MomoRC-tech/MoGliFC-Flight-Controller/development/layout study.pptx

MoGliFC

ELRS ?

WIFI

STM32H743

UART 1-8

PWM1-8

ADC 1-4

BEC 6s->5V

BEEPER

WS2811 LED PWM

LDO MCU 5V->3.3V

LDO SENS 5V->3.3V

LEDs:
3V3 (r)
FC stat1 (g)
FC stat2 (b)

Boot Switch

BEC 6s->10V

IMU
BMI270

SPI1

I2C 2

Ext. I2C

Servo-Board

BEC VX 6s->5V

OSD
MAX7456

SPI2

Ext. SPI ?

Servo Out
1-8

FLASH
W25N01G

SPI3

(FD-) CAN
TJA1057GTK/3Z

BARO
DPS310

I2C 1

USB-C

MAG
HMC5883

I2C 1

SWD debug

## Slide 2

## Slide 3
