MomoRC-tech/MoGliFC-Flight-Controller/development/Requirements.xlsx

Sheet: requirements
domain | Wing | Drone | element | Requirement | component | bus
system | x | x | MCU | STM32H7xx w. FD-Can | STM32H743VIT6, 480MHz , 1MB RAM, 2MB Flash
system | x | x | IMU | 1, SPI | MPU6000, BMI088, ICM42688P (NOISE!), MPU9250 (w.magnetometer) | SPI
system |  |  | IMU2 | ???
system | x | x | Baro | 1 | Infineon DPS310 (I2C2) | I2C
system | x | x | OSD | 1, SPI | AT7456E (SPI2) | SPI
system | x | x | Blackbox | external flash | W25N01G (128MB) | SPI
system |  | x | Current sensor | ? (90A cont, 200A peak)
system | x | x | voltage sensing | 1 (2s - 6s)
system | x | x | LED | 3x LEDs for FC STATUS and 3.3V
system | x | x | Magnetometer | 1 | HMC5883 | I2C
system
system |  |  | VTX | ????
interfaces | x | x | UART | >4
interfaces | x |  | UART | inverted/non inverted selectable
interfaces | x | x | PWM out | >=8 (generic)
interfaces | x |  | I2C | 2
interfaces | x | x | CAN | 1x CAN-FD | TJA1057BTK TJA1057GTK/3 with silent pin
interfaces | x | x | ADC | 4 (VBAT, current, RSSI, Analog AirSpeed)
interfaces |  |  | JTAG | none
interfaces | x | x | SWD debug | 1x
interfaces | x |  | SPI breakout | (?)
interfaces | x | x | SPI internal | 2
interfaces | x |  | USB/Beep Extender with Typ-C (USB2.0) | 1
interfaces |  |  | Dual-Camera switching | (?)
interfaces | x | x | boot switch | 1
interfaces |  |  | softserial | softserial TX out support
interfaces |  |  | connector | JST connectors ???
interfaces | x | x | connector | USB-C onboard connector (flat)
interfaces | x | x | connector | 2nd USB-C daughter board connector
power | x | x | battery voltage | 2s - 6s
power | x | x | 5V BEC rail
power | x | x | parallel USB-in and battery protection
power | x | x | 3.3V rail
power | x |  | HV BEC rail | 4 PWM out must be configurable (solder bridge) for HV servos, 6-8.4V (2S), via external HV BEC
power | x | x | VTX camera power source | 5V/9V(12V) for camera/VTX switchable
power | x | x | OSD | OSD power configurable on/off (solder bridge)
power |  |  | ESC +/- and battery pads | ?
 |  |  | LED mode switch (see mamba MK4 H743)

Sheet: H743 target definition
 |  | MoGliFC | Matek | Mamba | implemented?
group | function | PIN | PIN | PIN
LED | LED0 blue | PE3 | PE3 | PE5
LED | LED1 green | PE4 | PE4 | PE4
Beeper | Bepper inv. | PA15 | PA15 | PE3
SPI1: IMU MP6000
SPI1 | SPI1_SCK_PIN | PA5 | PA5 | PA5
SPI1 | SPI1_MISO_PIN | PA6 | PA6 | PA6
SPI1 | SPI1_MOSI_PIN | PD7 | PD7 | PA7
SPI1 | MPU6000_CS_PIN | PC15 | PC15 | PA4

Sheet: Power calc
Calculated max. Power per component/rail
3V3 FC:
SUM | STM32H7 | Flash | Baro | Mag | IMU | OSD | external
1.00 A | 0.50 A | 0.00 A | 0.00 A | 0.00 A | 0.00 A | 0.20 A | 0.30 A
ELRS:
SUM | ESP32 pico D4 | SX1280 1 | AT2401C 1 | SX1280 2 | AT2401C 2
1.00 A
LDO loss:
Architecture:
 |  | U [V] | I[A] | P_loss[W]
Ubat |  | 20
 | loss
5V |  | 5 | 1
 | loss |  |  | 1.7
3V3 |  | 3.3 | 1

Sheet: price
price
STM32H7 | 7
flash | 1
Baro DPS310 | 1.4
BMI270 | 1.8
AT7456 OSD | 4.5
BEC 5V FC | 2.5
BEC 5V Vx | 3
BEC 10V | 2
LDOs | 2
CAN | 0.8
zeugs | 4
SUMME | 30
