MomoRC-tech/MoGliFC-Flight-Controller/development/01_datasheets/02_expressLRS/pico elrs standard pins.GIF

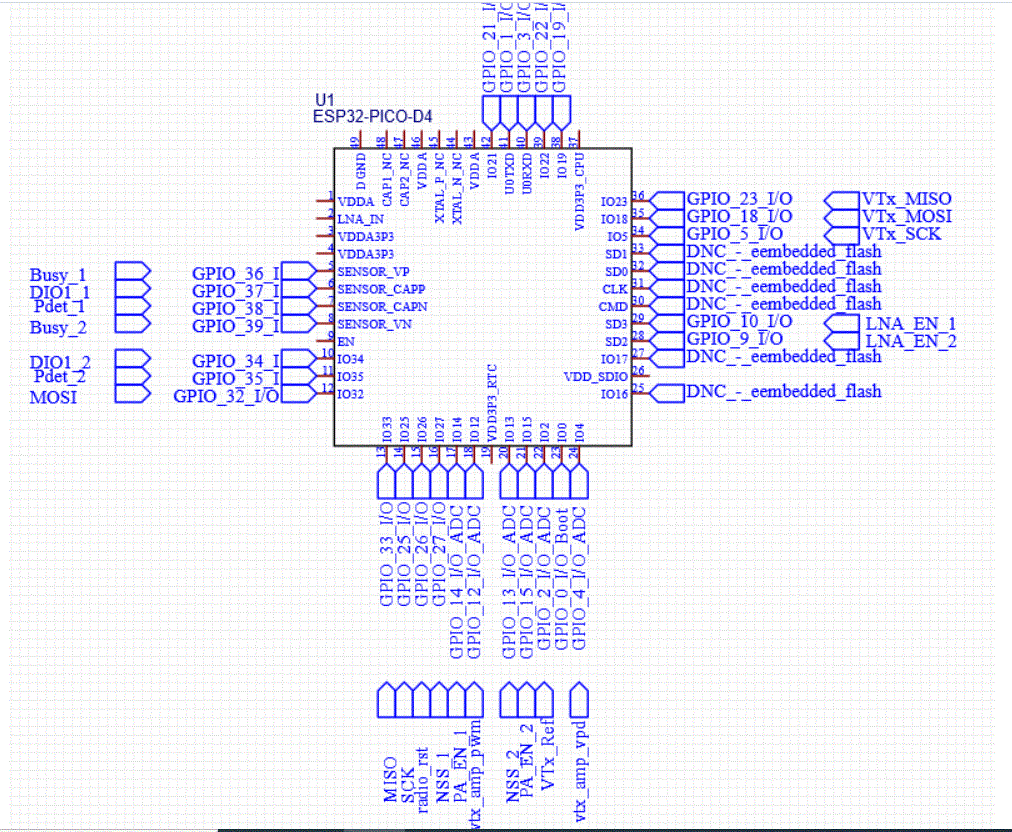
development/01_datasheets/02_expressLRS/pico elrs standard pins.GIF
