MomoRC-tech/MoGliFC-Flight-Controller/development/01_datasheets/02_expressLRS/SX1280 ref schematic.GIF

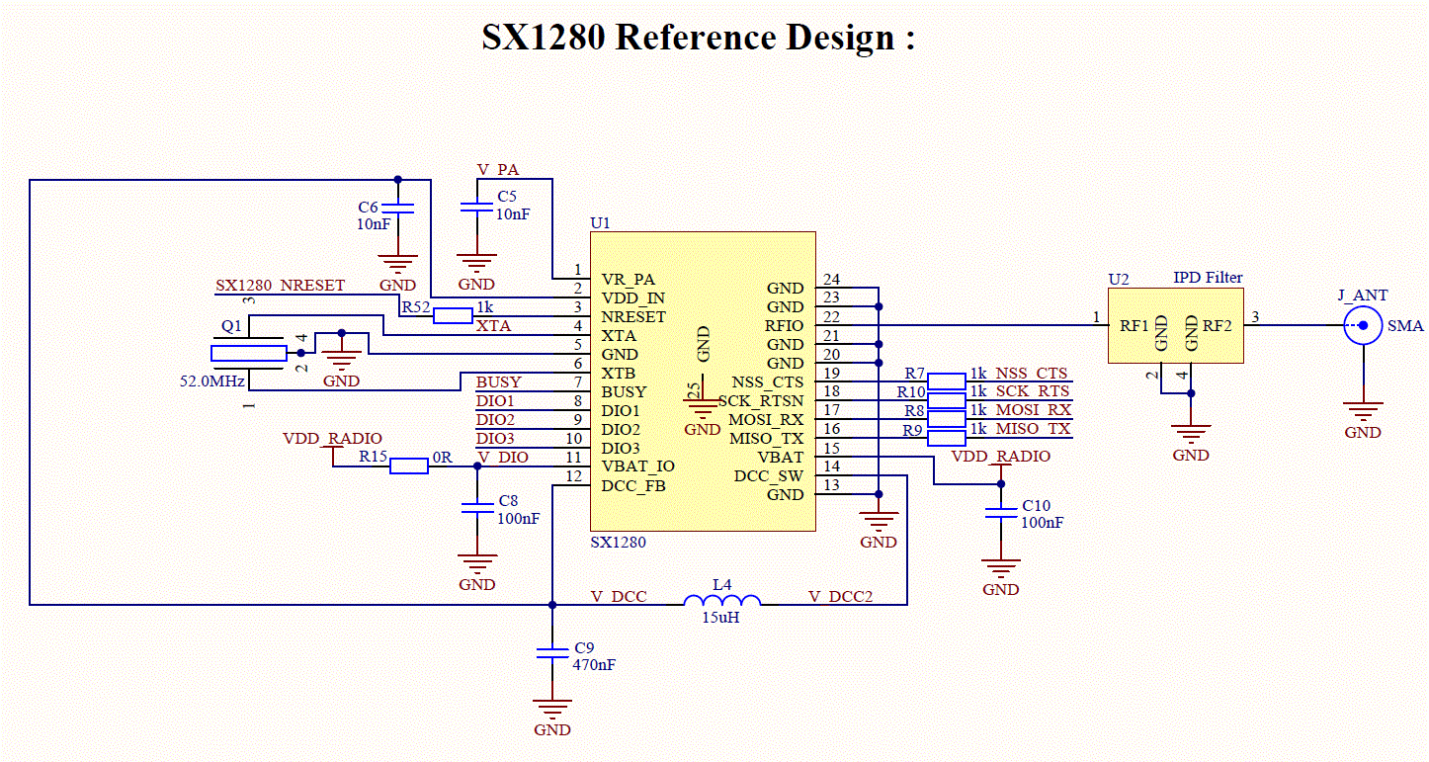
development/01_datasheets/02_expressLRS/SX1280 ref schematic.GIF
