MomoRC-tech/MoGliFC-Flight-Controller/development/10_KiCAD FC/images/BEC_FC.jpg

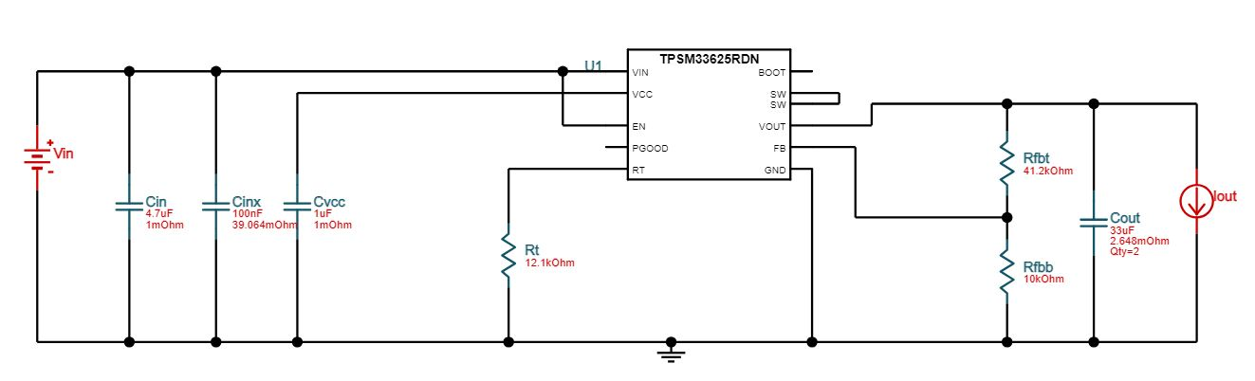
development/10_KiCAD FC/images/BEC_FC.jpg
