MomoRC-tech/MoGliFC-Flight-Controller/development/10_KiCAD FC/images/BEC_VTX.JPG

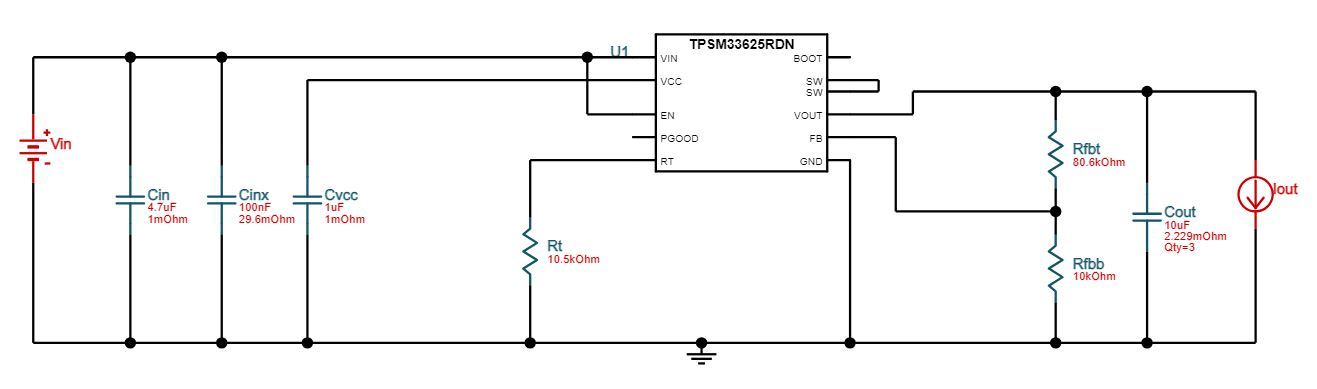
development/10_KiCAD FC/images/BEC_VTX.JPG
