MomoRC-tech/MoGliFC-Flight-Controller/development/10_KiCAD FC/images/BMI270_orientation.PNG

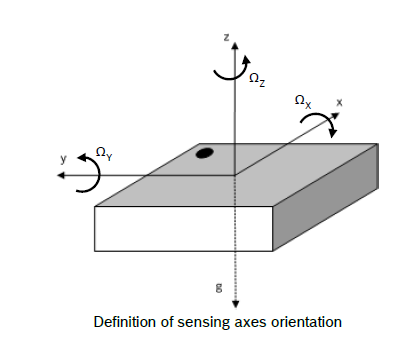
development/10_KiCAD FC/images/BMI270_orientation.PNG
