MomoRC-tech/MoGliFC-Flight-Controller/development/10_KiCAD FC/images/HMC5883L_orientation.PNG

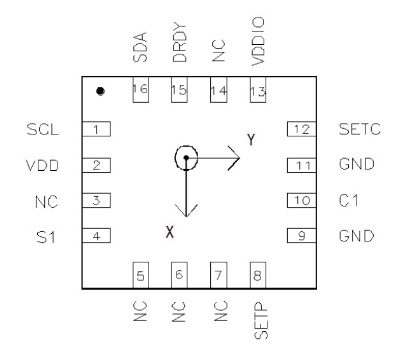
development/10_KiCAD FC/images/HMC5883L_orientation.PNG
