MomoRC-tech/MoGliFC-Flight-Controller/development/10_KiCAD FC/images/LP5912.PNG

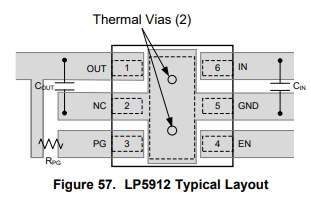
development/10_KiCAD FC/images/LP5912.PNG
