MomoRC-tech/MoGliFC-Flight-Controller/development/10_KiCAD FC/images/ReversePolarityProtection.JPG

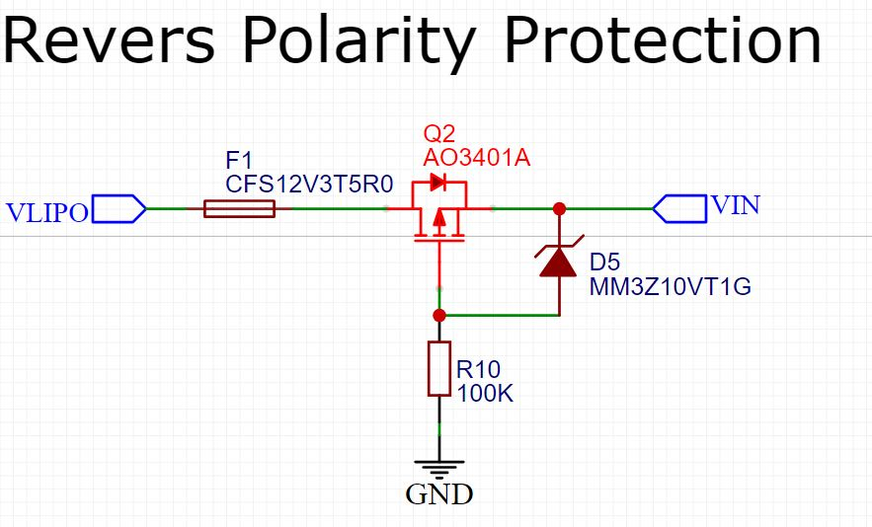
development/10_KiCAD FC/images/ReversePolarityProtection.JPG
