MomoRC-tech/MoGliFC-Flight-Controller/documentation/images/BOPLA_ALUBOS.png

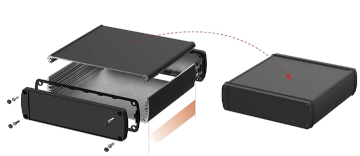
documentation/images/BOPLA_ALUBOS.png
