MomoRC-tech/MoGliFC-Flight-Controller/development/defines_INAV_H7_targets.xlsx

Sheet: Sheet
TARGETs in sheet: | 12
Define | # EMPTY CELLS | MOGLIFC |  | MAMBAH743 | MATEKH743 | AOCODARCH7DUAL | FOXEERH743 | IFLIGHT_2RAW_H743 | IFLIGHT_BLITZ_H7_PRO | IFLIGHT_H743_AIO_V2 | JHEH7AIO | JHEMCUH743HD | KAKUTEH7 | KAKUTEH7WING | NEUTRONRCH7BT | SDMODELH7V1 | SKYSTARSH743HD
TARGET_BOARD_IDENTIFIER | 14 |  |  | "M743" | "H743" | "AOH7" | "F743" | "2RH7" | "IB7P" | "IF7A" | "JH7A" | "JHEH743HD" | "KH7M" | "KH7W" | "NH7BT" | "SMH71" | "SSH7"
USBD_PRODUCT_STRING | 13 | "MOMOFCH743" |  | "MAMBAH743" |  | "AocodaRCH7Dual" | "FOXEERH743" | "IFLIGHT_2RAW_H743" | "IFLIGHT_BLITZ_H7_PRO" | "IFLIGHT_H743_AIO_V2" | "JHEH743AIO" | "JHEMCUH743HD" | "KAKUTEH7MINI" | "KAKUTEH7WING" | "NeuronRC H7 BT" | "SDMODELH7V1" | "SKYSTARSH743HD"
USE_TARGET_CONFIG | 13 | x |  | x | x | x | x |  | x | x | x | x | x | x | x | x | x
LED0 | 14 | PE5 | x | PE5 | PE3 | PE3 | PC13 | PE3 | PE3 | PC13 | PC13 | PE5 | PC2 | PC15 | PE3 | PC2 | PE3
LED1 | 9 | PE4 | x | PE4 | PE4 | PE4 |  | PE4 | PE4 |  |  | PE4 |  | PC14 | PE4 |  | PE4
BEEPER | 12 | PE3 | x | PE3 | PA15 | PA15 | PD2 | PC9 | PA15 |  |  | PE3 | PC13 | PB9 | PA15 | PC13 | PB3
BEEPER_INVERTED | 14 |  |  | x | x | x | x | x | x | x | x | x | x | x | x | x | x
BEEPER_PWM_FREQUENCY | 2 | 2500 |  |  | 2500 | 2500
USE_DUAL_GYRO | 5 | - |  | x | x | x |  |  |  |  |  | x |  |  |  |  | x
USE_TARGET_IMU_HARDWARE_DESCRIPTORS | 6 | x |  | x | x | x |  |  |  |  |  | x |  | x |  |  | x
USE_SPI | 14 | x |  | x | x | x | x | x | x | x | x | x | x | x | x | x | x
USE_SPI_DEVICE_1 | 14 | x |  | x | x | x | x | x | x | x | x | x | x | x | x | x | x
SPI1_SCK_PIN | 14 | PA5 |  | PA5 | PA5 | PA5 | PA5 | PA5 | PA5 | PA5 | PA5 | PA5 | PA5 | PA5 | PA5 | PA5 | PA5
SPI1_MISO_PIN | 14 | PA6 |  | PA6 | PA6 | PA6 | PA6 | PA6 | PA6 | PA6 | PA6 | PA6 | PA6 | PA6 | PA6 | PA6 | PA6
SPI1_MOSI_PIN | 14 | PA7 |  | PA7 | PD7 | PD7 | PA7 | PD7 | PD7 | PA7 | PA7 | PA7 | PA7 | PA7 | PD7 | PA7 | PD7
USE_IMU_MPU6000 | 9 | - |  | x | x | x | x |  |  | x | x | x | x |  |  | x
IMU_MPU6000_ALIGN | 9 | - |  | CW180_DEG | CW0_DEG_FLIP | CW0_DEG | CW0_DEG |  |  | CW0_DEG | CW0_DEG | CW180_DEG | CW270_DEG |  |  | CW270_DEG
MPU6000_SPI_BUS | 9 | - |  | BUS_SPI1 | BUS_SPI1 | BUS_SPI1 | BUS_SPI2 |  |  | BUS_SPI1 | BUS_SPI1 | BUS_SPI1 | BUS_SPI4 |  |  | BUS_SPI4
MPU6000_CS_PIN | 9 | - |  | PA4 | PC15 | PC15 | PB12 |  |  | SPI1_NSS_PIN | SPI1_NSS_PIN | PA4 | PE4 |  |  | PE4
MPU6000_EXTI_PIN | 1 | - |  |  |  | PB2
USE_IMU_BMI270 | 8 | x |  | x |  | x |  |  |  | x |  | x | x |  | x | x | x
IMU_BMI270_ALIGN_1 | 1 | - |  |  |  | CW90_DEG
BMI270_SPI_BUS_1 | 1 | - |  |  |  | BUS_SPI1
BMI270_CS_PIN_1 | 1 | - |  |  |  | PC15
BMI270_EXTI_PIN_1 | 1 | - |  |  |  | PB2
USE_SPI_DEVICE_4 | 10 |  |  | x | x | x |  |  | x | x | x |  | x |  | x | x | x
SPI4_SCK_PIN | 10 |  |  | PE12 | PE12 | PE12 |  |  | PE12 | PE2 | PE2 |  | PE2 |  | PE12 | PE2 | PE12
SPI4_MISO_PIN | 10 |  |  | PE13 | PE13 | PE13 |  |  | PE13 | PE5 | PE5 |  | PE5 |  | PE13 | PE5 | PE13
SPI4_MOSI_PIN | 10 |  |  | PE14 | PE14 | PE14 |  |  | PE14 | PE6 | PE6 |  | PE6 |  | PE14 | PE6 | PE14
IMU_BMI270_ALIGN_2 | 1 |  |  |  |  | CW180_DEG
BMI270_SPI_BUS_2 | 1 |  |  |  |  | BUS_SPI4
BMI270_CS_PIN_2 | 1 |  |  |  |  | PE11
BMI270_EXTI_PIN_2 | 1 |  |  |  |  | PE15
USE_SPI_DEVICE_2 | 13 | x |  | x |  | x | x | x | x | x | x | x | x | x | x | x | x
SPI2_SCK_PIN | 13 | PB13 |  | PB13 |  | PB13 | PB13 | PB13 | PB13 | PB13 | PB13 | PB13 | PB13 | PD3 | PB13 | PB13 | PB13
SPI2_MISO_PIN | 13 | PB14 |  | PB14 |  | PB14 | PB14 | PB14 | PB14 | PB14 | PB14 | PB14 | PB14 | PC2 | PB14 | PB14 | PB14
SPI2_MOSI_PIN | 13 | PB15 |  | PB15 |  | PB15 | PB15 | PB15 | PB15 | PB15 | PB15 | PB15 | PB15 | PC3 | PB15 | PB15 | PB15
USE_MAX7456 | 12 | x |  | x |  | x | x |  | x | x | x | x | x | x | x | x | x
MAX7456_SPI_BUS | 12 | BUS_SPI2 |  | BUS_SPI2 |  | BUS_SPI2 | BUS_SPI1 |  | BUS_SPI2 | BUS_SPI4 | BUS_SPI4 | BUS_SPI2 | BUS_SPI2 | BUS_SPI2 | BUS_SPI2 | BUS_SPI2 | BUS_SPI2
MAX7456_CS_PIN | 12 | PB12 |  | PB12 |  | PB12 | PA4 |  | PB12 | SPI4_NSS_PIN | SPI4_NSS_PIN | PB12 | PB12 | PB12 | PB12 | PB12 | PB12
USE_SPI_DEVICE_3 | 11 | x |  | x | x | x | x | x | x | x | x | x |  | x |  |  | x
SPI3_NSS_PIN | 6 | PA15 |  | PA15 |  | PD3 | PA15 |  |  | PA15 | PA15 | PA15
SPI3_SCK_PIN | 11 | PC10 |  | PC10 | PB3 | PB3 | PC10 | PC10 | PB3 | PC10 | PC10 | PC10 |  | PC10 |  |  | PC10
SPI3_MISO_PIN | 11 | PC11 |  | PC11 | PB4 | PB4 | PC11 | PC11 | PB4 | PC11 | PC11 | PC11 |  | PC11 |  |  | PC11
SPI3_MOSI_PIN | 11 | PB5 |  | PB2 | PB5 | PB5 | PC12 | PC12 | PB5 | PC12 | PC12 | PB2 |  | PC12 |  |  | PC12
SPI3_SCK_AF | 3 | GPIO_AF6_SPI3 |  | GPIO_AF6_SPI3 |  | GPIO_AF6_SPI3 |  |  |  |  |  | GPIO_AF6_SPI3
SPI3_MISO_AF | 3 | GPIO_AF6_SPI3 |  | GPIO_AF6_SPI3 |  | GPIO_AF6_SPI3 |  |  |  |  |  | GPIO_AF6_SPI3
SPI3_MOSI_AF | 3 | GPIO_AF7_SPI3 |  | GPIO_AF7_SPI3 |  | GPIO_AF7_SPI3 |  |  |  |  |  | GPIO_AF7_SPI3
W25N01G_SPI_BUS | 7 | BUS_SPI3 |  | BUS_SPI3 |  | BUS_SPI3 | BUS_SPI3 |  |  |  |  | BUS_SPI3 | BUS_SPI1 |  |  | BUS_SPI1 | BUS_SPI3
W25N01G_CS_PIN | 7 | SPI3_NSS_PIN |  | SPI3_NSS_PIN |  | SPI3_NSS_PIN | SPI3_NSS_PIN |  |  |  |  | SPI3_NSS_PIN | PA4 |  |  | PA4 | PA15
USE_BLACKBOX | 4 | x |  | x |  | x | x |  |  |  |  | x
USE_FLASHFS | 9 | x |  | x |  | x | x |  |  | x | x | x | x |  |  | x | x
USE_FLASH_W25N01G | 6 | x |  | x |  | x | x |  |  |  |  | x | x |  |  | x
ENABLE_BLACKBOX_LOGGING_ON_SPIFLASH_BY_DEFAULT | 9 | x |  | x |  | x | x |  |  | x | x | x | x |  |  | x | x
USE_I2C | 14 | x |  | x | x | x | x | x | x | x | x | x | x | x | x | x | x
USE_I2C_DEVICE_1 | 14 | x |  | x | x | x | x | x | x | x | x | x | x | x | // I2C1 is the broken out I2C bus | x | x
I2C1_SCL | 14 | PB6 |  | PB6 | PB6 | PB6 | PB8 | PB6 | PB6 | PB8 | PB8 | PB6 | PB6 | PB8 | PB6 | PB6 | PB8
I2C1_SDA | 14 | PB7 |  | PB7 | PB7 | PB7 | PB9 | PB7 | PB7 | PB9 | PB9 | PB7 | PB7 | PB7 | PB7 | PB7 | PB9
USE_I2C_DEVICE_2 | 10 | x |  | x | x | x |  | x | x | x |  | x |  | x | // I2C2 is not broken out |  | x
I2C2_SCL | 10 | PB10 |  | PB10 | PB10 | PB10 |  | PB10 | PB10 | PB10 |  | PB10 |  | PB10 | PB10 |  | PB10
I2C2_SDA | 10 | PB11 |  | PB11 | PB11 | PB11 |  | PB11 | PB11 | PB11 |  | PB11 |  | PB11 | PB11 |  | PB11
USE_BARO | 14 | x |  | x | x | x | x | x | x | x | x | x | x | x | x | x | x
BARO_I2C_BUS | 14 | BUS_I2C1 |  | BUS_I2C1 | BUS_I2C2 | BUS_I2C2 | BUS_I2C1 | BUS_I2C2 | BUS_I2C2 | BUS_I2C1 | BUS_I2C1 | BUS_I2C1 | BUS_I2C1 | BUS_I2C4 | BUS_I2C2 | BUS_I2C1 | BUS_I2C2
USE_BARO_BMP280 | 11 | x |  | x | x | x | x |  |  | x | x |  | x | x | x | x | x
USE_BARO_MS5611 | 11 | x |  | x | x | x | x |  |  | x | x |  | x | x | x | x | x
USE_BARO_DPS310 | 11 | x |  | x | x | x | x |  |  | x | x |  | x | x | x | x | x
USE_BARO_SPL06 | 9 | - |  | x | x | x | x |  |  |  |  |  | x | x | x | x | x
USE_MAG | 14 | x |  | x | x | x | x | x | x | x | x | x | x | x | x | x | x
MAG_I2C_BUS | 14 | BUS_I2C1 |  | BUS_I2C1 | BUS_I2C1 | BUS_I2C1 | BUS_I2C1 | BUS_I2C1 | BUS_I2C1 | BUS_I2C2 | BUS_I2C1 | BUS_I2C1 | BUS_I2C1 | BUS_I2C1 | BUS_I2C1 | BUS_I2C1 | BUS_I2C1
USE_MAG_ALL | 14 | x |  | x | x | x | x | x | x | x | x | x | x | x | x | x | x
TEMPERATURE_I2C_BUS | 14 | BUS_I2C1 |  | BUS_I2C1 | BUS_I2C2 | BUS_I2C1 | BUS_I2C1 | BUS_I2C1 | BUS_I2C2 | BUS_I2C2 | BUS_I2C1 | BUS_I2C1 | BUS_I2C1 | BUS_I2C2 | BUS_I2C1 | BUS_I2C1 | BUS_I2C1
PITOT_I2C_BUS | 14 | BUS_I2C1 |  | BUS_I2C1 | BUS_I2C2 | BUS_I2C1 | BUS_I2C1 | BUS_I2C1 | BUS_I2C2 | BUS_I2C2 | BUS_I2C1 | BUS_I2C1 | BUS_I2C1 | BUS_I2C2 | BUS_I2C1 | BUS_I2C1 | BUS_I2C1
USE_RANGEFINDER | 13 | x |  | x | x | x | x |  | x | x | x | x | x | x | x | x | x
RANGEFINDER_I2C_BUS | 14 | BUS_I2C1 |  | BUS_I2C1 | BUS_I2C1 | BUS_I2C1 | BUS_I2C1 | BUS_I2C1 | BUS_I2C1 | BUS_I2C2 | BUS_I2C1 | BUS_I2C1 | BUS_I2C1 | BUS_I2C2 | BUS_I2C1 | BUS_I2C1 | BUS_I2C1
USE_VCP | 14 | x |  | x | x | x | x | x | x | x | x | x | x | x | x | x | x
VBUS_SENSING_PIN | 2 | - |  |  |  | PE2 |  |  |  |  |  |  |  | PA9
VBUS_SENSING_ENABLED | 2 | - |  |  |  | x |  |  |  |  |  |  |  | x
USE_UART1 | 14 | x |  | x | x | x | x | x | x | x | x | x | x | x | x | x | x
UART1_TX_PIN | 14 | PA9 |  | PA9 | PA9 | PA9 | PA9 | PA9 | PA9 | PA9 | PA9 | PA9 | PA9 | PB6 | PA9 | PA9 | PA9
UART1_RX_PIN | 14 | PA10 |  | PA10 | PA10 | PA10 | PA10 | PA10 | PA10 | PA10 | PA10 | PA10 | PA10 | PA10 | PA10 | PA10 | PA10
USE_UART2 | 14 | x |  | x | x | x | x | x | x | x | x | x | x | x | x | x | x
UART2_TX_PIN | 14 | PD5 |  | PD5 | PD5 | PD5 | PA2 | PD5 | PD5 | PA2 | PA2 | PD5 | PD5 | PD5 | PD5 | PD5 | PD5
UART2_RX_PIN | 14 | PD6 |  | PD6 | PD6 | PD6 | PA3 | PD6 | PD6 | PA3 | PA3 | PD6 | PD6 | PD6 | PD6 | PD6 | PD6
USE_UART3 | 13 | x |  | x | x | x | x | x | x |  | x | x | x | x | x | x | x
UART3_TX_PIN | 13 | PD8 |  | PD8 | PD8 | PD8 | PB10 | PD8 | PD8 |  | PB10 | PD8 | PD8 | PD8 | PD8 | PD8 | PD8
UART3_RX_PIN | 13 | PD9 |  | PD9 | PD9 | PD9 | PB11 | PD9 | PD9 |  | PB11 | PD9 | PD9 | PD9 | PD9 | PD9 | PD9
USE_UART4 | 13 | x |  | x | x | x | x | x | x | x | x | x | x |  | x | x | x
UART4_TX_PIN | 13 | PB9 |  | PD1 | PB9 | PB9 | PA0 | PB9 | PB9 | PA0 | PA0 | PD1 | PD1 |  | PB9 | PD1 | PD1
UART4_RX_PIN | 13 | PB8 |  | PD0 | PB8 | PB8 | PA1 | PB8 | PB8 | PA1 | PA1 | PD0 | PD0 |  | PB8 | PD0 | PD0
USE_UART5 | 4 | x |  | x |  |  |  |  |  |  |  | x |  | x |  |  | x
UART5_TX_PIN | 4 | PC12 |  | PC12 |  |  |  |  |  |  |  | PC12 |  | PB13 |  |  | PB6
UART5_RX_PIN | 4 | PD2 |  | PD2 |  |  |  |  |  |  |  | PD2 |  | PD2 |  |  | PB5
USE_UART6 | 14 | x |  | x | x | x | x | x | x | x | x | x | x | x | x | x | x
UART6_TX_PIN | 14 | PC6 |  | PC6 | PC6 | PC6 | PC6 | PC6 | PC6 | PC6 | PC6 | PC6 | PC6 | PC6 | PC6 | PC6 | PC6
UART6_RX_PIN | 14 | PC7 |  | PC7 | PC7 | PC7 | PC7 | PC7 | PC7 | PC7 | PC7 | PC7 | PC7 | PC7 | PC7 | PC7 | PC7
USE_UART7 | 14 | x |  | x | x | x | x | x | x | x | x | x | x | x | x | x | x
UART7_TX_PIN | 12 | PE8 |  | PE8 | PE8 | PE8 | PE8 | PE8 | PE8 | PE8 | PE8 | PE8 |  | PE8 | PE8 |  | PE8
UART7_RX_PIN | 14 | PE7 |  | PE7 | PE7 | PE7 | PE7 | PE7 | PE7 | PE7 | PE7 | PE7 | PE7 | PE7 | PE7 | PE7 | PE7
USE_UART8 | 12 | x |  | x | x | x | x | x | x | x | x | x |  | x | x |  | x
UART8_TX_PIN | 12 | PE1 |  | PE1 | PE1 | PE1 | PE1 | PE1 | PE1 | PE1 | PE1 | PE1 |  | PE1 | PE1 |  | PE1
UART8_RX_PIN | 12 | PE0 |  | PE0 | PE0 | PE0 | PE0 | PE0 | PE0 | PE0 | PE0 | PE0 |  | PE0 | PE0 |  | PE0
SERIAL_PORT_COUNT | 14 | 9 |  | 9 | 9 | 8 | 8 | 8 | 8 | 7 | 8 | 9 | 7 | 8 | 8 | 7 | 9
DEFAULT_RX_TYPE | 14 | RX_TYPE_SERIAL |  | RX_TYPE_SERIAL | RX_TYPE_SERIAL | RX_TYPE_SERIAL | RX_TYPE_SERIAL | RX_TYPE_SERIAL | RX_TYPE_SERIAL | RX_TYPE_SERIAL | RX_TYPE_SERIAL | RX_TYPE_SERIAL | RX_TYPE_SERIAL | RX_TYPE_SERIAL | RX_TYPE_SERIAL | RX_TYPE_SERIAL | RX_TYPE_SERIAL
SERIALRX_PROVIDER | 14 | SERIALRX_CRSF |  | SERIALRX_SBUS | SERIALRX_CRSF | SERIALRX_SBUS | SERIALRX_SBUS | SERIALRX_CRSF | SERIALRX_CRSF | SERIALRX_CRSF | SERIALRX_CRSF | SERIALRX_SBUS | SERIALRX_SBUS | SERIALRX_SBUS | SERIALRX_SBUS | SERIALRX_SBUS | SERIALRX_SBUS
USE_ADC | 14 | x |  | x | x | x | x | x | x | x | x | x | x | x | x | x | x
ADC_INSTANCE | 14 | ADC3 |  | ADC3 | ADC1 | ADC1 | ADC3 | ADC1 | ADC1 | ADC3 | ADC3 | ADC3 | ADC1 | ADC1 | ADC1 | ADC1 | ADC1
ADC_CHANNEL_1_PIN | 14 | PC1 |  | PC1 | PC0 //ADC123 VBAT1 | PC0 //ADC123 VBAT1 | PC3 | PC0 | PC0 //ADC123 VBAT1 | PC3 | PC3 | PC1 | PC0 | PC5 //VBAT1 | PC0 // VBAT1 | PC0 | PC0 //ADC123 VBAT1
ADC_CHANNEL_2_PIN | 14 | PC3 |  | PC3 | PC1 //ADC123 CURR1 | PC1 //ADC123 CURR1 | PC5 | PC1 | PC1 //ADC123 CURR1 | PC2 | PC2 | PC3 | PC5 | PC4 //CURR1 | PC1 // CURR1 | PC5 | PC1 //ADC123 CURR1
ADC_CHANNEL_3_PIN | 14 | PC2 |  | PC2 | PC5 //ADC12 RSSI | PC5 //ADC12 RSSI | PC2 | PC5 | PC5 //ADC12 RSSI | PC5 | PC5 | PC2 | PC1 | PC0 //RSSI | PC4 // AirS | PC1 | PC3 //ADC12 RSSI
ADC_CHANNEL_4_PIN | 8 | PC0 |  | PC0 | PC4 //ADC12 AirS | PC4 //ADC12 AirS |  | PC4 | PC4 //ADC12 AirS |  |  | PC0 |  |  | PA4 // VBAT2 |  | PC4 //ADC12 AirS
ADC_CHANNEL_5_PIN | 4 |  |  |  | PA4 //ADC12 VB2 | PA4 //ADC12 VB2 |  |  |  |  |  |  |  | PA3 //VB2 | PA7 // CURR2
ADC_CHANNEL_6_PIN | 3 |  |  |  | PA7 //ADC12 CU2 | PA7 //ADC12 CU2 |  |  |  |  |  |  |  | PA2 //CU2
VBAT_ADC_CHANNEL | 14 | ADC_CHN_1 |  | ADC_CHN_1 | ADC_CHN_1 | ADC_CHN_1 | ADC_CHN_1 | ADC_CHN_1 | ADC_CHN_1 | ADC_CHN_1 | ADC_CHN_1 | ADC_CHN_1 | ADC_CHN_1 | ADC_CHN_1 | ADC_CHN_1 | ADC_CHN_1 | ADC_CHN_1
CURRENT_METER_ADC_CHANNEL | 14 | ADC_CHN_2 |  | ADC_CHN_2 | ADC_CHN_2 | ADC_CHN_2 | ADC_CHN_3 | ADC_CHN_2 | ADC_CHN_2 | ADC_CHN_2 | ADC_CHN_2 | ADC_CHN_2 | ADC_CHN_3 | ADC_CHN_2 | ADC_CHN_2 | ADC_CHN_3 | ADC_CHN_2
RSSI_ADC_CHANNEL | 13 | ADC_CHN_3 |  | ADC_CHN_3 | ADC_CHN_3 | ADC_CHN_3 | ADC_CHN_2 | ADC_CHN_3 | ADC_CHN_3 | ADC_CHN_3 | ADC_CHN_3 | ADC_CHN_3 | ADC_CHN_2 | ADC_CHN_3 |  | ADC_CHN_2 | ADC_CHN_3
AIRSPEED_ADC_CHANNEL | 8 | ADC_CHN_4 |  | ADC_CHN_4 | ADC_CHN_4 | ADC_CHN_4 |  | ADC_CHN_4 | ADC_CHN_4 |  |  | ADC_CHN_4 |  |  | ADC_CHN_3 |  | ADC_CHN_4
USE_PINIO | 11 | x |  | x | x | x |  | x | x |  |  | x | x | x | x | x | x
USE_PINIOBOX | 11 | x |  | x | x | x |  | x | x |  |  | x | x | x | x | x | x
PINIO1_PIN | 11 | PD10 // VTX power switcher |  | PC5 | PD10 // VTX power switcher | PD10 // VTX power switcher |  | PD10 | PD10 // VTX power switcher |  |  | PC2 | PE13 | PC13 // VTX power switcher | PD10 // Vsw control | PE13 | PC5 // VTX power switcher
PINIO2_PIN | 11 | PD11 // 2xCamera switcher |  | PC5 | PD11 // 2xCamera switcher | PD11 // 2xCamera switcher |  | PD11 | PD11 // 2xCamera switcher |  |  | PC5 | PB11 | PE3 // 2xCamera switcher | PD11 // Cam1/Cam2 switch control | PB11 | PC2 // 2xCamera switcher
USE_LED_STRIP | 13 | x |  | x | x | x | x |  | x | x | x | x | x | x | x | x | x
WS2811_PIN | 13 | PA8 |  | PA8 | PA8 | PA8 | PA8 |  | PA8 | PA8 | PD12 | PA8 | PD12 | PA15 | PA8 | PD12 | PA8
DEFAULT_FEATURES | 14 | (FEATURE_OSD | FEATURE_TELEMETRY | FEATURE_CURRENT_METER | FEATURE_VBAT | FEATURE_TX_PROF_SEL | FEATURE_BLACKBOX) |  | (FEATURE_OSD | FEATURE_TELEMETRY | FEATURE_CURRENT_METER | FEATURE_VBAT | FEATURE_TX_PROF_SEL) | (FEATURE_OSD | FEATURE_TELEMETRY | FEATURE_CURRENT_METER | FEATURE_VBAT | FEATURE_TX_PROF_SEL | FEATURE_BLACKBOX) | (FEATURE_OSD | FEATURE_TELEMETRY | FEATURE_CURRENT_METER | FEATURE_VBAT | FEATURE_TX_PROF_SEL | FEATURE_BLACKBOX) | (FEATURE_OSD | FEATURE_TELEMETRY | FEATURE_CURRENT_METER | FEATURE_VBAT | FEATURE_TX_PROF_SEL) | (FEATURE_OSD | FEATURE_TELEMETRY | FEATURE_CURRENT_METER | FEATURE_VBAT | FEATURE_TX_PROF_SEL | FEATURE_BLACKBOX) | (FEATURE_OSD | FEATURE_TELEMETRY | FEATURE_CURRENT_METER | FEATURE_VBAT | FEATURE_TX_PROF_SEL | FEATURE_BLACKBOX) | (FEATURE_OSD | FEATURE_TELEMETRY | FEATURE_CURRENT_METER | FEATURE_VBAT | FEATURE_TX_PROF_SEL | FEATURE_BLACKBOX) | (FEATURE_OSD | FEATURE_TELEMETRY | FEATURE_CURRENT_METER | FEATURE_VBAT | FEATURE_TX_PROF_SEL | FEATURE_BLACKBOX) | (FEATURE_OSD | FEATURE_TELEMETRY | FEATURE_CURRENT_METER | FEATURE_VBAT | FEATURE_TX_PROF_SEL) | (FEATURE_OSD | FEATURE_TELEMETRY | FEATURE_CURRENT_METER | FEATURE_VBAT | FEATURE_TX_PROF_SEL | FEATURE_BLACKBOX) | (FEATURE_OSD | FEATURE_TELEMETRY | FEATURE_CURRENT_METER | FEATURE_VBAT | FEATURE_TX_PROF_SEL | FEATURE_BLACKBOX | FEATURE_GPS) | (FEATURE_OSD | FEATURE_TELEMETRY | FEATURE_CURRENT_METER | FEATURE_VBAT | FEATURE_TX_PROF_SEL | FEATURE_BLACKBOX) | (FEATURE_OSD | FEATURE_TELEMETRY | FEATURE_CURRENT_METER | FEATURE_VBAT | FEATURE_TX_PROF_SEL | FEATURE_BLACKBOX) | (FEATURE_OSD | FEATURE_TELEMETRY | FEATURE_CURRENT_METER | FEATURE_VBAT | FEATURE_TX_PROF_SEL | FEATURE_BLACKBOX)
CURRENT_METER_SCALE | 14 |  |  | 250 | 250 | 250 | 100 | 250 | 212 | 100 | 100 | 250 | 250 | 3660 // 36.6 | 250 | 250 | 290
USE_SERIAL_4WAY_BLHELI_INTERFACE | 14 | x |  | x | x | x | x | x | x | x | x | x | x | x | x | x | x
TARGET_IO_PORTA | 14 | 0xffff |  | 0xffff | 0xffff | 0xffff | 0xffff | 0xffff | 0xffff | 0xffff | 0xffff | 0xffff | 0xffff | 0xffff | 0xffff | 0xffff | 0xffff
TARGET_IO_PORTB | 14 | 0xffff |  | 0xffff | 0xffff | 0xffff | 0xffff | 0xffff | 0xffff | 0xffff | 0xffff | 0xffff | 0xffff | 0xffff | 0xffff | 0xffff | 0xffff
TARGET_IO_PORTC | 14 | 0xffff |  | 0xffff | 0xffff | 0xffff | 0xffff | 0xffff | 0xffff | 0xffff | 0xffff | 0xffff | 0xffff | 0xffff | 0xffff | 0xffff | 0xffff
TARGET_IO_PORTD | 14 | 0xffff |  | 0xffff | 0xffff | 0xffff | 0xffff | 0xffff | 0xffff | 0xffff | 0xffff | 0xffff | 0xffff | 0xffff | 0xffff | 0xffff | 0xffff
TARGET_IO_PORTE | 14 | 0xffff |  | 0xffff | 0xffff | 0xffff | 0xffff | 0xffff | 0xffff | 0xffff | 0xffff | 0xffff | 0xffff | 0xffff | 0xffff | 0xffff | 0xffff
MAX_PWM_OUTPUT_PORTS | 14 | 8 |  | 8 | 15 | 15 | 8 | 12 | 12 | 4 | 4 | 8 | 8 | 14 | 8 | 8 | 10
USE_DSHOT | 14 | x |  | x | x | x | x | x | x | x | x | x | x | x | x | x | x
USE_ESC_SENSOR | 14 | x |  | x | x | x | x | x | x | x | x | x | x | x | x | x | x
M25P16_SPI_BUS | 7 | BUS_SPI3 |  | BUS_SPI3 |  |  | BUS_SPI3 |  |  | BUS_SPI3 | BUS_SPI3 | BUS_SPI3 | BUS_SPI1 |  |  |  | BUS_SPI3
M25P16_CS_PIN | 7 | SPI3_NSS_PIN |  | SPI3_NSS_PIN |  |  | SPI3_NSS_PIN |  |  | SPI3_NSS_PIN | SPI3_NSS_PIN | SPI3_NSS_PIN | PA4 |  |  |  | PA15
USE_FLASH_M25P16 | 7 | x |  | x |  |  | x |  |  | x | x | x | x |  |  |  | x
USE_IMU_ICM42605 | 7 | - |  | x | x |  |  | x | x |  |  | x | x | x
IMU_ICM42605_ALIGN | 7 | - |  | CW270_DEG | CW90_DEG_FLIP |  |  | CW0_DEG | CW0_DEG |  |  | CW180_DEG | CW270_DEG | CW90_DEG
ICM42605_SPI_BUS | 7 | - |  | BUS_SPI4 | BUS_SPI4 |  |  | BUS_SPI1 | BUS_SPI1 |  |  | BUS_SPI1 | BUS_SPI4 | BUS_SPI3
ICM42605_CS_PIN | 7 | - |  | PE11 | PC13 |  |  | PC15 | PC15 |  |  | PA4 | PE4 | PE12
USE_BARO_ALL | 3 |  |  |  |  |  |  | x | x |  |  | x
SERIALRX_UART | 10 |  |  |  | SERIAL_PORT_USART6 |  |  | SERIAL_PORT_USART6 | SERIAL_PORT_USART6 | SERIAL_PORT_USART4 | SERIAL_PORT_USART2 |  | SERIAL_PORT_USART1 | SERIAL_PORT_USART6 | SERIAL_PORT_USART6 | SERIAL_PORT_USART1 | SERIAL_PORT_USART1
USE_SDCARD | 6 | - |  |  | x |  |  | x | x |  |  |  | x | x | x
USE_SDCARD_SPI | 2 | - |  |  |  |  |  | x |  |  |  |  | x
SDCARD_SPI_BUS | 2 |  |  |  |  |  |  | BUS_SPI3 |  |  |  |  | BUS_SPI1
SDCARD_CS_PIN | 2 |  |  |  |  |  |  | PA15 |  |  |  |  | PA4
ENABLE_BLACKBOX_LOGGING_ON_SDCARD_BY_DEFAULT | 6 |  |  |  | x |  |  | x | x |  |  |  | x | x | x
VBAT_SCALE_DEFAULT | 3 |  |  |  |  |  |  | 2100 | 1135 |  |  |  |  | 1818 // 18.18
USE_SDCARD_SDIO | 4 |  |  |  | x |  |  |  | x |  |  |  |  | x | x
SDCARD_SDIO_DEVICE | 4 |  |  |  | SDIODEV_1 |  |  |  | SDIODEV_1 |  |  |  |  | SDIODEV_2 | SDIODEV_1
SDCARD_SDIO_4BIT | 4 |  |  |  | x |  |  |  | x |  |  |  |  | x | x
BEEPER_PIN | 2 |  |  |  |  |  |  |  |  | PD2 | PD15
SPI1_NSS_PIN | 2 |  |  |  |  |  |  |  |  | PA4 | PA4
IMU_BMI270_ALIGN | 6 | CW180_DEG |  | CW180_DEG |  |  |  |  |  | CW0_DEG |  | CW180_DEG | CW0_DEG |  | CW270_DEG | CW0_DEG
BMI270_CS_PIN | 6 | PA4 |  | PA4 |  |  |  |  |  | SPI1_NSS_PIN |  | PA4 | PE4 |  | PC15 | PE4
BMI270_SPI_BUS | 6 | BUS_SPI1 |  | BUS_SPI1 |  |  |  |  |  | BUS_SPI1 |  | BUS_SPI1 | BUS_SPI4 |  | BUS_SPI1 | BUS_SPI4
SPI2_NSS_PIN | 2 | -(OSD sep. define) |  |  |  |  |  |  |  | PB12 | PB12
SPI4_NSS_PIN | 2 |  |  |  |  |  |  |  |  | PE4 | PE4
SDCARD_DETECT_INVERTED | 1 |  |  |  |  |  |  |  |  |  |  |  | x
SDCARD_DETECT_PIN | 1 |  |  |  |  |  |  |  |  |  |  |  | PA3
PINIO1_FLAGS | 2 |  |  |  |  |  |  |  |  |  |  |  | PINIO_FLAGS_INVERTED |  |  | PINIO_FLAGS_INVERTED
PINIO2_FLAGS | 2 |  |  |  |  |  |  |  |  |  |  |  | PINIO_FLAGS_INVERTED |  |  | PINIO_FLAGS_INVERTED
USE_HARDWARE_PREBOOT_SETUP | 1 |  |  |  |  |  |  |  |  |  |  |  |  | x
USE_IMU_BMI088 | 1 |  |  |  |  |  |  |  |  |  |  |  |  | x
IMU_BMI088_ALIGN | 1 |  |  |  |  |  |  |  |  |  |  |  |  | CW0_DEG
BMI088_SPI_BUS | 1 |  |  |  |  |  |  |  |  |  |  |  |  | BUS_SPI1
BMI088_GYRO_CS_PIN | 1 |  |  |  |  |  |  |  |  |  |  |  |  | PC9
BMI088_GYRO_EXTI_PIN | 1 |  |  |  |  |  |  |  |  |  |  |  |  | PD10
BMI088_ACC_CS_PIN | 1 |  |  |  |  |  |  |  |  |  |  |  |  | PC8
BMI088_ACC_EXTI_PIN | 1 |  |  |  |  |  |  |  |  |  |  |  |  | PD11
ICM42605_EXTI_PIN | 1 |  |  |  |  |  |  |  |  |  |  |  |  | PE15
SDCARD_SDIO_NORMAL_SPEED | 1 |  |  |  |  |  |  |  |  |  |  |  |  | x
SDCARD_SDIO2_CMD_ALT | 1 |  |  |  |  |  |  |  |  |  |  |  |  | x
USE_I2C_DEVICE_4 | 1 |  |  |  |  |  |  |  |  |  |  |  |  | x
I2C4_SCL | 1 |  |  |  |  |  |  |  |  |  |  |  |  | PD12
I2C4_SDA | 1 |  |  |  |  |  |  |  |  |  |  |  |  | PD13
PINIO3_PIN | 3 |  |  |  |  |  |  |  |  |  |  |  |  | PD4 // User1 | PC3 // BT Mode |  | PD11
PINIO4_PIN | 1 |  |  |  |  |  |  |  |  |  |  |  |  | PE4 // User2
VBAT_SCALE_DEFAULT2 | 1 |  |  |  |  |  |  |  |  |  |  |  |  | 1100 // 11.0
USE_IMU_MPU6500 | 1 |  |  |  | x
IMU_MPU6500_ALIGN | 1 |  |  |  | CW0_DEG_FLIP
MPU6500_SPI_BUS | 1 |  |  |  | BUS_SPI4
MPU6500_CS_PIN | 1 |  |  |  | PE11
USE_MAG_RM3100 | 1 |  |  |  | x
RM3100_CS_PIN | 1 |  |  |  | PE2 //CS2 pad
RM3100_SPI_BUS | 1 |  |  |  | BUS_SPI3
USE_SOFTSERIAL1 | 1 |  |  |  | x
SOFTSERIAL_1_TX_PIN | 1 |  |  |  | PC6 //TX6 pad
SOFTSERIAL_1_RX_PIN | 1 |  |  |  | PC6 //TX6 pad
IMU1_ALIGN | 1 |  |  |  |  |  |  |  |  |  |  |  |  |  |  |  | CW0_DEG
IMU1_SPI_BUS | 1 |  |  |  |  |  |  |  |  |  |  |  |  |  |  |  | BUS_SPI4
IMU1_CS_PIN | 1 |  |  |  |  |  |  |  |  |  |  |  |  |  |  |  | PE11
IMU2_ALIGN | 1 |  |  |  |  |  |  |  |  |  |  |  |  |  |  |  | CW90_DEG
IMU2_SPI_BUS | 1 |  |  |  |  |  |  |  |  |  |  |  |  |  |  |  | BUS_SPI1
IMU2_CS_PIN | 1 |  |  |  |  |  |  |  |  |  |  |  |  |  |  |  | PC15
target.c
PWM1 |  | PA0 |  | DEF_TIM(TIM5, CH1, PA0, TIM_USE_OUTPUT_AUTO, 0, 0), // S1
PWM2 |  | PA1 |  | DEF_TIM(TIM5, CH2, PA1, TIM_USE_OUTPUT_AUTO, 0, 1), // S2
PWM3 |  | PA2 |  | DEF_TIM(TIM5, CH3, PA2, TIM_USE_OUTPUT_AUTO, 0, 2), // S3
PWM4 |  | PA3 |  | DEF_TIM(TIM5, CH4, PA3, TIM_USE_OUTPUT_AUTO, 0, 3), // S4
PWM5 |  | PB0 |  | DEF_TIM(TIM3, CH3, PB0, TIM_USE_OUTPUT_AUTO, 0, 4), // S5
PWM6 |  | PB1 |  | DEF_TIM(TIM3, CH4, PB1, TIM_USE_OUTPUT_AUTO, 0, 5), // S6
PWM7 |  | PC8 |  | DEF_TIM(TIM8, CH3, PC8, TIM_USE_OUTPUT_AUTO, 0, 6), // S7 // used to be fw motor
PWM8 |  | PC9 |  | DEF_TIM(TIM8, CH4, PC9, TIM_USE_OUTPUT_AUTO, 0, 7), // S8 // used to be fw motor
LED_2812 |  | PA8 |  | DEF_TIM(TIM1, CH1, PA8, TIM_USE_LED, 0, 9), // LED_2812

Sheet: PIVOT
 | Spaltenbeschriftungen
 | x |  | x Ergebnis | (Leer) |  | (Leer) Ergebnis | Gesamtergebnis
Zeilenbeschriftungen | x | (Leer) |  | x | (Leer)
USE_ADC
USE_BARO
USE_BARO_ALL
USE_BARO_BMP280
USE_BARO_DPS310
USE_BARO_MS5611
USE_BARO_SPL06
USE_BLACKBOX
USE_DSHOT
USE_DUAL_GYRO
USE_ESC_SENSOR
USE_FLASH_M25P16
USE_FLASH_W25N01G
USE_FLASHFS
USE_HARDWARE_PREBOOT_SETUP
USE_I2C
USE_I2C_DEVICE_1
USE_I2C_DEVICE_2
USE_I2C_DEVICE_4
USE_IMU_BMI088
USE_IMU_BMI270
USE_IMU_ICM42605
USE_IMU_MPU6000
USE_IMU_MPU6500
USE_LED_STRIP
USE_MAG
USE_MAG_ALL
USE_MAG_RM3100
USE_MAX7456
USE_PINIO
USE_PINIOBOX
USE_RANGEFINDER
USE_SDCARD
USE_SDCARD_SDIO
USE_SDCARD_SPI
USE_SERIAL_4WAY_BLHELI_INTERFACE
USE_SOFTSERIAL1
USE_SPI
USE_SPI_DEVICE_1
USE_SPI_DEVICE_2
USE_SPI_DEVICE_3
USE_SPI_DEVICE_4
USE_TARGET_CONFIG
USE_TARGET_IMU_HARDWARE_DESCRIPTORS
USE_UART1
USE_UART2
USE_UART3
USE_UART4
USE_UART5
USE_UART6
USE_UART7
USE_UART8
USE_VCP
Gesamtergebnis
