MomoRC-tech/MoGliFC-Flight-Controller/development/01_INAV Betaflight analysis/01_INAV target analysis script/defines.xlsx

Define | AOCODARCH7DUAL | FOXEERH743 | IFLIGHT_2RAW_H743 | IFLIGHT_BLITZ_H7_PRO | IFLIGHT_H743_AIO_V2 | JHEH7AIO | JHEMCUH743HD | KAKUTEH7 | KAKUTEH7WING | MAMBAH743 | MATEKH743 | NEUTRONRCH7BT | SDMODELH7V1 | SKYSTARSH743HD
TARGET_BOARD_IDENTIFIER | "AOH7" | "F743" | "2RH7" | "IB7P" | "IF7A" | "JH7A" | "JHEH743HD" | "KH7M" | "KH7W" | "M743" | "H743" | "NH7BT" | "SMH71" | "SSH7"
USBD_PRODUCT_STRING | "AocodaRCH7Dual" | "FOXEERH743" | "IFLIGHT_2RAW_H743" | "IFLIGHT_BLITZ_H7_PRO" | "IFLIGHT_H743_AIO_V2" | "JHEH743AIO" | "JHEMCUH743HD" | "KAKUTEH7MINI" | "KAKUTEH7WING" | "MAMBAH743" |  | "NeuronRC H7 BT" | "SDMODELH7V1" | "SKYSTARSH743HD"
USE_TARGET_CONFIG | x | x |  | x | x | x | x | x | x | x | x | x | x | x
LED0 | PE3 | PC13 | PE3 | PE3 | PC13 | PC13 | PE5 | PC2 | PC15 | PE5 | PE3 | PE3 | PC2 | PE3
LED1 | PE4 |  | PE4 | PE4 |  |  | PE4 |  | PC14 | PE4 | PE4 | PE4 |  | PE4
BEEPER | PA15 | PD2 | PC9 | PA15 |  |  | PE3 | PC13 | PB9 | PE3 | PA15 | PA15 | PC13 | PB3
BEEPER_INVERTED | x | x | x | x | x | x | x | x | x | x | x | x | x | x
BEEPER_PWM_FREQUENCY | 2500 |  |  |  |  |  |  |  |  |  | 2500
USE_DUAL_GYRO | x |  |  |  |  |  | x |  |  | x | x |  |  | x
USE_TARGET_IMU_HARDWARE_DESCRIPTORS | x |  |  |  |  |  | x |  | x | x | x |  |  | x
USE_SPI | x | x | x | x | x | x | x | x | x | x | x | x | x | x
USE_SPI_DEVICE_1 | x | x | x | x | x | x | x | x | x | x | x | x | x | x
SPI1_SCK_PIN | PA5 | PA5 | PA5 | PA5 | PA5 | PA5 | PA5 | PA5 | PA5 | PA5 | PA5 | PA5 | PA5 | PA5
SPI1_MISO_PIN | PA6 | PA6 | PA6 | PA6 | PA6 | PA6 | PA6 | PA6 | PA6 | PA6 | PA6 | PA6 | PA6 | PA6
SPI1_MOSI_PIN | PD7 | PA7 | PD7 | PD7 | PA7 | PA7 | PA7 | PA7 | PA7 | PA7 | PD7 | PD7 | PA7 | PD7
USE_IMU_MPU6000 | x | x |  |  | x | x | x | x |  | x | x |  | x
IMU_MPU6000_ALIGN | CW0_DEG | CW0_DEG |  |  | CW0_DEG | CW0_DEG | CW180_DEG | CW270_DEG |  | CW180_DEG | CW0_DEG_FLIP |  | CW270_DEG
MPU6000_SPI_BUS | BUS_SPI1 | BUS_SPI2 |  |  | BUS_SPI1 | BUS_SPI1 | BUS_SPI1 | BUS_SPI4 |  | BUS_SPI1 | BUS_SPI1 |  | BUS_SPI4
MPU6000_CS_PIN | PC15 | PB12 |  |  | SPI1_NSS_PIN | SPI1_NSS_PIN | PA4 | PE4 |  | PA4 | PC15 |  | PE4
MPU6000_EXTI_PIN | PB2
USE_IMU_BMI270 | x |  |  |  | x |  | x | x |  | x |  | x | x | x
IMU_BMI270_ALIGN_1 | CW90_DEG
BMI270_SPI_BUS_1 | BUS_SPI1
BMI270_CS_PIN_1 | PC15
BMI270_EXTI_PIN_1 | PB2
USE_SPI_DEVICE_4 | x |  |  | x | x | x |  | x |  | x | x | x | x | x
SPI4_SCK_PIN | PE12 |  |  | PE12 | PE2 | PE2 |  | PE2 |  | PE12 | PE12 | PE12 | PE2 | PE12
SPI4_MISO_PIN | PE13 |  |  | PE13 | PE5 | PE5 |  | PE5 |  | PE13 | PE13 | PE13 | PE5 | PE13
SPI4_MOSI_PIN | PE14 |  |  | PE14 | PE6 | PE6 |  | PE6 |  | PE14 | PE14 | PE14 | PE6 | PE14
IMU_BMI270_ALIGN_2 | CW180_DEG
BMI270_SPI_BUS_2 | BUS_SPI4
BMI270_CS_PIN_2 | PE11
BMI270_EXTI_PIN_2 | PE15
USE_SPI_DEVICE_2 | x | x | x | x | x | x | x | x | x | x |  | x | x | x
SPI2_SCK_PIN | PB13 | PB13 | PB13 | PB13 | PB13 | PB13 | PB13 | PB13 | PD3 | PB13 |  | PB13 | PB13 | PB13
SPI2_MISO_PIN | PB14 | PB14 | PB14 | PB14 | PB14 | PB14 | PB14 | PB14 | PC2 | PB14 |  | PB14 | PB14 | PB14
SPI2_MOSI_PIN | PB15 | PB15 | PB15 | PB15 | PB15 | PB15 | PB15 | PB15 | PC3 | PB15 |  | PB15 | PB15 | PB15
USE_MAX7456 | x | x |  | x | x | x | x | x | x | x |  | x | x | x
MAX7456_SPI_BUS | BUS_SPI2 | BUS_SPI1 |  | BUS_SPI2 | BUS_SPI4 | BUS_SPI4 | BUS_SPI2 | BUS_SPI2 | BUS_SPI2 | BUS_SPI2 |  | BUS_SPI2 | BUS_SPI2 | BUS_SPI2
MAX7456_CS_PIN | PB12 | PA4 |  | PB12 | SPI4_NSS_PIN | SPI4_NSS_PIN | PB12 | PB12 | PB12 | PB12 |  | PB12 | PB12 | PB12
USE_SPI_DEVICE_3 | x | x | x | x | x | x | x |  | x | x | x |  |  | x
SPI3_NSS_PIN | PD3 | PA15 |  |  | PA15 | PA15 | PA15 |  |  | PA15
SPI3_SCK_PIN | PB3 | PC10 | PC10 | PB3 | PC10 | PC10 | PC10 |  | PC10 | PC10 | PB3 |  |  | PC10
SPI3_MISO_PIN | PB4 | PC11 | PC11 | PB4 | PC11 | PC11 | PC11 |  | PC11 | PC11 | PB4 |  |  | PC11
SPI3_MOSI_PIN | PB5 | PC12 | PC12 | PB5 | PC12 | PC12 | PB2 |  | PC12 | PB2 | PB5 |  |  | PC12
SPI3_SCK_AF | GPIO_AF6_SPI3 |  |  |  |  |  | GPIO_AF6_SPI3 |  |  | GPIO_AF6_SPI3
SPI3_MISO_AF | GPIO_AF6_SPI3 |  |  |  |  |  | GPIO_AF6_SPI3 |  |  | GPIO_AF6_SPI3
SPI3_MOSI_AF | GPIO_AF7_SPI3 |  |  |  |  |  | GPIO_AF7_SPI3 |  |  | GPIO_AF7_SPI3
W25N01G_SPI_BUS | BUS_SPI3 | BUS_SPI3 |  |  |  |  | BUS_SPI3 | BUS_SPI1 |  | BUS_SPI3 |  |  | BUS_SPI1 | BUS_SPI3
W25N01G_CS_PIN | SPI3_NSS_PIN | SPI3_NSS_PIN |  |  |  |  | SPI3_NSS_PIN | PA4 |  | SPI3_NSS_PIN |  |  | PA4 | PA15
USE_BLACKBOX | x | x |  |  |  |  | x |  |  | x
USE_FLASHFS | x | x |  |  | x | x | x | x |  | x |  |  | x | x
USE_FLASH_W25N01G | x | x |  |  |  |  | x | x |  | x |  |  | x
ENABLE_BLACKBOX_LOGGING_ON_SPIFLASH_BY_DEFAULT | x | x |  |  | x | x | x | x |  | x |  |  | x | x
USE_I2C | x | x | x | x | x | x | x | x | x | x | x | x | x | x
USE_I2C_DEVICE_1 | x | x | x | x | x | x | x | x | x | x | x | // I2C1 is the broken out I2C bus | x | x
I2C1_SCL | PB6 | PB8 | PB6 | PB6 | PB8 | PB8 | PB6 | PB6 | PB8 | PB6 | PB6 | PB6 | PB6 | PB8
I2C1_SDA | PB7 | PB9 | PB7 | PB7 | PB9 | PB9 | PB7 | PB7 | PB7 | PB7 | PB7 | PB7 | PB7 | PB9
USE_I2C_DEVICE_2 | x |  | x | x | x |  | x |  | x | x | x | // I2C2 is not broken out |  | x
I2C2_SCL | PB10 |  | PB10 | PB10 | PB10 |  | PB10 |  | PB10 | PB10 | PB10 | PB10 |  | PB10
I2C2_SDA | PB11 |  | PB11 | PB11 | PB11 |  | PB11 |  | PB11 | PB11 | PB11 | PB11 |  | PB11
USE_BARO | x | x | x | x | x | x | x | x | x | x | x | x | x | x
BARO_I2C_BUS | BUS_I2C2 | BUS_I2C1 | BUS_I2C2 | BUS_I2C2 | BUS_I2C1 | BUS_I2C1 | BUS_I2C1 | BUS_I2C1 | BUS_I2C4 | BUS_I2C1 | BUS_I2C2 | BUS_I2C2 | BUS_I2C1 | BUS_I2C2
USE_BARO_BMP280 | x | x |  |  | x | x |  | x | x | x | x | x | x | x
USE_BARO_MS5611 | x | x |  |  | x | x |  | x | x | x | x | x | x | x
USE_BARO_DPS310 | x | x |  |  | x | x |  | x | x | x | x | x | x | x
USE_BARO_SPL06 | x | x |  |  |  |  |  | x | x | x | x | x | x | x
USE_MAG | x | x | x | x | x | x | x | x | x | x | x | x | x | x
MAG_I2C_BUS | BUS_I2C1 | BUS_I2C1 | BUS_I2C1 | BUS_I2C1 | BUS_I2C2 | BUS_I2C1 | BUS_I2C1 | BUS_I2C1 | BUS_I2C1 | BUS_I2C1 | BUS_I2C1 | BUS_I2C1 | BUS_I2C1 | BUS_I2C1
USE_MAG_ALL | x | x | x | x | x | x | x | x | x | x | x | x | x | x
TEMPERATURE_I2C_BUS | BUS_I2C1 | BUS_I2C1 | BUS_I2C1 | BUS_I2C2 | BUS_I2C2 | BUS_I2C1 | BUS_I2C1 | BUS_I2C1 | BUS_I2C2 | BUS_I2C1 | BUS_I2C2 | BUS_I2C1 | BUS_I2C1 | BUS_I2C1
PITOT_I2C_BUS | BUS_I2C1 | BUS_I2C1 | BUS_I2C1 | BUS_I2C2 | BUS_I2C2 | BUS_I2C1 | BUS_I2C1 | BUS_I2C1 | BUS_I2C2 | BUS_I2C1 | BUS_I2C2 | BUS_I2C1 | BUS_I2C1 | BUS_I2C1
USE_RANGEFINDER | x | x |  | x | x | x | x | x | x | x | x | x | x | x
RANGEFINDER_I2C_BUS | BUS_I2C1 | BUS_I2C1 | BUS_I2C1 | BUS_I2C1 | BUS_I2C2 | BUS_I2C1 | BUS_I2C1 | BUS_I2C1 | BUS_I2C2 | BUS_I2C1 | BUS_I2C1 | BUS_I2C1 | BUS_I2C1 | BUS_I2C1
USE_VCP | x | x | x | x | x | x | x | x | x | x | x | x | x | x
VBUS_SENSING_PIN | PE2 |  |  |  |  |  |  |  | PA9
VBUS_SENSING_ENABLED | x |  |  |  |  |  |  |  | x
USE_UART1 | x | x | x | x | x | x | x | x | x | x | x | x | x | x
UART1_TX_PIN | PA9 | PA9 | PA9 | PA9 | PA9 | PA9 | PA9 | PA9 | PB6 | PA9 | PA9 | PA9 | PA9 | PA9
UART1_RX_PIN | PA10 | PA10 | PA10 | PA10 | PA10 | PA10 | PA10 | PA10 | PA10 | PA10 | PA10 | PA10 | PA10 | PA10
USE_UART2 | x | x | x | x | x | x | x | x | x | x | x | x | x | x
UART2_TX_PIN | PD5 | PA2 | PD5 | PD5 | PA2 | PA2 | PD5 | PD5 | PD5 | PD5 | PD5 | PD5 | PD5 | PD5
UART2_RX_PIN | PD6 | PA3 | PD6 | PD6 | PA3 | PA3 | PD6 | PD6 | PD6 | PD6 | PD6 | PD6 | PD6 | PD6
USE_UART3 | x | x | x | x |  | x | x | x | x | x | x | x | x | x
UART3_TX_PIN | PD8 | PB10 | PD8 | PD8 |  | PB10 | PD8 | PD8 | PD8 | PD8 | PD8 | PD8 | PD8 | PD8
UART3_RX_PIN | PD9 | PB11 | PD9 | PD9 |  | PB11 | PD9 | PD9 | PD9 | PD9 | PD9 | PD9 | PD9 | PD9
USE_UART4 | x | x | x | x | x | x | x | x |  | x | x | x | x | x
UART4_TX_PIN | PB9 | PA0 | PB9 | PB9 | PA0 | PA0 | PD1 | PD1 |  | PD1 | PB9 | PB9 | PD1 | PD1
UART4_RX_PIN | PB8 | PA1 | PB8 | PB8 | PA1 | PA1 | PD0 | PD0 |  | PD0 | PB8 | PB8 | PD0 | PD0
USE_UART6 | x | x | x | x | x | x | x | x | x | x | x | x | x | x
UART6_TX_PIN | PC6 | PC6 | PC6 | PC6 | PC6 | PC6 | PC6 | PC6 | PC6 | PC6 | PC6 | PC6 | PC6 | PC6
UART6_RX_PIN | PC7 | PC7 | PC7 | PC7 | PC7 | PC7 | PC7 | PC7 | PC7 | PC7 | PC7 | PC7 | PC7 | PC7
USE_UART7 | x | x | x | x | x | x | x | x | x | x | x | x | x | x
UART7_TX_PIN | PE8 | PE8 | PE8 | PE8 | PE8 | PE8 | PE8 |  | PE8 | PE8 | PE8 | PE8 |  | PE8
UART7_RX_PIN | PE7 | PE7 | PE7 | PE7 | PE7 | PE7 | PE7 | PE7 | PE7 | PE7 | PE7 | PE7 | PE7 | PE7
USE_UART8 | x | x | x | x | x | x | x |  | x | x | x | x |  | x
UART8_TX_PIN | PE1 | PE1 | PE1 | PE1 | PE1 | PE1 | PE1 |  | PE1 | PE1 | PE1 | PE1 |  | PE1
UART8_RX_PIN | PE0 | PE0 | PE0 | PE0 | PE0 | PE0 | PE0 |  | PE0 | PE0 | PE0 | PE0 |  | PE0
SERIAL_PORT_COUNT | 8 | 8 | 8 | 8 | 7 | 8 | 9 | 7 | 8 | 9 | 9 | 8 | 7 | 9
DEFAULT_RX_TYPE | RX_TYPE_SERIAL | RX_TYPE_SERIAL | RX_TYPE_SERIAL | RX_TYPE_SERIAL | RX_TYPE_SERIAL | RX_TYPE_SERIAL | RX_TYPE_SERIAL | RX_TYPE_SERIAL | RX_TYPE_SERIAL | RX_TYPE_SERIAL | RX_TYPE_SERIAL | RX_TYPE_SERIAL | RX_TYPE_SERIAL | RX_TYPE_SERIAL
SERIALRX_PROVIDER | SERIALRX_SBUS | SERIALRX_SBUS | SERIALRX_CRSF | SERIALRX_CRSF | SERIALRX_CRSF | SERIALRX_CRSF | SERIALRX_SBUS | SERIALRX_SBUS | SERIALRX_SBUS | SERIALRX_SBUS | SERIALRX_CRSF | SERIALRX_SBUS | SERIALRX_SBUS | SERIALRX_SBUS
USE_ADC | x | x | x | x | x | x | x | x | x | x | x | x | x | x
ADC_INSTANCE | ADC1 | ADC3 | ADC1 | ADC1 | ADC3 | ADC3 | ADC3 | ADC1 | ADC1 | ADC3 | ADC1 | ADC1 | ADC1 | ADC1
ADC_CHANNEL_1_PIN | PC0 //ADC123 VBAT1 | PC3 | PC0 | PC0 //ADC123 VBAT1 | PC3 | PC3 | PC1 | PC0 | PC5 //VBAT1 | PC1 | PC0 //ADC123 VBAT1 | PC0 // VBAT1 | PC0 | PC0 //ADC123 VBAT1
ADC_CHANNEL_2_PIN | PC1 //ADC123 CURR1 | PC5 | PC1 | PC1 //ADC123 CURR1 | PC2 | PC2 | PC3 | PC5 | PC4 //CURR1 | PC3 | PC1 //ADC123 CURR1 | PC1 // CURR1 | PC5 | PC1 //ADC123 CURR1
ADC_CHANNEL_3_PIN | PC5 //ADC12 RSSI | PC2 | PC5 | PC5 //ADC12 RSSI | PC5 | PC5 | PC2 | PC1 | PC0 //RSSI | PC2 | PC5 //ADC12 RSSI | PC4 // AirS | PC1 | PC3 //ADC12 RSSI
ADC_CHANNEL_4_PIN | PC4 //ADC12 AirS |  | PC4 | PC4 //ADC12 AirS |  |  | PC0 |  |  | PC0 | PC4 //ADC12 AirS | PA4 // VBAT2 |  | PC4 //ADC12 AirS
ADC_CHANNEL_5_PIN | PA4 //ADC12 VB2 |  |  |  |  |  |  |  | PA3 //VB2 |  | PA4 //ADC12 VB2 | PA7 // CURR2
ADC_CHANNEL_6_PIN | PA7 //ADC12 CU2 |  |  |  |  |  |  |  | PA2 //CU2 |  | PA7 //ADC12 CU2
VBAT_ADC_CHANNEL | ADC_CHN_1 | ADC_CHN_1 | ADC_CHN_1 | ADC_CHN_1 | ADC_CHN_1 | ADC_CHN_1 | ADC_CHN_1 | ADC_CHN_1 | ADC_CHN_1 | ADC_CHN_1 | ADC_CHN_1 | ADC_CHN_1 | ADC_CHN_1 | ADC_CHN_1
CURRENT_METER_ADC_CHANNEL | ADC_CHN_2 | ADC_CHN_3 | ADC_CHN_2 | ADC_CHN_2 | ADC_CHN_2 | ADC_CHN_2 | ADC_CHN_2 | ADC_CHN_3 | ADC_CHN_2 | ADC_CHN_2 | ADC_CHN_2 | ADC_CHN_2 | ADC_CHN_3 | ADC_CHN_2
RSSI_ADC_CHANNEL | ADC_CHN_3 | ADC_CHN_2 | ADC_CHN_3 | ADC_CHN_3 | ADC_CHN_3 | ADC_CHN_3 | ADC_CHN_3 | ADC_CHN_2 | ADC_CHN_3 | ADC_CHN_3 | ADC_CHN_3 |  | ADC_CHN_2 | ADC_CHN_3
AIRSPEED_ADC_CHANNEL | ADC_CHN_4 |  | ADC_CHN_4 | ADC_CHN_4 |  |  | ADC_CHN_4 |  |  | ADC_CHN_4 | ADC_CHN_4 | ADC_CHN_3 |  | ADC_CHN_4
USE_PINIO | x |  | x | x |  |  | x | x | x | x | x | x | x | x
USE_PINIOBOX | x |  | x | x |  |  | x | x | x | x | x | x | x | x
PINIO1_PIN | PD10 // VTX power switcher |  | PD10 | PD10 // VTX power switcher |  |  | PC2 | PE13 | PC13 // VTX power switcher | PC5 | PD10 // VTX power switcher | PD10 // Vsw control | PE13 | PC5 // VTX power switcher
PINIO2_PIN | PD11 // 2xCamera switcher |  | PD11 | PD11 // 2xCamera switcher |  |  | PC5 | PB11 | PE3 // 2xCamera switcher | PC5 | PD11 // 2xCamera switcher | PD11 // Cam1/Cam2 switch control | PB11 | PC2 // 2xCamera switcher
USE_LED_STRIP | x | x |  | x | x | x | x | x | x | x | x | x | x | x
WS2811_PIN | PA8 | PA8 |  | PA8 | PA8 | PD12 | PA8 | PD12 | PA15 | PA8 | PA8 | PA8 | PD12 | PA8
DEFAULT_FEATURES | (FEATURE_OSD | FEATURE_TELEMETRY | FEATURE_CURRENT_METER | FEATURE_VBAT | FEATURE_TX_PROF_SEL | FEATURE_BLACKBOX) | (FEATURE_OSD | FEATURE_TELEMETRY | FEATURE_CURRENT_METER | FEATURE_VBAT | FEATURE_TX_PROF_SEL) | (FEATURE_OSD | FEATURE_TELEMETRY | FEATURE_CURRENT_METER | FEATURE_VBAT | FEATURE_TX_PROF_SEL | FEATURE_BLACKBOX) | (FEATURE_OSD | FEATURE_TELEMETRY | FEATURE_CURRENT_METER | FEATURE_VBAT | FEATURE_TX_PROF_SEL | FEATURE_BLACKBOX) | (FEATURE_OSD | FEATURE_TELEMETRY | FEATURE_CURRENT_METER | FEATURE_VBAT | FEATURE_TX_PROF_SEL | FEATURE_BLACKBOX) | (FEATURE_OSD | FEATURE_TELEMETRY | FEATURE_CURRENT_METER | FEATURE_VBAT | FEATURE_TX_PROF_SEL | FEATURE_BLACKBOX) | (FEATURE_OSD | FEATURE_TELEMETRY | FEATURE_CURRENT_METER | FEATURE_VBAT | FEATURE_TX_PROF_SEL) | (FEATURE_OSD | FEATURE_TELEMETRY | FEATURE_CURRENT_METER | FEATURE_VBAT | FEATURE_TX_PROF_SEL | FEATURE_BLACKBOX) | (FEATURE_OSD | FEATURE_TELEMETRY | FEATURE_CURRENT_METER | FEATURE_VBAT | FEATURE_TX_PROF_SEL | FEATURE_BLACKBOX | FEATURE_GPS) | (FEATURE_OSD | FEATURE_TELEMETRY | FEATURE_CURRENT_METER | FEATURE_VBAT | FEATURE_TX_PROF_SEL) | (FEATURE_OSD | FEATURE_TELEMETRY | FEATURE_CURRENT_METER | FEATURE_VBAT | FEATURE_TX_PROF_SEL | FEATURE_BLACKBOX) | (FEATURE_OSD | FEATURE_TELEMETRY | FEATURE_CURRENT_METER | FEATURE_VBAT | FEATURE_TX_PROF_SEL | FEATURE_BLACKBOX) | (FEATURE_OSD | FEATURE_TELEMETRY | FEATURE_CURRENT_METER | FEATURE_VBAT | FEATURE_TX_PROF_SEL | FEATURE_BLACKBOX) | (FEATURE_OSD | FEATURE_TELEMETRY | FEATURE_CURRENT_METER | FEATURE_VBAT | FEATURE_TX_PROF_SEL | FEATURE_BLACKBOX)
CURRENT_METER_SCALE | 250 | 100 | 250 | 212 | 100 | 100 | 250 | 250 | 3660 // 36.6 | 250 | 250 | 250 | 250 | 290
USE_SERIAL_4WAY_BLHELI_INTERFACE | x | x | x | x | x | x | x | x | x | x | x | x | x | x
TARGET_IO_PORTA | 0xffff | 0xffff | 0xffff | 0xffff | 0xffff | 0xffff | 0xffff | 0xffff | 0xffff | 0xffff | 0xffff | 0xffff | 0xffff | 0xffff
TARGET_IO_PORTB | 0xffff | 0xffff | 0xffff | 0xffff | 0xffff | 0xffff | 0xffff | 0xffff | 0xffff | 0xffff | 0xffff | 0xffff | 0xffff | 0xffff
TARGET_IO_PORTC | 0xffff | 0xffff | 0xffff | 0xffff | 0xffff | 0xffff | 0xffff | 0xffff | 0xffff | 0xffff | 0xffff | 0xffff | 0xffff | 0xffff
TARGET_IO_PORTD | 0xffff | 0xffff | 0xffff | 0xffff | 0xffff | 0xffff | 0xffff | 0xffff | 0xffff | 0xffff | 0xffff | 0xffff | 0xffff | 0xffff
TARGET_IO_PORTE | 0xffff | 0xffff | 0xffff | 0xffff | 0xffff | 0xffff | 0xffff | 0xffff | 0xffff | 0xffff | 0xffff | 0xffff | 0xffff | 0xffff
MAX_PWM_OUTPUT_PORTS | 15 | 8 | 12 | 12 | 4 | 4 | 8 | 8 | 14 | 8 | 15 | 8 | 8 | 10
USE_DSHOT | x | x | x | x | x | x | x | x | x | x | x | x | x | x
USE_ESC_SENSOR | x | x | x | x | x | x | x | x | x | x | x | x | x | x
M25P16_SPI_BUS |  | BUS_SPI3 |  |  | BUS_SPI3 | BUS_SPI3 | BUS_SPI3 | BUS_SPI1 |  | BUS_SPI3 |  |  |  | BUS_SPI3
M25P16_CS_PIN |  | SPI3_NSS_PIN |  |  | SPI3_NSS_PIN | SPI3_NSS_PIN | SPI3_NSS_PIN | PA4 |  | SPI3_NSS_PIN |  |  |  | PA15
USE_FLASH_M25P16 |  | x |  |  | x | x | x | x |  | x |  |  |  | x
USE_IMU_ICM42605 |  |  | x | x |  |  | x | x | x | x | x
IMU_ICM42605_ALIGN |  |  | CW0_DEG | CW0_DEG |  |  | CW180_DEG | CW270_DEG | CW90_DEG | CW270_DEG | CW90_DEG_FLIP
ICM42605_SPI_BUS |  |  | BUS_SPI1 | BUS_SPI1 |  |  | BUS_SPI1 | BUS_SPI4 | BUS_SPI3 | BUS_SPI4 | BUS_SPI4
ICM42605_CS_PIN |  |  | PC15 | PC15 |  |  | PA4 | PE4 | PE12 | PE11 | PC13
USE_BARO_ALL |  |  | x | x |  |  | x
SERIALRX_UART |  |  | SERIAL_PORT_USART6 | SERIAL_PORT_USART6 | SERIAL_PORT_USART4 | SERIAL_PORT_USART2 |  | SERIAL_PORT_USART1 | SERIAL_PORT_USART6 |  | SERIAL_PORT_USART6 | SERIAL_PORT_USART6 | SERIAL_PORT_USART1 | SERIAL_PORT_USART1
USE_SDCARD |  |  | x | x |  |  |  | x | x |  | x | x
USE_SDCARD_SPI |  |  | x |  |  |  |  | x
SDCARD_SPI_BUS |  |  | BUS_SPI3 |  |  |  |  | BUS_SPI1
SDCARD_CS_PIN |  |  | PA15 |  |  |  |  | PA4
ENABLE_BLACKBOX_LOGGING_ON_SDCARD_BY_DEFAULT |  |  | x | x |  |  |  | x | x |  | x | x
VBAT_SCALE_DEFAULT |  |  | 2100 | 1135 |  |  |  |  | 1818 // 18.18
USE_SDCARD_SDIO |  |  |  | x |  |  |  |  | x |  | x | x
SDCARD_SDIO_DEVICE |  |  |  | SDIODEV_1 |  |  |  |  | SDIODEV_2 |  | SDIODEV_1 | SDIODEV_1
SDCARD_SDIO_4BIT |  |  |  | x |  |  |  |  | x |  | x | x
BEEPER_PIN |  |  |  |  | PD2 | PD15
SPI1_NSS_PIN |  |  |  |  | PA4 | PA4
IMU_BMI270_ALIGN |  |  |  |  | CW0_DEG |  | CW180_DEG | CW0_DEG |  | CW180_DEG |  | CW270_DEG | CW0_DEG
BMI270_CS_PIN |  |  |  |  | SPI1_NSS_PIN |  | PA4 | PE4 |  | PA4 |  | PC15 | PE4
BMI270_SPI_BUS |  |  |  |  | BUS_SPI1 |  | BUS_SPI1 | BUS_SPI4 |  | BUS_SPI1 |  | BUS_SPI1 | BUS_SPI4
SPI2_NSS_PIN |  |  |  |  | PB12 | PB12
SPI4_NSS_PIN |  |  |  |  | PE4 | PE4
USE_UART5 |  |  |  |  |  |  | x |  | x | x |  |  |  | x
UART5_TX_PIN |  |  |  |  |  |  | PC12 |  | PB13 | PC12 |  |  |  | PB6
UART5_RX_PIN |  |  |  |  |  |  | PD2 |  | PD2 | PD2 |  |  |  | PB5
SDCARD_DETECT_INVERTED |  |  |  |  |  |  |  | x
SDCARD_DETECT_PIN |  |  |  |  |  |  |  | PA3
PINIO1_FLAGS |  |  |  |  |  |  |  | PINIO_FLAGS_INVERTED |  |  |  |  | PINIO_FLAGS_INVERTED
PINIO2_FLAGS |  |  |  |  |  |  |  | PINIO_FLAGS_INVERTED |  |  |  |  | PINIO_FLAGS_INVERTED
USE_HARDWARE_PREBOOT_SETUP |  |  |  |  |  |  |  |  | x
USE_IMU_BMI088 |  |  |  |  |  |  |  |  | x
IMU_BMI088_ALIGN |  |  |  |  |  |  |  |  | CW0_DEG
BMI088_SPI_BUS |  |  |  |  |  |  |  |  | BUS_SPI1
BMI088_GYRO_CS_PIN |  |  |  |  |  |  |  |  | PC9
BMI088_GYRO_EXTI_PIN |  |  |  |  |  |  |  |  | PD10
BMI088_ACC_CS_PIN |  |  |  |  |  |  |  |  | PC8
BMI088_ACC_EXTI_PIN |  |  |  |  |  |  |  |  | PD11
ICM42605_EXTI_PIN |  |  |  |  |  |  |  |  | PE15
SDCARD_SDIO_NORMAL_SPEED |  |  |  |  |  |  |  |  | x
SDCARD_SDIO2_CMD_ALT |  |  |  |  |  |  |  |  | x
USE_I2C_DEVICE_4 |  |  |  |  |  |  |  |  | x
I2C4_SCL |  |  |  |  |  |  |  |  | PD12
I2C4_SDA |  |  |  |  |  |  |  |  | PD13
PINIO3_PIN |  |  |  |  |  |  |  |  | PD4 // User1 |  |  | PC3 // BT Mode |  | PD11
PINIO4_PIN |  |  |  |  |  |  |  |  | PE4 // User2
VBAT_SCALE_DEFAULT2 |  |  |  |  |  |  |  |  | 1100 // 11.0
USE_IMU_MPU6500 |  |  |  |  |  |  |  |  |  |  | x
IMU_MPU6500_ALIGN |  |  |  |  |  |  |  |  |  |  | CW0_DEG_FLIP
MPU6500_SPI_BUS |  |  |  |  |  |  |  |  |  |  | BUS_SPI4
MPU6500_CS_PIN |  |  |  |  |  |  |  |  |  |  | PE11
USE_MAG_RM3100 |  |  |  |  |  |  |  |  |  |  | x
RM3100_CS_PIN |  |  |  |  |  |  |  |  |  |  | PE2 //CS2 pad
RM3100_SPI_BUS |  |  |  |  |  |  |  |  |  |  | BUS_SPI3
USE_SOFTSERIAL1 |  |  |  |  |  |  |  |  |  |  | x
SOFTSERIAL_1_TX_PIN |  |  |  |  |  |  |  |  |  |  | PC6 //TX6 pad
SOFTSERIAL_1_RX_PIN |  |  |  |  |  |  |  |  |  |  | PC6 //TX6 pad
IMU1_ALIGN |  |  |  |  |  |  |  |  |  |  |  |  |  | CW0_DEG
IMU1_SPI_BUS |  |  |  |  |  |  |  |  |  |  |  |  |  | BUS_SPI4
IMU1_CS_PIN |  |  |  |  |  |  |  |  |  |  |  |  |  | PE11
IMU2_ALIGN |  |  |  |  |  |  |  |  |  |  |  |  |  | CW90_DEG
IMU2_SPI_BUS |  |  |  |  |  |  |  |  |  |  |  |  |  | BUS_SPI1
IMU2_CS_PIN |  |  |  |  |  |  |  |  |  |  |  |  |  | PC15
