MomoRC-tech/MoGliFC-Flight-Controller/development/10_KiCAD FC/KiCad component downloads/AT2401C/AT2401C_QFN-16_L3.0-W3.0-H0.9-P0.50.step

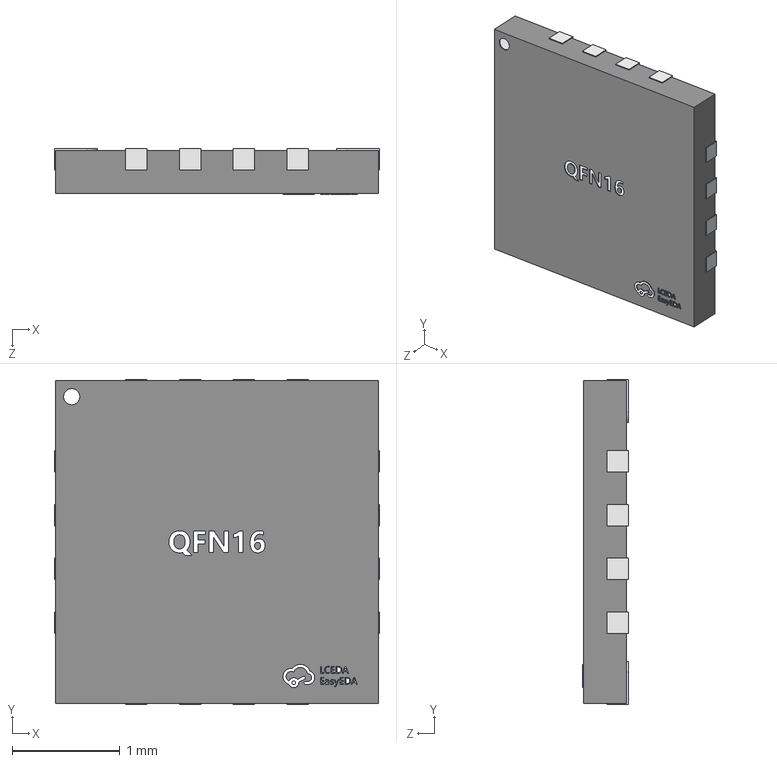
[picture p13: CAD file, 2024-08-09]
development/10_KiCAD FC/KiCad component downloads/AT2401C/AT2401C_QFN-16_L3.0-W3.0-H0.9-P0.50.step
3.02 x 3.02 x 0.43 mm
