MomoRC-tech/MoGliFC-Flight-Controller/development/10_KiCAD FC/KiCad component downloads/BMI270/BMI270.step

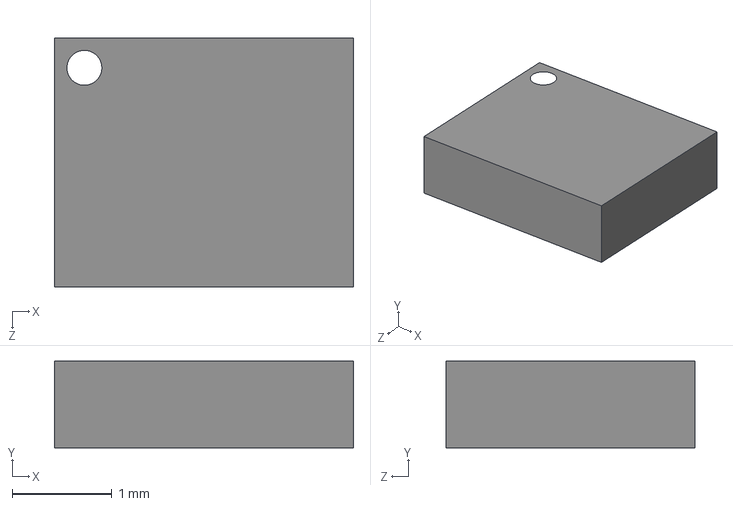
[picture p14: CAD file, 2024-07-19]
development/10_KiCAD FC/KiCad component downloads/BMI270/BMI270.step
3.00 x 0.87 x 2.50 mm
