MomoRC-tech/MoGliFC-Flight-Controller/development/10_KiCAD FC/KiCad component downloads/CSTCE8M00G52-R0/CSTCE8M00G52-R0.step

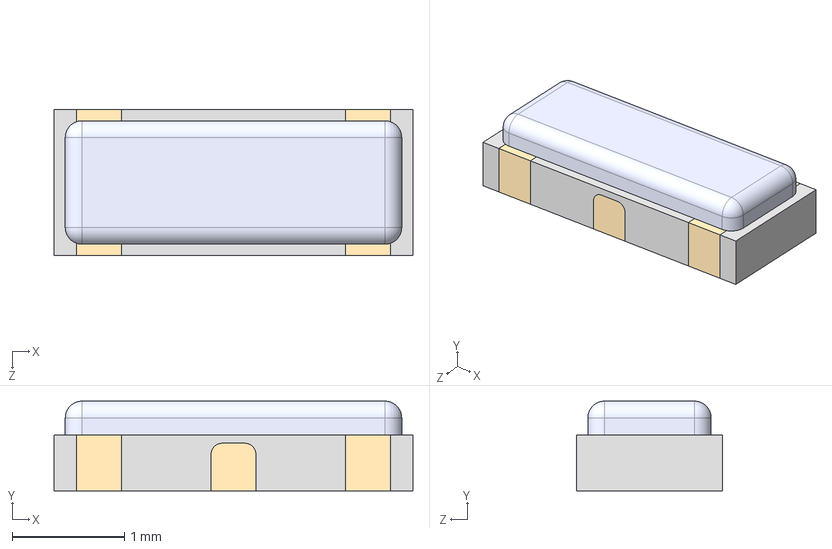
[picture p15: CAD file, 2024-07-19]
development/10_KiCAD FC/KiCad component downloads/CSTCE8M00G52-R0/CSTCE8M00G52-R0.step
3.20 x 0.8 x 1.30 mm
