MomoRC-tech/MoGliFC-Flight-Controller/development/10_KiCAD FC/KiCad component downloads/DPS310/DPS310.step

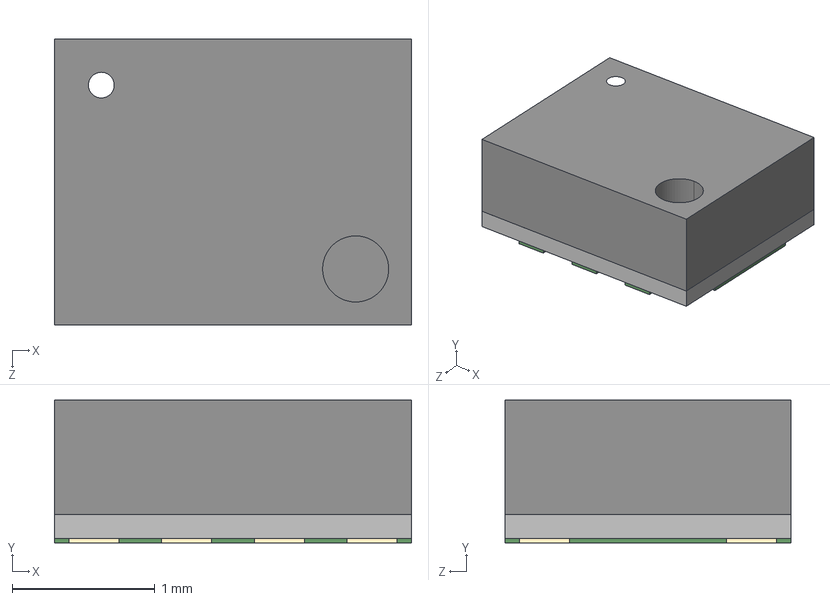
[picture p16: CAD file, 2024-07-19]
development/10_KiCAD FC/KiCad component downloads/DPS310/DPS310.step
2.50 x 1.00 x 2.00 mm
