MomoRC-tech/MoGliFC-Flight-Controller/development/10_KiCAD FC/KiCad component downloads/elrs filter 2450FM0/FILTER-SMD_0402-4P-L1.0-W0.5-L.step

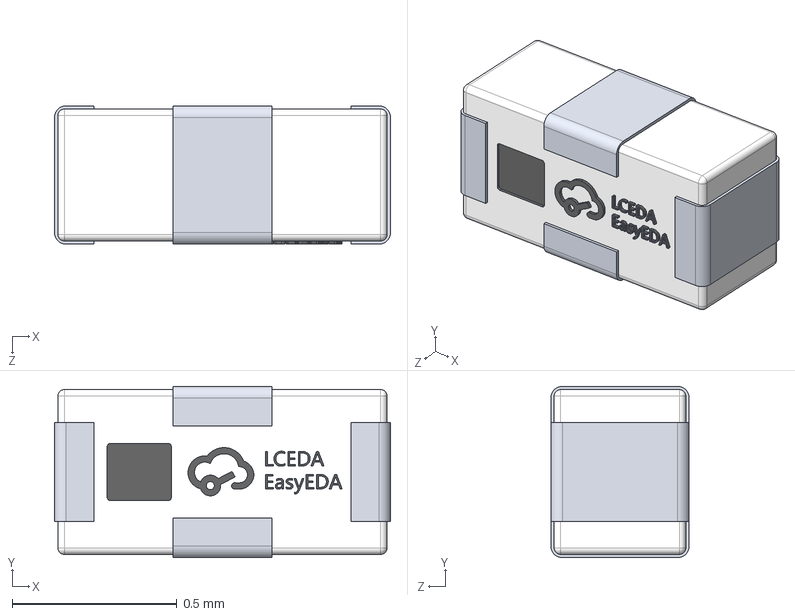
[picture p17: CAD file, 2024-08-09]
development/10_KiCAD FC/KiCad component downloads/elrs filter 2450FM0/FILTER-SMD_0402-4P-L1.0-W0.5-L.step
1.02 x 0.52 x 0.42 mm
