MomoRC-tech/MoGliFC-Flight-Controller/development/10_KiCAD FC/KiCad component downloads/LIB_EVQ-P7J01P/EVQ-P7J01P/3D/EVQ-P7J01P.stp

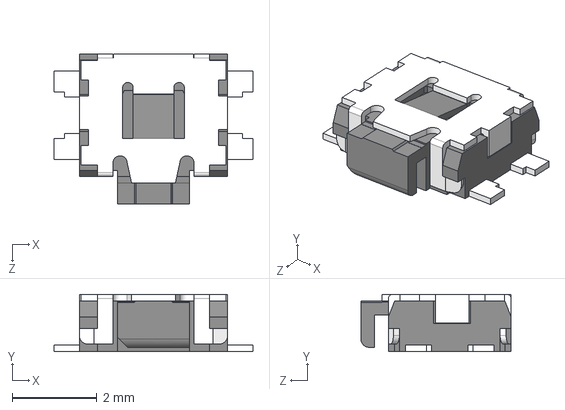
[picture p18: CAD file, 2024-07-19]
development/10_KiCAD FC/KiCad component downloads/LIB_EVQ-P7J01P/EVQ-P7J01P/3D/EVQ-P7J01P.stp
4.70 x 1.35 x 3.55 mm
