MomoRC-tech/MoGliFC-Flight-Controller/development/10_KiCAD FC/KiCad component downloads/LIB_TJA1057GTK_3Z/TJA1057GTK_3Z/3D/TJA1057GTK_3Z.stp

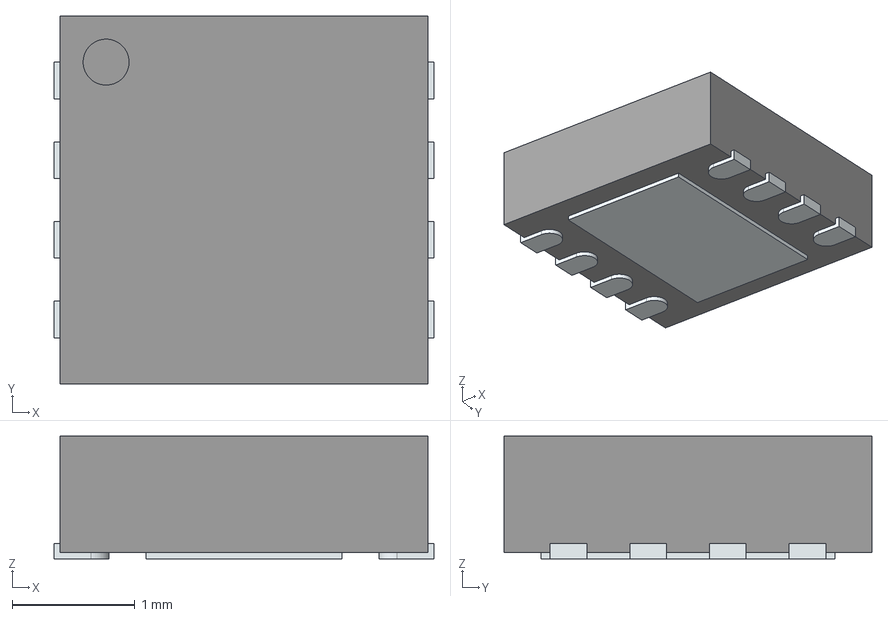
[picture p19: CAD file, 2024-07-19]
development/10_KiCAD FC/KiCad component downloads/LIB_TJA1057GTK_3Z/TJA1057GTK_3Z/3D/TJA1057GTK_3Z.stp
3.10 x 3.00 x 1.00 mm
ThermalPin
PinsArrayLR
