MomoRC-tech/MoGliFC-Flight-Controller/development/10_KiCAD FC/KiCad component downloads/LP5912-3.3DRVR/LP5912-3.3DRVR.step

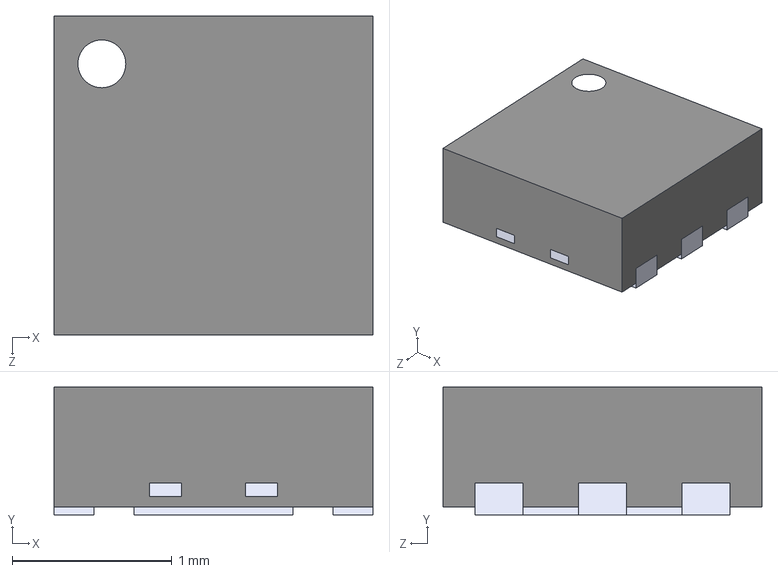
[picture p20: CAD file, 2024-07-19]
development/10_KiCAD FC/KiCad component downloads/LP5912-3.3DRVR/LP5912-3.3DRVR.step
2.00 x 0.8 x 2.00 mm
