MomoRC-tech/MoGliFC-Flight-Controller/development/10_KiCAD FC/KiCad component downloads/MAX7456EUI_/MAX7456EUI_.step

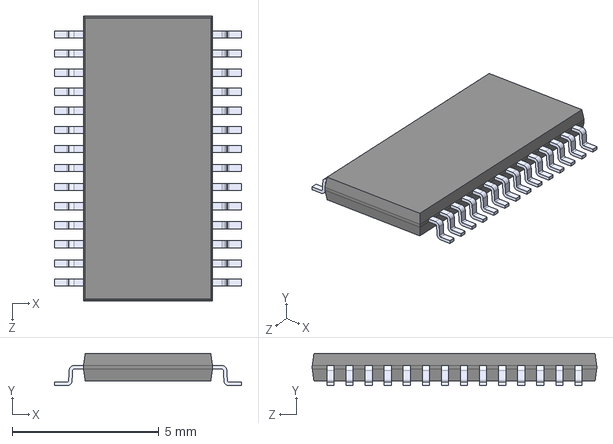
[picture p21: CAD file, 2024-07-19]
development/10_KiCAD FC/KiCad component downloads/MAX7456EUI_/MAX7456EUI_.step
6.38 x 1.10 x 9.70 mm
