MomoRC-tech/MoGliFC-Flight-Controller/development/10_KiCAD FC/KiCad component downloads/schottky diodes B340A-13-F/SMA_L4.4-W2.6-LS5.0-RD.step

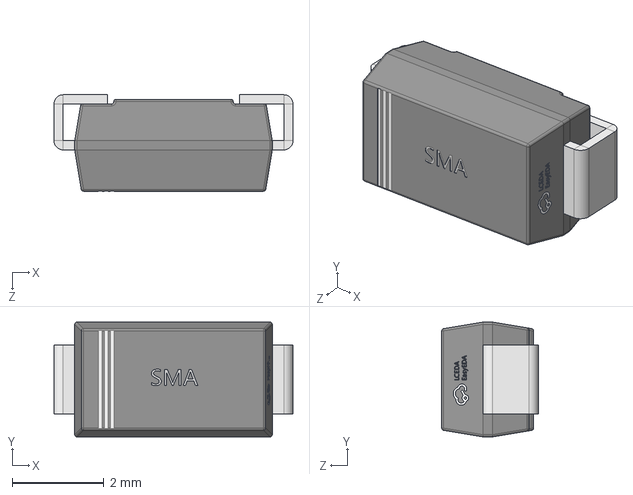
[picture p22: CAD file, 2024-08-08]
development/10_KiCAD FC/KiCad component downloads/schottky diodes B340A-13-F/SMA_L4.4-W2.6-LS5.0-RD.step
5.20 x 2.50 x 2.10 mm
