MomoRC-tech/MoGliFC-Flight-Controller/development/10_KiCAD FC/KiCad component downloads/ul_BMI088/BMI088--3DModel-STEP-56544.STEP

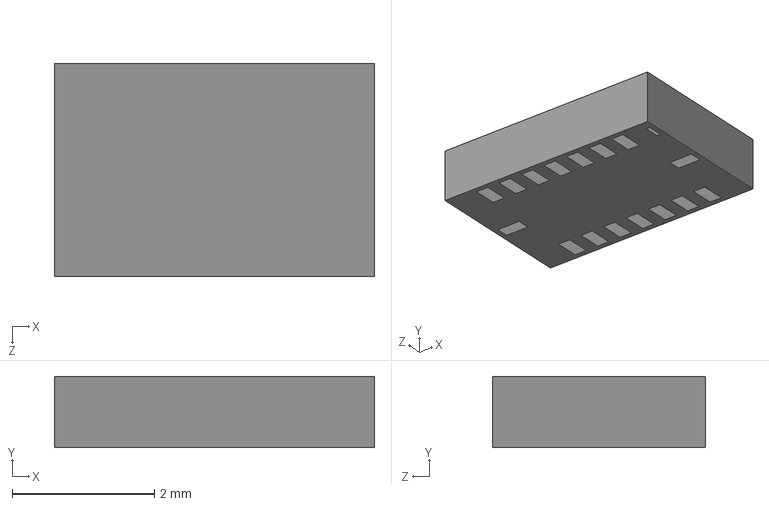
[picture p23: CAD file, 2024-07-19]
development/10_KiCAD FC/KiCad component downloads/ul_BMI088/BMI088--3DModel-STEP-56544.STEP
4.50 x 1.00 x 3.00 mm
