MomoRC-tech/MoGliFC-Flight-Controller/development/10_KiCAD FC/KiCad component downloads/ul_ESP32-PICO-D4/ESP32-PICO-D4_EXP.step

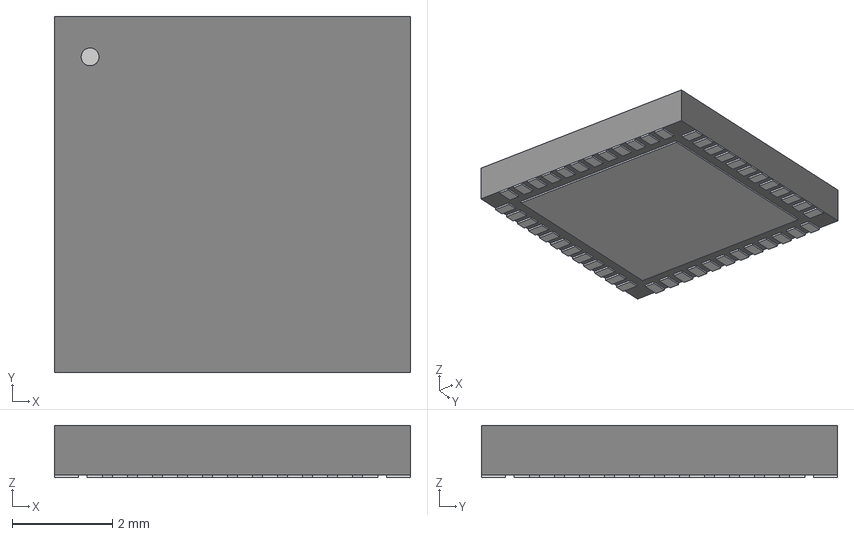
[picture p24: CAD file, 2024-08-09]
development/10_KiCAD FC/KiCad component downloads/ul_ESP32-PICO-D4/ESP32-PICO-D4_EXP.step
7.11 x 7.11 x 1.04 mm
