MomoRC-tech/MoGliFC-Flight-Controller/development/10_KiCAD FC/KiCad component downloads/ul_HMC5883L/HMC5883L--3DModel-STEP-269445.STEP

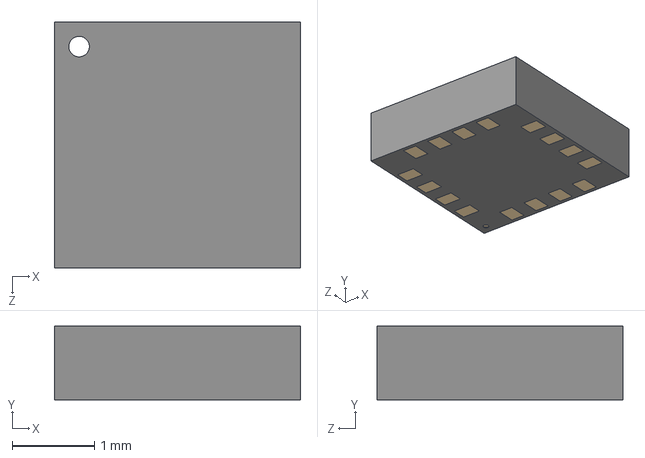
[picture p25: CAD file, 2024-07-19]
development/10_KiCAD FC/KiCad component downloads/ul_HMC5883L/HMC5883L--3DModel-STEP-269445.STEP
3.00 x 0.9 x 3.00 mm
