MomoRC-tech/MoGliFC-Flight-Controller/development/10_KiCAD FC/KiCad component downloads/ul_STM32H753VIH6/TFBGA100.step

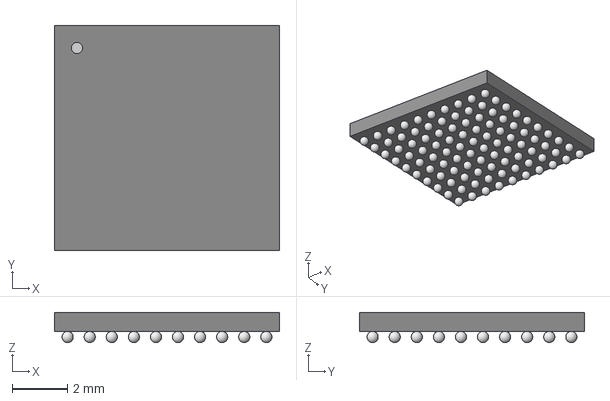
[picture p26: CAD file, 2024-08-04]
development/10_KiCAD FC/KiCad component downloads/ul_STM32H753VIH6/TFBGA100.step
8.15 x 8.15 x 1.10 mm
