MomoRC-tech/MoGliFC-Flight-Controller/development/10_KiCAD FC/KiCad component downloads/ul_TPSM33625RDNR/RDN0011A.stp

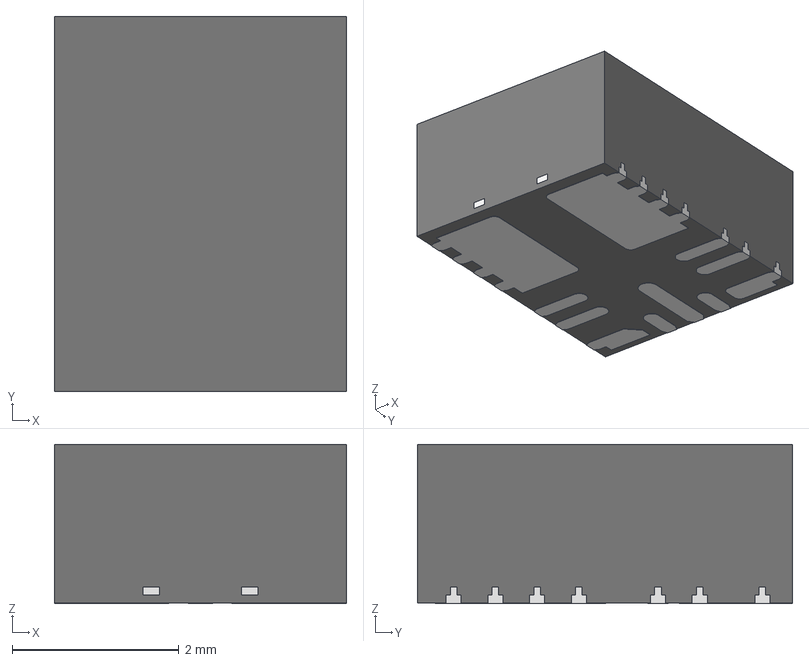
[picture p27: CAD file, 2024-08-02]
development/10_KiCAD FC/KiCad component downloads/ul_TPSM33625RDNR/RDN0011A.stp
3.50 x 4.50 x 1.91 mm
MOLD_CPOMPOUND_AF0
SOLID1-489_AF0
SOLID1-490_AF0
SOLID1-491_AF0
SOLID1-492_AF0
SOLID1-493_AF0
SOLID1-494_AF0
SOLID1-495_AF0
SOLID1-496_AF0
SOLID1-497_AF0
SOLID1-498_AF0
