MomoRC-tech/MoGliFC-Flight-Controller/development/10_KiCAD FC/KiCad component downloads/W25N01GVZEIG TR.STEP

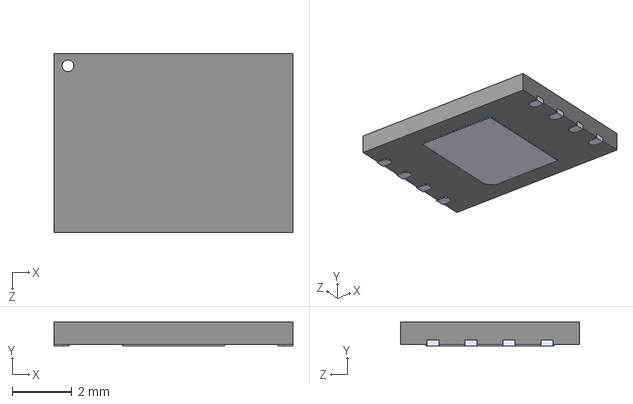
[picture p28: CAD file, 2024-07-19]
development/10_KiCAD FC/KiCad component downloads/W25N01GVZEIG TR.STEP
8.00 x 0.8 x 6.00 mm
