MomoRC-tech/MoGliFC-Flight-Controller/development/10_KiCAD FC/KiCad component downloads/XRCGB27M120F3M00R0/XRCGB27M120F3M00R0.step

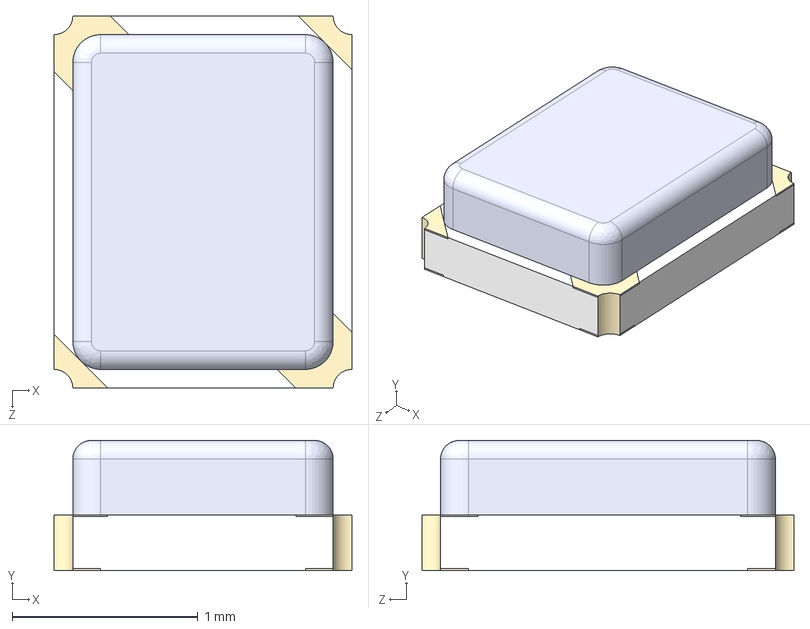
[picture p29: CAD file, 2024-07-19]
development/10_KiCAD FC/KiCad component downloads/XRCGB27M120F3M00R0/XRCGB27M120F3M00R0.step
1.60 x 0.7 x 2.00 mm
