MomoRC-tech/MoGliFC-Flight-Controller/development/10_KiCAD FC/MoGliFC/3d models/IPEX U.FL-R-SMT-IPEX U.step

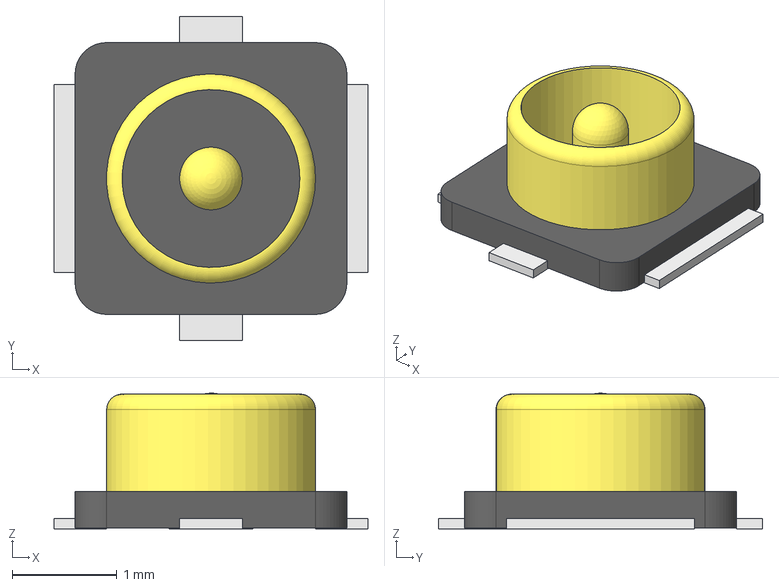
[picture p30: CAD file, 2024-08-09]
development/10_KiCAD FC/MoGliFC/3d models/IPEX U.FL-R-SMT-IPEX U.step
3.00 x 3.10 x 1.30 mm
