MomoRC-tech/MoGliFC-Flight-Controller/development/10_KiCAD FC/MoGliFC/3d models/SX1280IMLTRT_QFN24_4X4_SEM.step

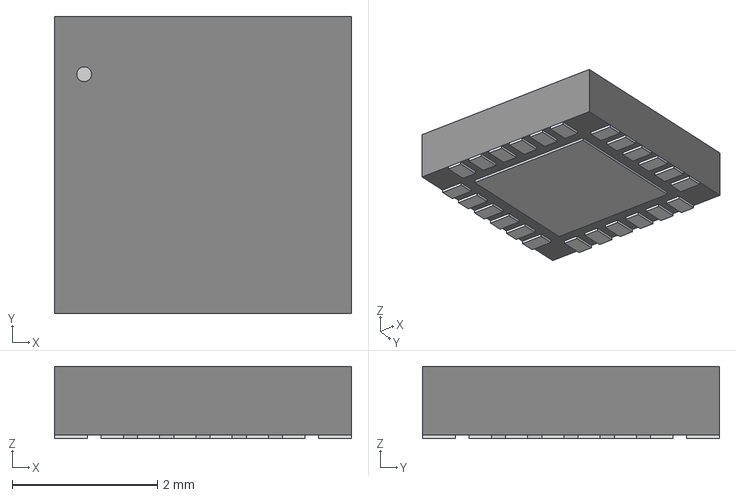
[picture p31: CAD file, 2024-08-09]
development/10_KiCAD FC/MoGliFC/3d models/SX1280IMLTRT_QFN24_4X4_SEM.step
4.09 x 4.09 x 0.993 mm
