MomoRC-tech/MoGliFC-Flight-Controller/(list of files, cad)

Other CAD files:
development/10_KiCAD FC/KiCad component downloads/LIB_EVQ-P7J01P/EVQ-P7J01P/Allegro/evqp7j01p.psm
development/10_KiCAD FC/KiCad component downloads/LIB_EVQ-P7J01P/EVQ-P7J01P/DEHDL/evq_p7j01p/chips/chips.prt
development/10_KiCAD FC/KiCad component downloads/LIB_TJA1057GTK_3Z/TJA1057GTK_3Z/Allegro/son65p300x300x100-9n-d.psm
development/10_KiCAD FC/KiCad component downloads/LIB_TJA1057GTK_3Z/TJA1057GTK_3Z/DEHDL/tja1057gtk_3z/chips/chips.prt
