MomoRC-tech/MoGliFC-Flight-Controller/documentation/221022_MomoRC_MOMORX_manual_v1.0.pdf

# ELRS 2.4GHz RX MOMORX-1

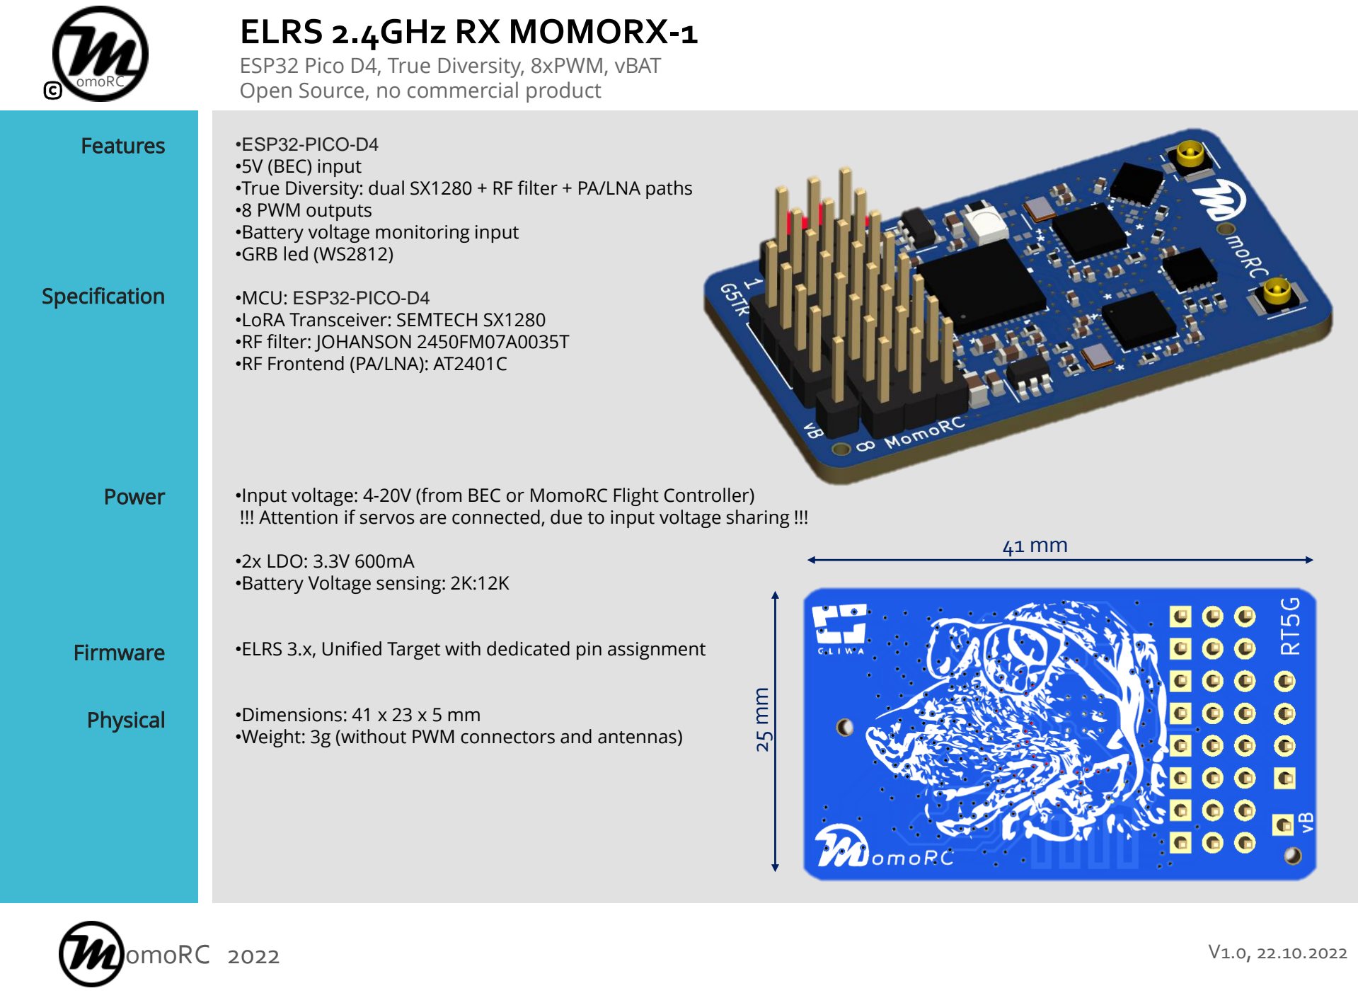
[picture p32: page 1]

ESP32 Pico D4, True Diversity, 8xPWM, vBAT Open Source, no commercial product

•ESP32-PICO-D4
•5V (BEC) input
•True Diversity: dual SX1280 + RF filter + PA/LNA paths •8 PWM outputs
•Battery voltage monitoring input
•GRB led (WS2812)

•MCU: ESP32-PICO-D4
•LoRA Transceiver: SEMTECH SX1280 •RF filter: JOHANSON 2450FM07A0035T •RF Frontend (PA/LNA): AT2401C

•Input voltage: 4-20V (from BEC or MomoRC Flight Controller)
!!! Attention if servos are connected, due to input voltage sharing !!!

•2x LDO: 3.3V 600mA
•Battery Voltage sensing: 2K:12K

•ELRS 3.x, Unified Target with dedicated pin assignment

•Dimensions: 41 x 23 x 5 mm
•Weight: 3g (without PWM connectors and antennas)

Features

Specification

Power

Firmware

Physical

omoRC

omoRC 2022 | V1.0, 22.10.2022 ²⁵ mm

41 mm

Layout

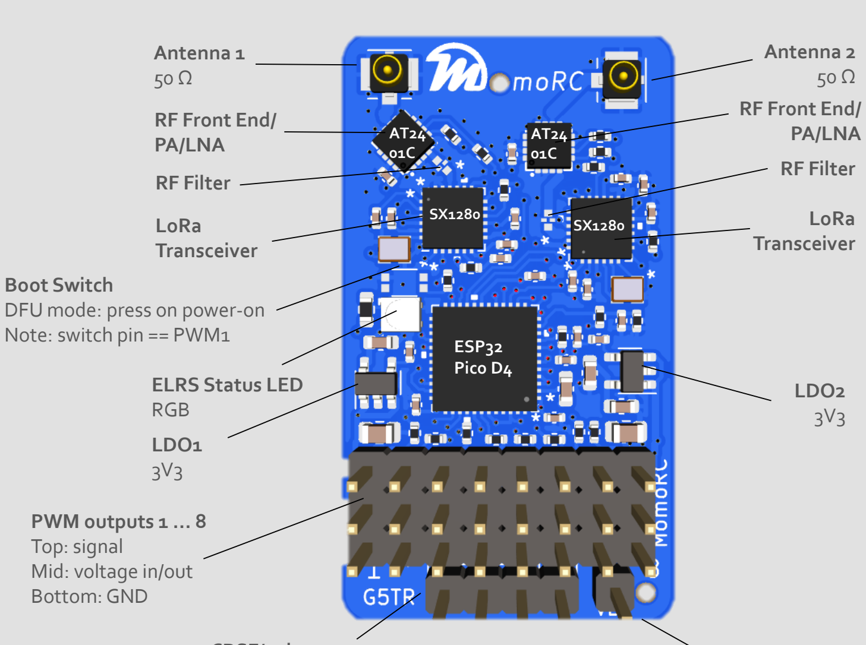
[picture p33: figure]
AT24 01C RF Filter RF Filter; RF Front End/ PA/LNA; LoRa Transceiver; RF Front End/; PA/LNA; LDO1 3V3; LDO2 3V3; Note: switch pin == PWM1; ESP32; Pico D4

Antenna 1
50 Ω

vB pin
voltage sensing pin
max 3.4V, ADC1/CHN7), DC 8~25V (2S~5S), [2K:12K]

PWM outputs 1 … 8
Top: signal
Mid: voltage in/out
Bottom: GND

CRSF/voltage port
GND –VIN –TX – RX
Notes: -VIN is shared with PWM voltage pins -TX == PWM2
- RX == PWM3

omoRC

omoRC 2022 | V1.0, 22.10.2022

Open Source, no commercial product

Antenna 2
50 Ω

ELRS Status LED
RGB

Boot Switch
DFU mode: press on power-on

# FLIGHT CONTROLLER MOMOFC-1

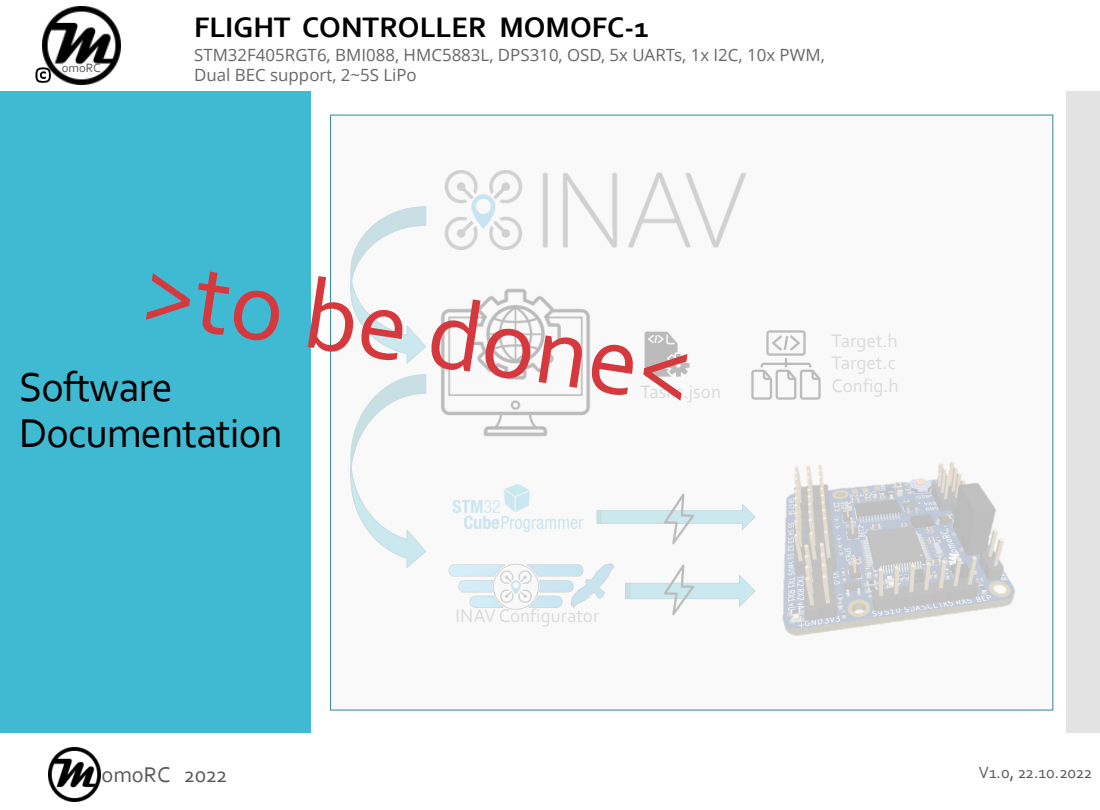
[picture p34: page 3]
Software Documentation; omoRC; INAV Configurator; Tasks.json; Target.h Target.c Config.h

STM32F405RGT6, BMI088, HMC5883L, DPS310, OSD, 5x UARTs, 1x I2C, 10x PWM,
Dual BEC support, 2~5S LiPo

ELRSConfig | Unified Target 10.0.0.1/hardware.html:

Battery Voltage:
ELRS scale <tbd> [2K:12K]
vB: max 3.4V, ADC1/CHN7), DC 8~25V (2S~5S), [2K:12K]

omoRC
Open Source, no commercial product
"serial_rx": | 3,
"serial_tx": | 1,
"radio_miso": | 33,
"radio_mosi": | 32,
"radio_rst": | 26,
"radio_sck": | 25,
"radio_busy": | 36,
"radio_dio1": | 37,
"radio_nss": | 27,

"radio_busy_2": 39,
"radio_dio1_2": 34,
"radio_nss_2": 13,
"power_rxen": | 10,
"power_txen": | 14,
"power_rxen_2": 9,
"power_txen_2": 15,
"power_min": | 0,
"power_high": | 0,
"power_max": | 0,
"power_default": | 0,
"power_control": | 0,
"power_values": [-10,-6,-3,1],

"pwm_outputs": [0,1,3,21,19,5,2,18],

"vbat": | 35,
"vbat_offset": | <12>,
"vbat_scale": | <410>,
"led_rgb": | 22,
"led_rgb_isgrb": | true,
"ledidx_rgb_status": [0],

### "ledidx_rgb_boot": [0]

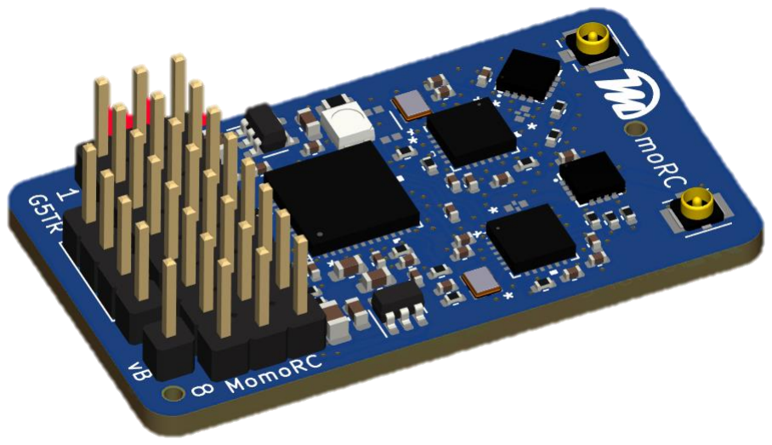
[picture p35: figure]

# Hardware Documentation

omoRC
Open Source, no commercial product

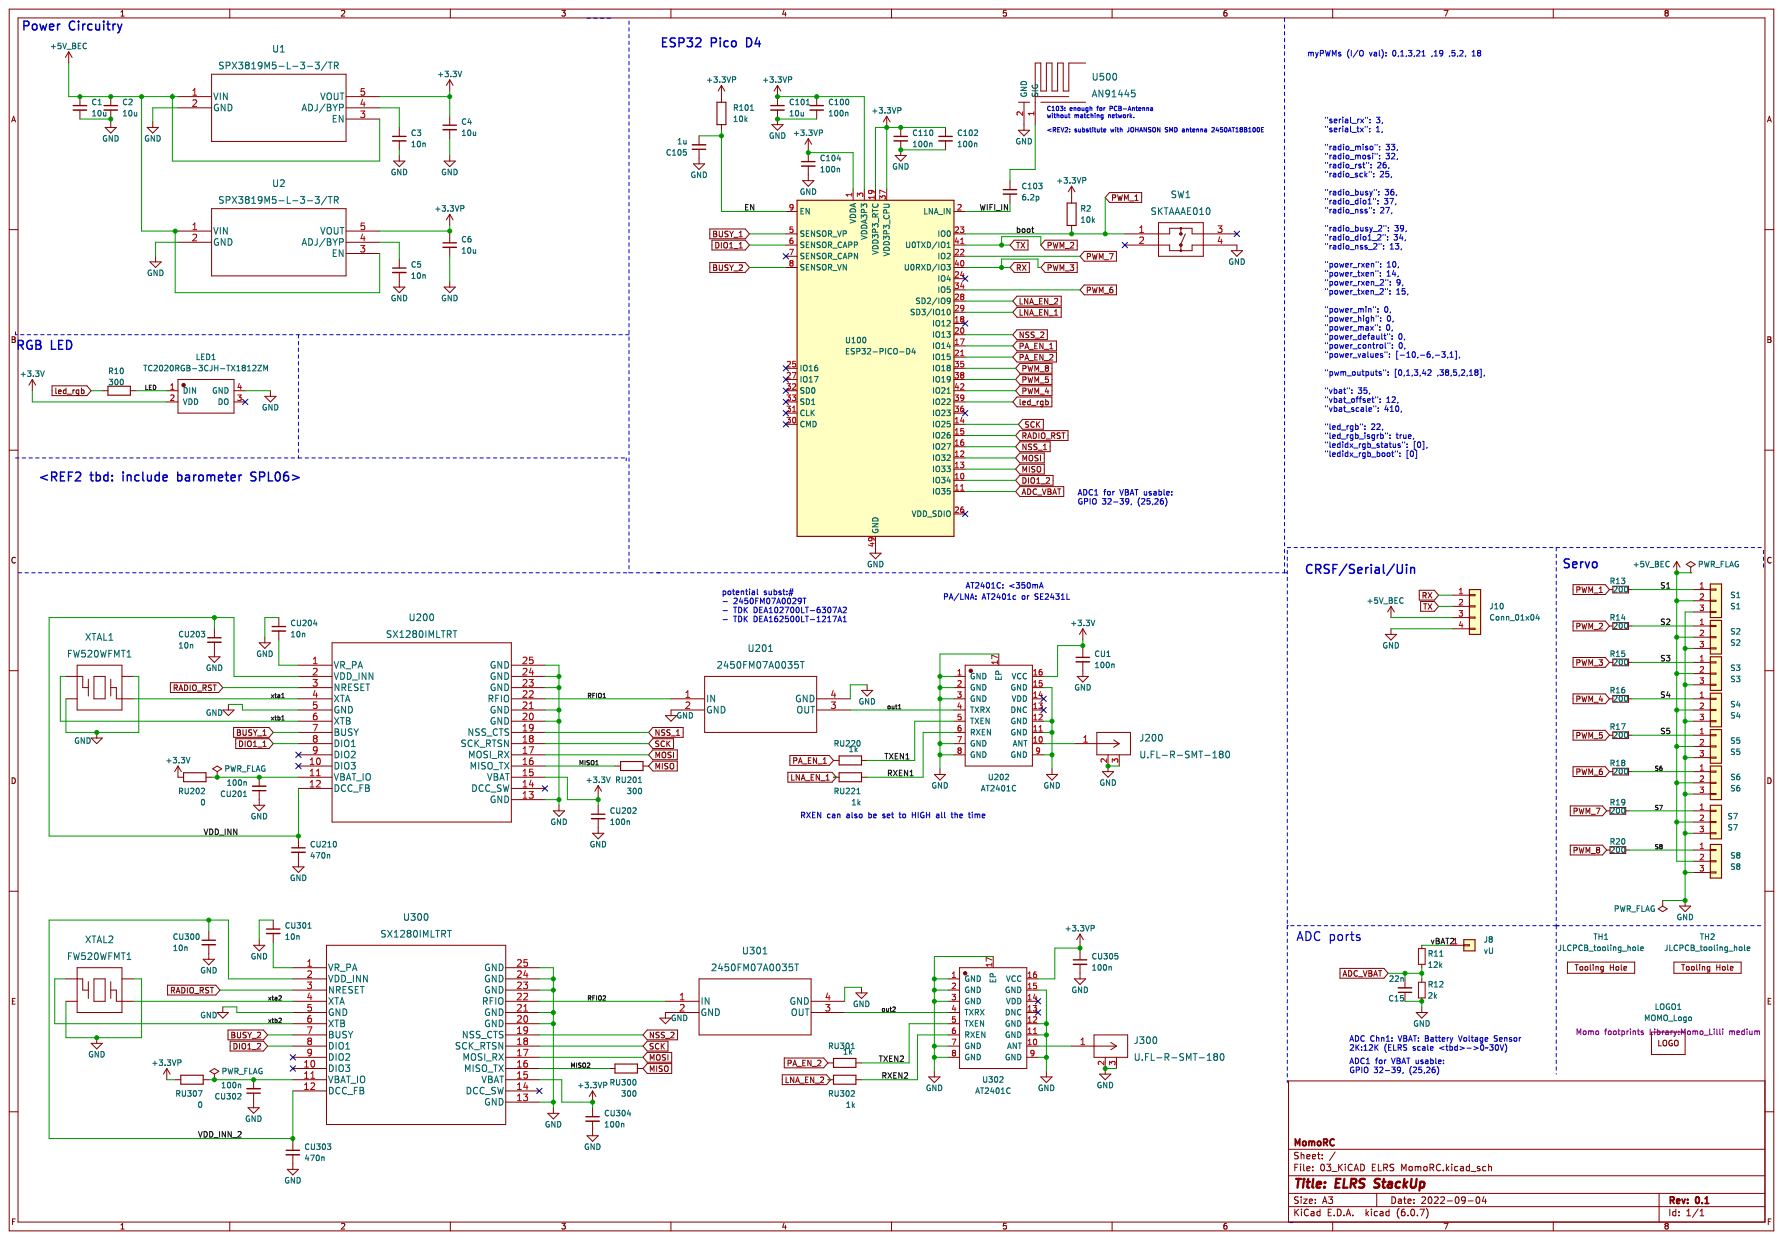
[picture p36: page 6]

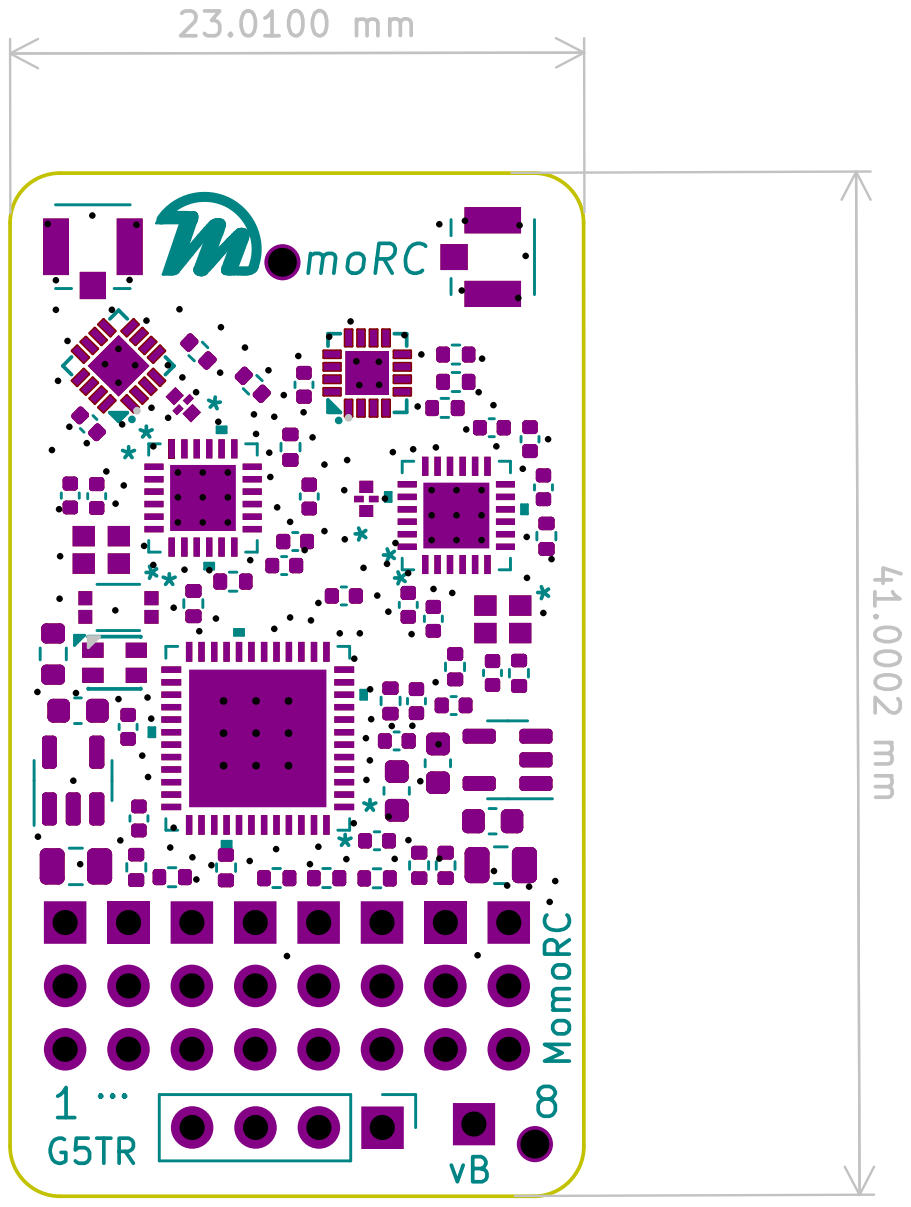
[picture p37: page 7]

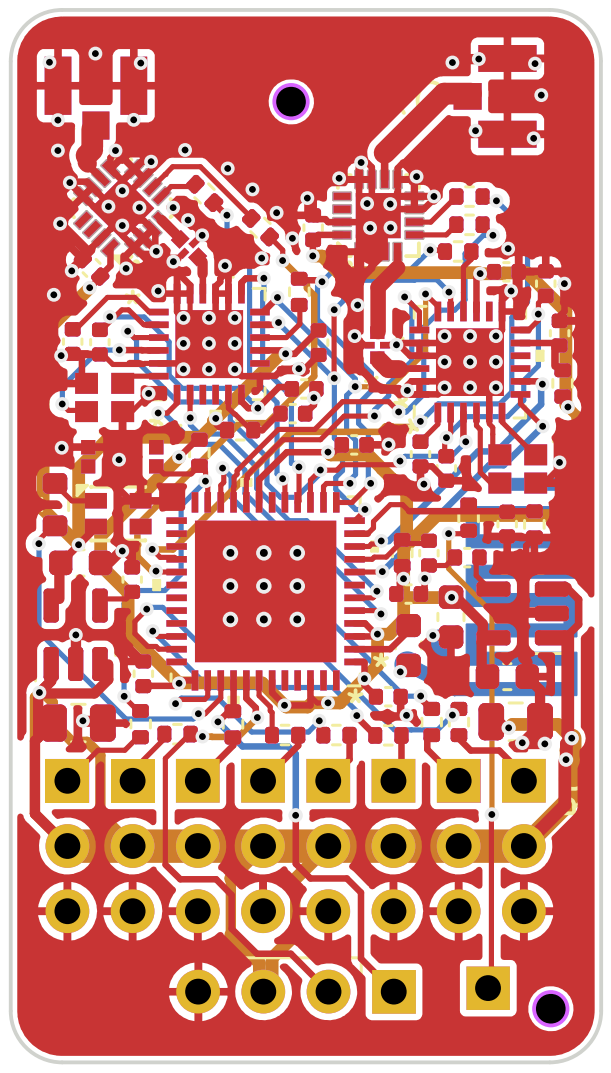
[picture p38: page 8]

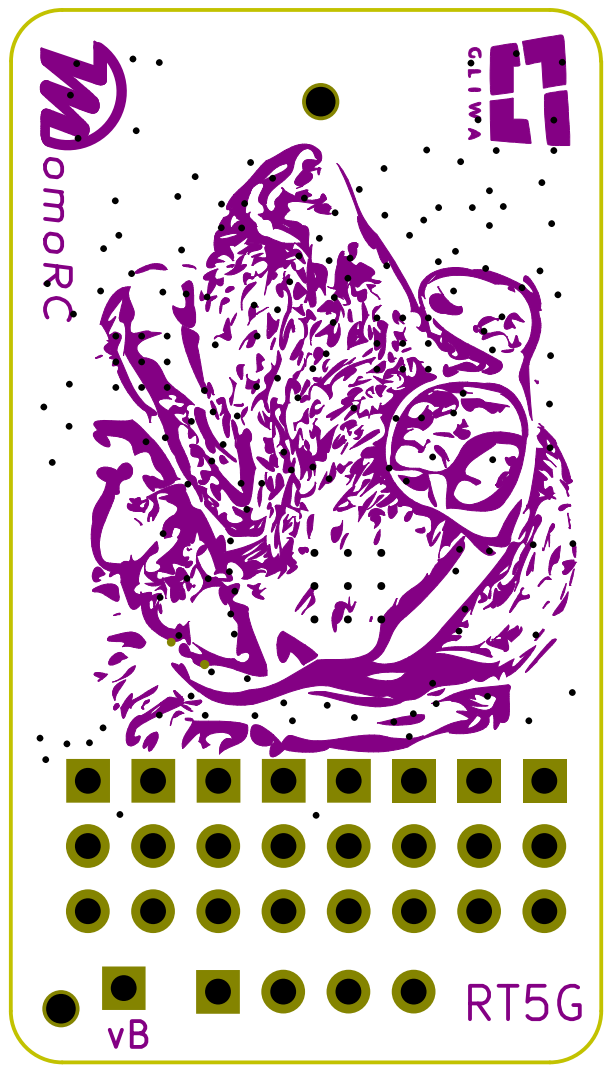
[picture p39: page 9]
