MomoRC-tech/MoGliFC-Flight-Controller/development/01_INAV Betaflight analysis/01_INAV target analysis script/how to script virtual.txt

1. Create: 
- python -m venv myFC
- virtualenv myFC

2. Activate: 
- myFC\Scripts\activate

3. install packages: 
- pip install openpyxl

4. Do something ....

5. deactivate:
- deactivate
