MomoRC-tech/MoGliFC-Flight-Controller/development/10_KiCAD FC/images/debug_SWDJ.PNG

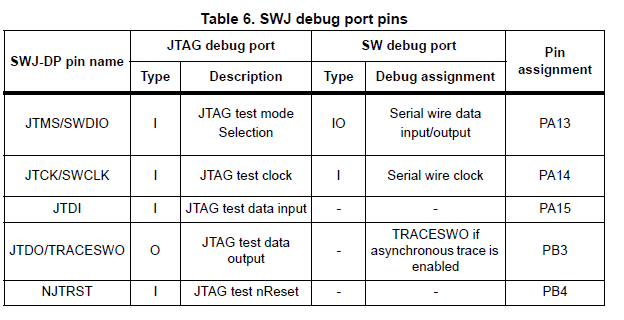
development/10_KiCAD FC/images/debug_SWDJ.PNG
