MomoRC-tech/MoGliFC-Flight-Controller/development/10_KiCAD FC/images/debug_SWDJ_JTAG.PNG

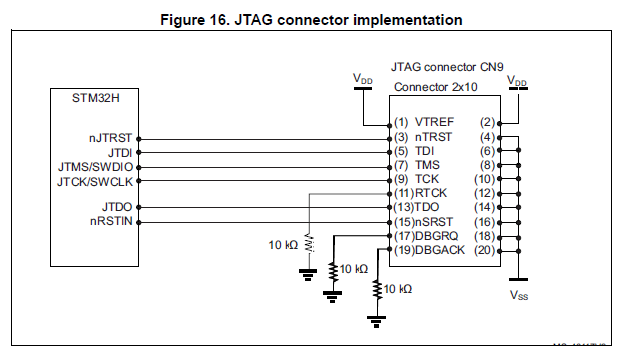
development/10_KiCAD FC/images/debug_SWDJ_JTAG.PNG
