MomoRC-tech/MoGliFC-Flight-Controller/development/01_datasheets/01_from version1/usb micro vertical_Korean-Hroparts-Elec-U-D-M5DS-Y-3_C283543.pdf

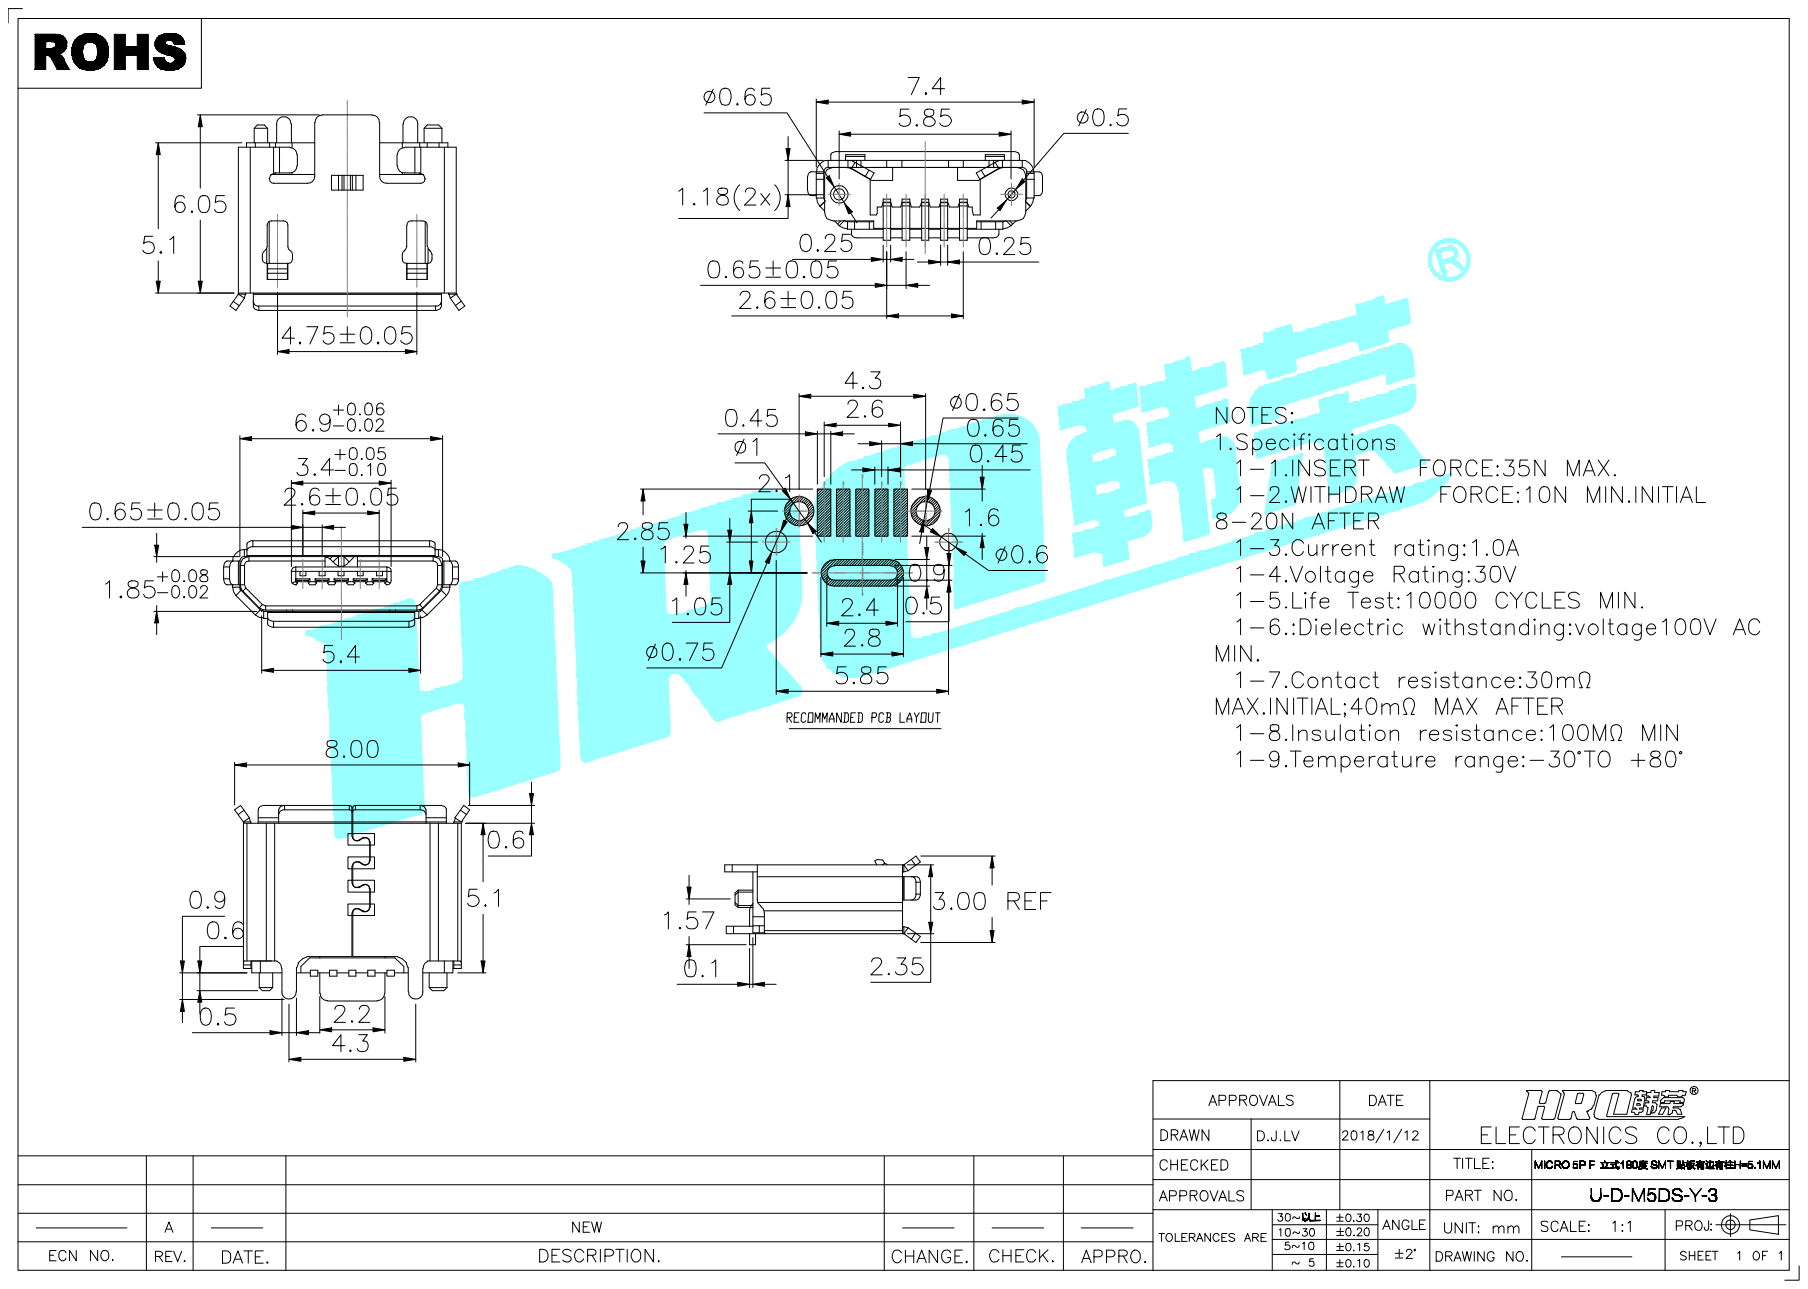
[picture p49: page 1]
