MomoRC-tech/MoGliFC-Flight-Controller/(list of files, drawings)

Other design files:
development/10_KiCAD FC/KiCad component downloads/LIB_TJA1057GTK_3Z/TJA1057GTK_3Z/Altium/SON65P300X300X100-9N-D.PcbLib
development/10_KiCAD FC/KiCad component downloads/LIB_TJA1057GTK_3Z/TJA1057GTK_3Z/Altium/TJA1057GTK_3Z.SchLib
