MomoRC-tech/MoGliFC-Flight-Controller/development/10_KiCAD FC/MoGliFC/02_KiCAD FC MomoRC.kicad_sch

## KiCad design development/10_KiCAD FC/MoGliFC/02_KiCAD FC MomoRC.kicad_sch (2024-07-19)

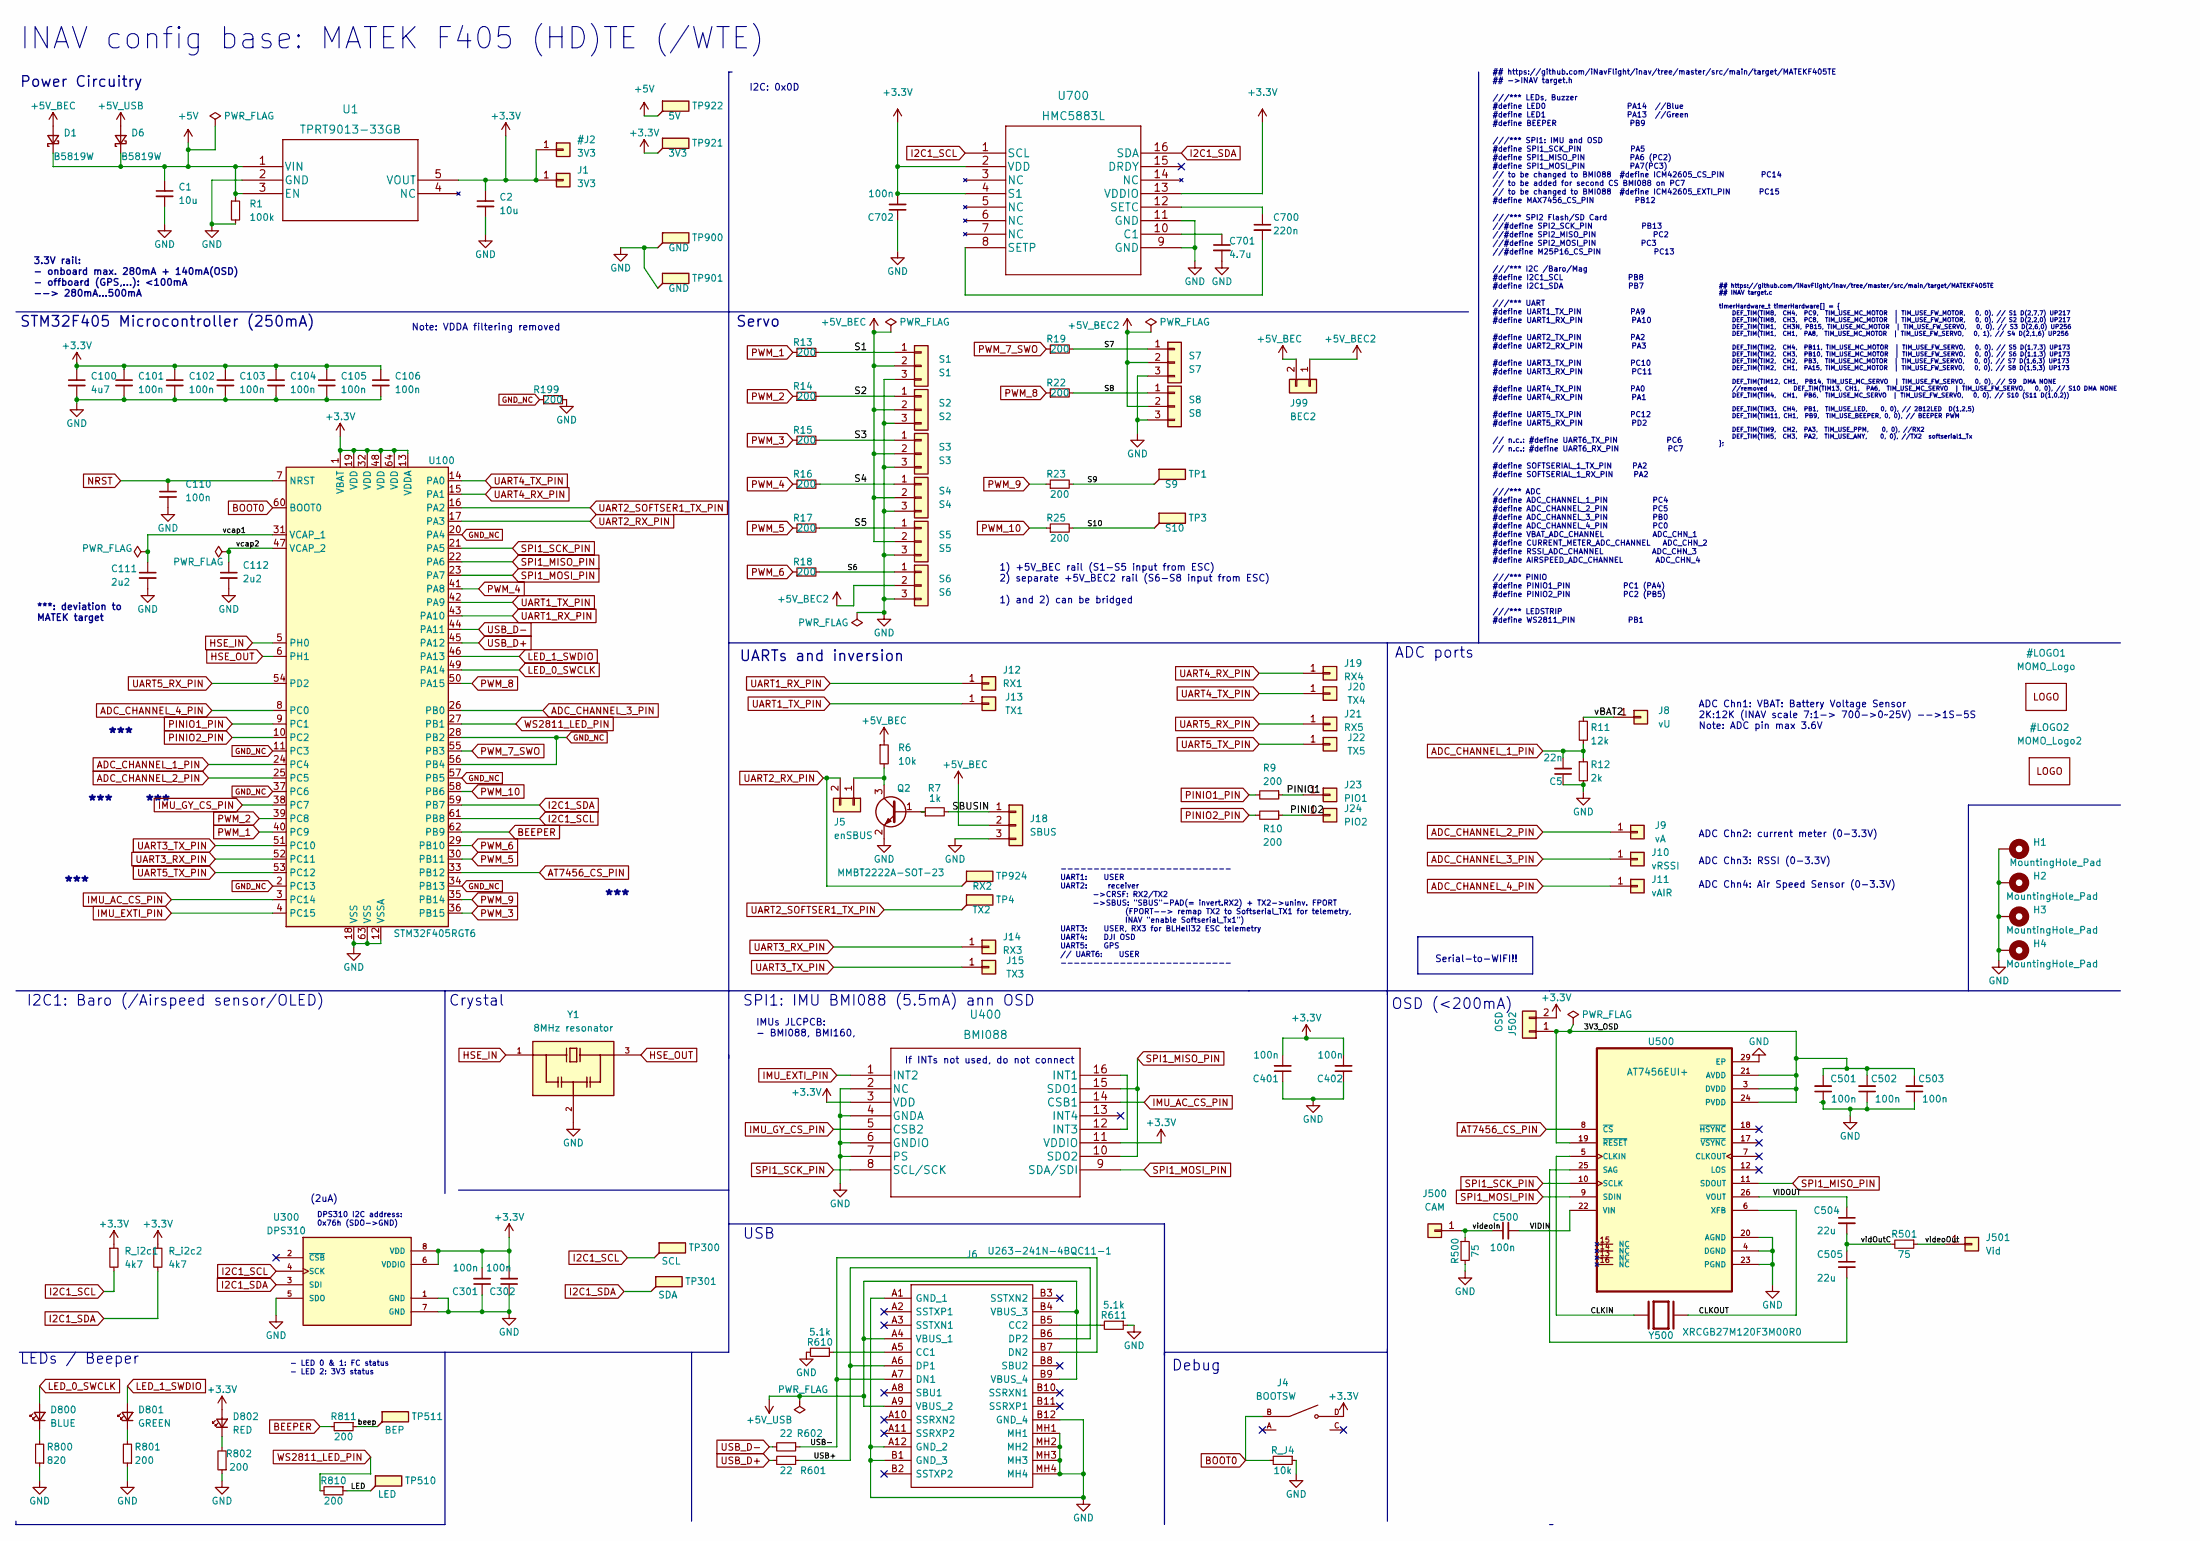
[picture p50: schematic 02_KiCAD FC MomoRC.kicad_sch]

Parts:
C1: 10u; C_0805_2012Metric; LCSC Part # C15850
C2: 10u; C_0603_1608Metric; LCSC Part # C96446
C5: 22n; C_0402_1005Metric; LCSC Part # C1532
C100: 4u7; C_0603_1608Metric; LCSC Part # C19666
C101, C102, C103, C104, C105, C106, C110, C301, C302, C401, C402, C501, C502, C503, C702: 100n; C_0402_1005Metric; LCSC Part # C1525
C111, C112: 2u2; C_0603_1608Metric; LCSC Part # C23630
C500: 100n; C_0603_1608Metric; LCSC Part # C14663
C504, C505: 22u; C_0603_1608Metric; LCSC Part # C59461
C700: 220n; C_0402_1005Metric; LCSC Part # C16772
C701: 4.7u; C_0402_1005Metric; LCSC Part # C23733
D1, D6: B5819W; D_SOD-123; LCSC Part # C8598
D800: BLUE; LED_0603_1608Metric; LCSC Part # C72041
D801: GREEN; LED_0603_1608Metric; LCSC Part # C72043
D802: RED; LED_0603_1608Metric; LCSC Part # C2286
H1, H2, H3, H4: MountingHole_Pad; MountingHole_2.2mm_M2_DIN965_Pad; LCSC Part # empty
J1: 3V3; PinHeader_1x01_P2.54mm_Vertical; LCSC Part # empty
J4: BOOTSW; SW_TS-1187A-B-A-B; PARTREV A0; LCSC Part # C318884
J5: enSBUS; PinHeader_1x02_P1.27mm_Vertical; LCSC Part # empty
J6: U263-241N-4BQC11-1; U263241N4BQC111; Manufacturer_Part_Number U263-241N-4BQC11-1; LCSC Part # C381139
J8: vU; PinHeader_1x01_P2.54mm_Vertical; LCSC Part # empty
J9: vA; PinHeader_1x01_P2.54mm_Vertical; LCSC Part # empty
J10: vRSSI; PinHeader_1x01_P2.54mm_Vertical; LCSC Part # empty
J11: vAIR; FlightController_Pad_1.5mm_large; LCSC Part # empty
J12: RX1; PinHeader_1x01_P2.54mm_Vertical; LCSC Part # empty
J13: TX1; PinHeader_1x01_P2.54mm_Vertical; LCSC Part # empty
J14: RX3; PinHeader_1x01_P2.54mm_Vertical; LCSC Part # empty
J15: TX3; PinHeader_1x01_P2.54mm_Vertical; LCSC Part # empty
J18: SBUS; PinHeader_1x03_P2.54mm_Vertical; LCSC Part # empty
J19: RX4; PinHeader_1x01_P2.54mm_Vertical; LCSC Part # empty
J20: TX4; PinHeader_1x01_P2.54mm_Vertical; LCSC Part # empty
J21: RX5; PinHeader_1x01_P2.54mm_Vertical; LCSC Part # empty
J22: TX5; PinHeader_1x01_P2.54mm_Vertical; LCSC Part # empty
J23: PIO1; PinHeader_1x01_P2.54mm_Vertical; LCSC Part # empty
J24: PIO2; PinHeader_1x01_P2.54mm_Vertical; LCSC Part # empty
J99: BEC2; PinHeader_1x02_P1.27mm_Vertical; LCSC Part # empty
J500: CAM; FlightController_Pad_1.5mm_large; LCSC Part # empty
J501: Vid; FlightController_Pad_1.5mm_large; LCSC Part # empty
J502: OSD; PinHeader_1x02_P1.27mm_Vertical; LCSC Part # empty
Q2: MMBT2222A-SOT-23; SOT-23; LCSC Part # C8512
R1: 100k; R_0402_1005Metric; LCSC Part # C25741
R6: 10k; R_0402_1005Metric; LCSC Part # C25744
R7: 1k; R_0402_1005Metric; LCSC Part # C11702
R9, R10, R13, R14, R15, R16, R17, R18, R19, R22, R23, R25, R199: 200; R_0402_1005Metric; LCSC Part # C25087
R11: 12k; R_0402_1005Metric; LCSC Part # C25752
R12: 2k; R_0402_1005Metric; LCSC Part # C4109
R500, R501: 75; R_0402_1005Metric; LCSC Part # C25133
R601, R602: 22; R_0402_1005Metric; LCSC Part # C25092
R610, R611: 5.1k; R_0402_1005Metric_Pad0.72x0.64mm_HandSolder; LCSC Part # C25905
R800: 820; R_0603_1608Metric_Pad0.98x0.95mm_HandSolder; LCSC Part # C23253
R801, R802: 200; R_0603_1608Metric_Pad0.98x0.95mm_HandSolder; LCSC Part # C8218
R810, R811: 200; R_0603_1608Metric; LCSC Part # C8218
R_J4: 10k; R_0402_1005Metric; LCSC Part # C25744
R_i2c1, R_i2c2: 4k7; R_0402_1005Metric; LCSC Part # C25900
S1: S1; PinHeader_1x03_P2.54mm_Vertical; LCSC Part # empty
S2: S2; PinHeader_1x03_P2.54mm_Vertical; LCSC Part # empty
S3: S3; PinHeader_1x03_P2.54mm_Vertical; LCSC Part # empty
S4: S4; PinHeader_1x03_P2.54mm_Vertical; LCSC Part # empty
S5: S5; PinHeader_1x03_P2.54mm_Vertical; LCSC Part # empty
S6: S6; PinHeader_1x03_P2.54mm_Vertical; LCSC Part # empty
S7: S7; PinHeader_1x03_P2.54mm_Vertical; LCSC Part # empty
S8: S8; PinHeader_1x03_P2.54mm_Vertical; LCSC Part # empty
TP1: S9; PinHeader_1x01_P2.54mm_Vertical; LCSC Part # empty
TP3: S10; PinHeader_1x01_P2.54mm_Vertical; LCSC Part # empty
TP4: TX2; PinHeader_1x01_P2.54mm_Vertical; LCSC Part # empty
TP300: SCL; PinHeader_1x01_P2.54mm_Vertical; LCSC Part # empty
TP301: SDA; PinHeader_1x01_P2.54mm_Vertical; LCSC Part # empty
TP510: LED; FlightController_Pad_1.5mm_small; LCSC Part # empty
TP511: BEP; PinHeader_1x01_P2.54mm_Vertical; LCSC Part # empty
TP900, TP901: GND; PinHeader_1x01_P2.54mm_Vertical; LCSC Part # empty
TP921: 3V3; PinHeader_1x01_P2.54mm_Vertical; LCSC Part # empty
TP922: 5V; PinHeader_1x01_P2.54mm_Vertical; LCSC Part # empty
TP924: RX2; PinHeader_1x01_P2.54mm_Vertical; LCSC Part # empty
U1: TPRT9013-33GB; RT9013-18GB; LCSC Part # C587158
U100: STM32F405RGT6; LQFP-64_10x10mm_P0.5mm; LCSC Part # C15742
U300: DPS310; XDCR_DPS310; LCSC Part # C130156
U400: BMI088; LCSC Part # C194919
U500: AT7456EUI+; SOP65P637X110-28N; LCSC Part # C82351
U700: HMC5883L; LCSC Part # C976032
Y1: 8MHz resonator; OSC_CSTCE8M00G52-R0; PARTREV May 7, 2019; LCSC Part # C22549
Y500: XRCGB27M120F3M00R0; OSC_XRCGB27M120F3M00R0; PARTREV N/A; LCSC Part # C576558

Connections:
3V3_OSD: C501.2, C502.2, C503.2, J502.1, U500.3 (DVDD), U500.19 (~RESET), U500.21 (AVDD), U500.24 (PVDD)
+3.3V: C2.1, C100.1, C101.1, C102.1, C103.1, C104.1, C105.1, C106.1, C301.2, C302.2, C401.2, C402.2, C702.2, D802.2 (A), J1.1, J4.D, J502.2, R_i2c1.1, R_i2c2.1, TP921.1, U1.5 (VOUT), U100.1 (VBAT), U100.13 (VDDA), U100.19 (VDD), U100.32 (VDD), U100.48 (VDD), U100.64 (VDD), U300.6 (VDDIO), U300.8 (VDD), U400.3 (VDD), U400.11 (VDDIO), U700.2 (VDD), U700.4 (S1), U700.13 (VDDIO)
+5V: C1.1, D1.1 (K), D6.1 (K), R1.1, TP922.1, U1.1 (VIN), U1.3 (EN)
+5V_BEC: D1.2 (A), J18.2, J99.2, R6.1, S1.2, S2.2, S3.2, S4.2, S5.2
+5V_BEC2: J99.1, S6.2, S7.2, S8.2
+5V_USB: D6.2 (A), J6.A4 (VBUS_1), J6.A9 (VBUS_2), J6.B4 (VBUS_3), J6.B9 (VBUS_4)
ADC_CHANNEL_1_PIN: C5.2, R11.2, R12.1, U100.24 (PC4)
ADC_CHANNEL_2_PIN: J9.1, U100.25 (PC5)
ADC_CHANNEL_3_PIN: J10.1, U100.26 (PB0)
ADC_CHANNEL_4_PIN: J11.1, U100.8 (PC0)
AT7456_CS_PIN: U100.33 (PB12), U500.8 (~CS)
BEEPER: R811.2, U100.62 (PB9)
BOOT0: J4.B, R_J4.2, U100.60 (BOOT0)
CLKIN: U500.5 (CLKIN), Y500.1
CLKOUT: U500.6 (XFB), Y500.3
GND: C1.2, C2.2, C5.1, C100.2, C101.2, C102.2, C103.2, C104.2, C105.2, C106.2, C110.2, C111.2, C112.2, C301.1, C302.1, C401.1, C402.1, C501.1, C502.1, C503.1, C701.2, C702.1, H1.1, H2.1, H3.1, H4.1, J6.A1 (GND_1), J6.A12 (GND_2), J6.B1 (GND_3), J6.B12 (GND_4), J6.MH1, J6.MH2, J6.MH3, J6.MH4, J18.3, Q2.2 (E), R1.2, R12.2, R199.2, R500.2, R610.2, R611.1, R800.1, R801.1, R802.1, R_J4.1, S1.3, S2.3, S3.3, S4.3, S5.3, S6.3, S7.3, S8.3, TP900.1, TP901.1, U1.2 (GND), U100.12 (VSSA), U100.18 (VSS), U100.63 (VSS), U300.1 (GND), U300.5 (SDO), U300.7 (GND), U400.2 (NC), U400.4 (GNDA), U400.6 (GNDIO), U400.7 (PS), U500.4 (DGND), U500.20 (AGND), U500.23 (PGND), U500.29 (EP), U700.9 (GND), U700.11 (GND), Y1.2
GND_NC: R199.1, U100.2 (PC13), U100.11 (PC3), U100.20 (PA4), U100.28 (PB2), U100.34 (PB13), U100.37 (PC6), U100.56 (PB4), U100.57 (PB5)
HSE_IN: U100.5 (PH0), Y1.1
HSE_OUT: U100.6 (PH1), Y1.3
I2C1_SCL: R_i2c1.2, TP300.1, U100.61 (PB8), U300.4 (SCK), U700.1 (SCL)
I2C1_SDA: R_i2c2.2, TP301.1, U100.59 (PB7), U300.3 (SDI), U700.16 (SDA)
IMU_AC_CS_PIN: U100.3 (PC14), U400.14 (CSB1)
IMU_EXTI_PIN: U100.4 (PC15), U400.1 (INT2)
IMU_GY_CS_PIN: U100.38 (PC7), U400.5 (CSB2)
LED: R810.1, TP510.1
LED_0_SWCLK: D800.2 (A), U100.49 (PA14)
LED_1_SWDIO: D801.2 (A), U100.46 (PA13)
NRST: C110.1, U100.7 (NRST)
unnamed: C505.2, U500.25 (SAG)
unnamed: C700.1, U700.12 (SETC)
unnamed: C700.2, U700.8 (SETP)
unnamed: C701.1, U700.10 (C1)
unnamed: D800.1 (K), R800.2
unnamed: D801.1 (K), R801.2
unnamed: D802.1 (K), R802.2
unnamed: J5.1, Q2.3 (C), R6.2
unnamed: J6.A5 (CC1), R610.1
unnamed: J6.B5 (CC2), R611.2
unnamed: Q2.1 (B), R7.1
unnamed: U400.12 (INT3), U400.16 (INT1)
PINIO1: J23.1, R9.1
PINIO1_PIN: R9.2, U100.9 (PC1)
PINIO2: J24.1, R10.1
PINIO2_PIN: R10.2, U100.10 (PC2)
PWM_1: R13.1, U100.40 (PC9)
PWM_2: R14.1, U100.39 (PC8)
PWM_3: R15.1, U100.36 (PB15)
PWM_4: R16.1, U100.41 (PA8)
PWM_5: R17.1, U100.30 (PB11)
PWM_6: R18.1, U100.29 (PB10)
PWM_7_SWO: R19.1, U100.55 (PB3)
PWM_8: R22.1, U100.50 (PA15)
PWM_9: R23.1, U100.35 (PB14)
PWM_10: R25.1, U100.58 (PB6)
S1: R13.2, S1.1
S2: R14.2, S2.1
S3: R15.2, S3.1
S4: R16.2, S4.1
S5: R17.2, S5.1
S6: R18.2, S6.1
S7: R19.2, S7.1
S8: R22.2, S8.1
S9: R23.2, TP1.1
S10: R25.2, TP3.1
SBUSIN: J18.1, R7.2
SPI1_MISO_PIN: U100.22 (PA6), U400.10 (SDO2), U400.15 (SDO1), U500.11 (SDOUT)
SPI1_MOSI_PIN: U100.23 (PA7), U400.9 (SDA/SDI), U500.9 (SDIN)
SPI1_SCK_PIN: U100.21 (PA5), U400.8 (SCL/SCK), U500.10 (SCLK)
UART1_RX_PIN: J12.1, U100.43 (PA10)
UART1_TX_PIN: J13.1, U100.42 (PA9)
UART2_RX_PIN: J5.2, TP924.1, U100.17 (PA3)
UART2_SOFTSER1_TX_PIN: TP4.1, U100.16 (PA2)
UART3_RX_PIN: J14.1, U100.52 (PC11)
UART3_TX_PIN: J15.1, U100.51 (PC10)
UART4_RX_PIN: J19.1, U100.15 (PA1)
UART4_TX_PIN: J20.1, U100.14 (PA0)
UART5_RX_PIN: J21.1, U100.54 (PD2)
UART5_TX_PIN: J22.1, U100.53 (PC12)
USB+: J6.A6 (DP1), J6.B6 (DP2), R601.1
USB-: J6.A7 (DN1), J6.B7 (DN2), R602.1
USB_D+: R601.2, U100.45 (PA12)
USB_D-: R602.2, U100.44 (PA11)
VIDIN: C500.2, U500.22 (VIN)
VIDOUT: C504.1, U500.26 (VOUT)
WS2811_LED_PIN: R810.2, U100.27 (PB1)
beep: R811.1, TP511.1
vBAT2: J8.1, R11.1
vcap1: C111.1, U100.31 (VCAP_1)
vcap2: C112.1, U100.47 (VCAP_2)
vidOutC: C504.2, C505.1, R501.2
videoIn: C500.1, J500.1, R500.1
videoOut: J501.1, R501.1

Notes on the sheet:
***
ADC Chn4: Air Speed Sensor (0-3.3V)
LEDs / Beeper
ADC Chn3: RSSI (0-3.3V)
***: deviation to MATEK target
USB
Power Circuitry
UARTs and inversion
ADC Chn2: current meter (0-3.3V)
(2uA)
INAV config base: MATEK F405 (HD)TE (/WTE)
Serial-to-WIFI!!
-------------------------- UART1: USER UART2: receiver ->CRSF: RX2/TX2 ->SBUS: "SBUS"-PAD(= invert.RX2) + TX2->uninv. FPORT (FPORT--> remap TX2 to Softserial_TX1 for telemetry, INAV "enable Softserial_Tx1") UART3: USER, RX3 for BLHeli32 ESC telemetry UART4: DJI OSD UART5: GPS // UART6: USER -------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
Debug
ADC Chn1: VBAT: Battery Voltage Sensor 2K:12K (INAV scale 7:1-> 700->0~25V) -->1S-5S Note: ADC pin max 3.6V
## https://github.com/iNavFlight/inav/tree/master/src/main/target/MATEKF405TE ## ->INAV target.h ///*** LEDs, Buzzer #define LED0 PA14 //Blue #define LED1 PA13 //Green #define BEEPER PB9 ///*** SPI1: IMU and OSD #define SPI1_SCK_PIN PA5 #define SPI1_MISO_PIN PA6 (PC2) #define SPI1_MOSI_PIN PA7(PC3)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
If INTs not used, do not connect
OSD (<200mA)
SPI1: IMU BMI088 (5.5mA) ann OSD
IMUs JLCPCB: - BMI088, BMI160,
STM32F405 Microcontroller (250mA)
1) +5V_BEC rail (S1-S5 input from ESC) 2) separate +5V_BEC2 rail (S6-S8 input from ESC) 1) and 2) can be bridged
I2C1: Baro (/Airspeed sensor/OLED)
DPS310 I2C address: 0x76h (SDO->GND)
ADC ports
## https://github.com/iNavFlight/inav/tree/master/src/main/target/MATEKF405TE ## INAV target.c timerHardware_t timerHardware[] = { DEF_TIM(TIM8, CH4, PC9, TIM_USE_MC_MOTOR | TIM_USE_FW_MOTOR, 0, 0), // S1 D(2,7,7) UP217 DEF_TIM(TIM8, CH3, PC8, TIM_USE_MC_MOTOR | TIM_USE_FW_MOTOR, 0, 0), // S2 D(2,2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
Servo
Crystal
Note: VDDA filtering removed
- LED 0 & 1: FC status - LED 2: 3V3 status
3.3V rail: - onboard max. 280mA + 140mA(OSD) - offboard (GPS,...): <100mA --> 280mA...500mA
I2C: 0x0D
