MomoRC-tech/MoGliFC-Flight-Controller/development/10_KiCAD FC/MoGliFC/MoGliFC.kicad_sch

## KiCad design development/10_KiCAD FC/MoGliFC/MoGliFC.kicad_sch (2024-08-12, an earlier design)

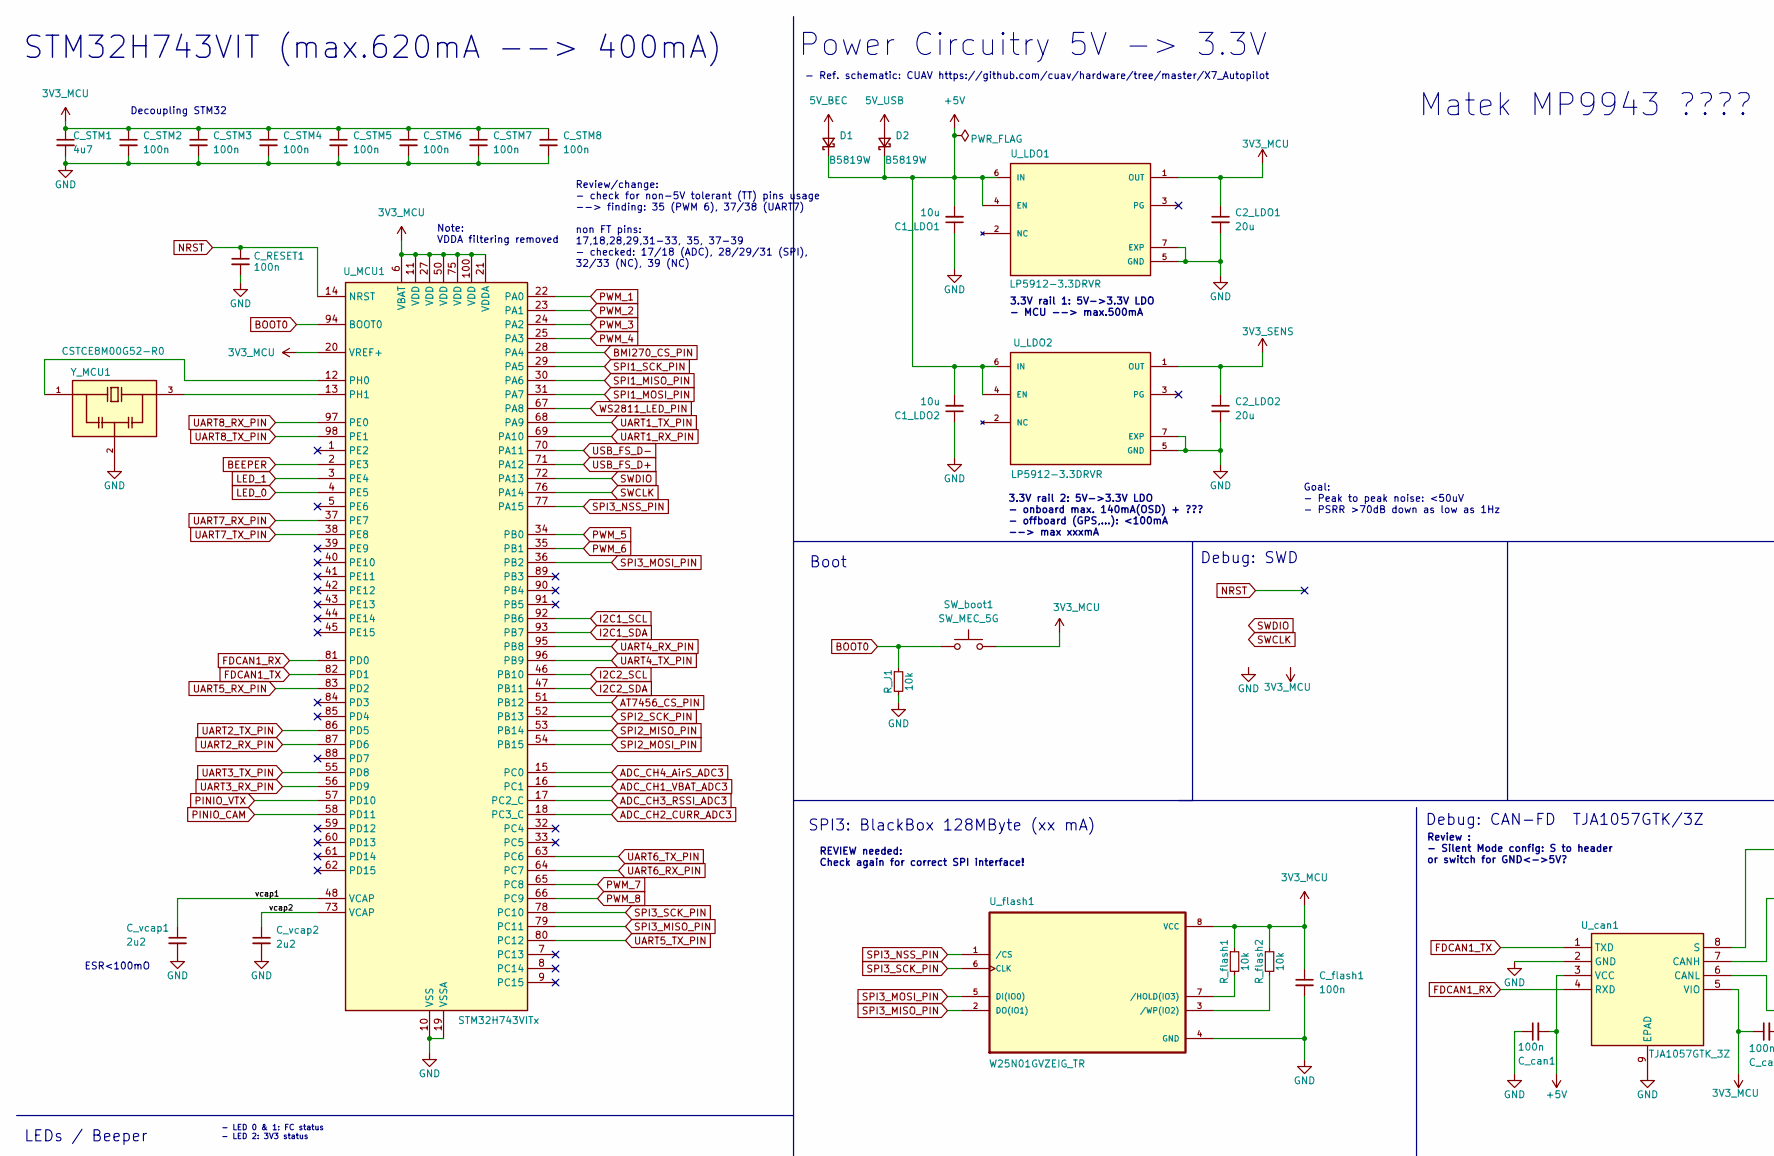
[picture p51: schematic MoGliFC.kicad_sch, part in row 1, column 1]

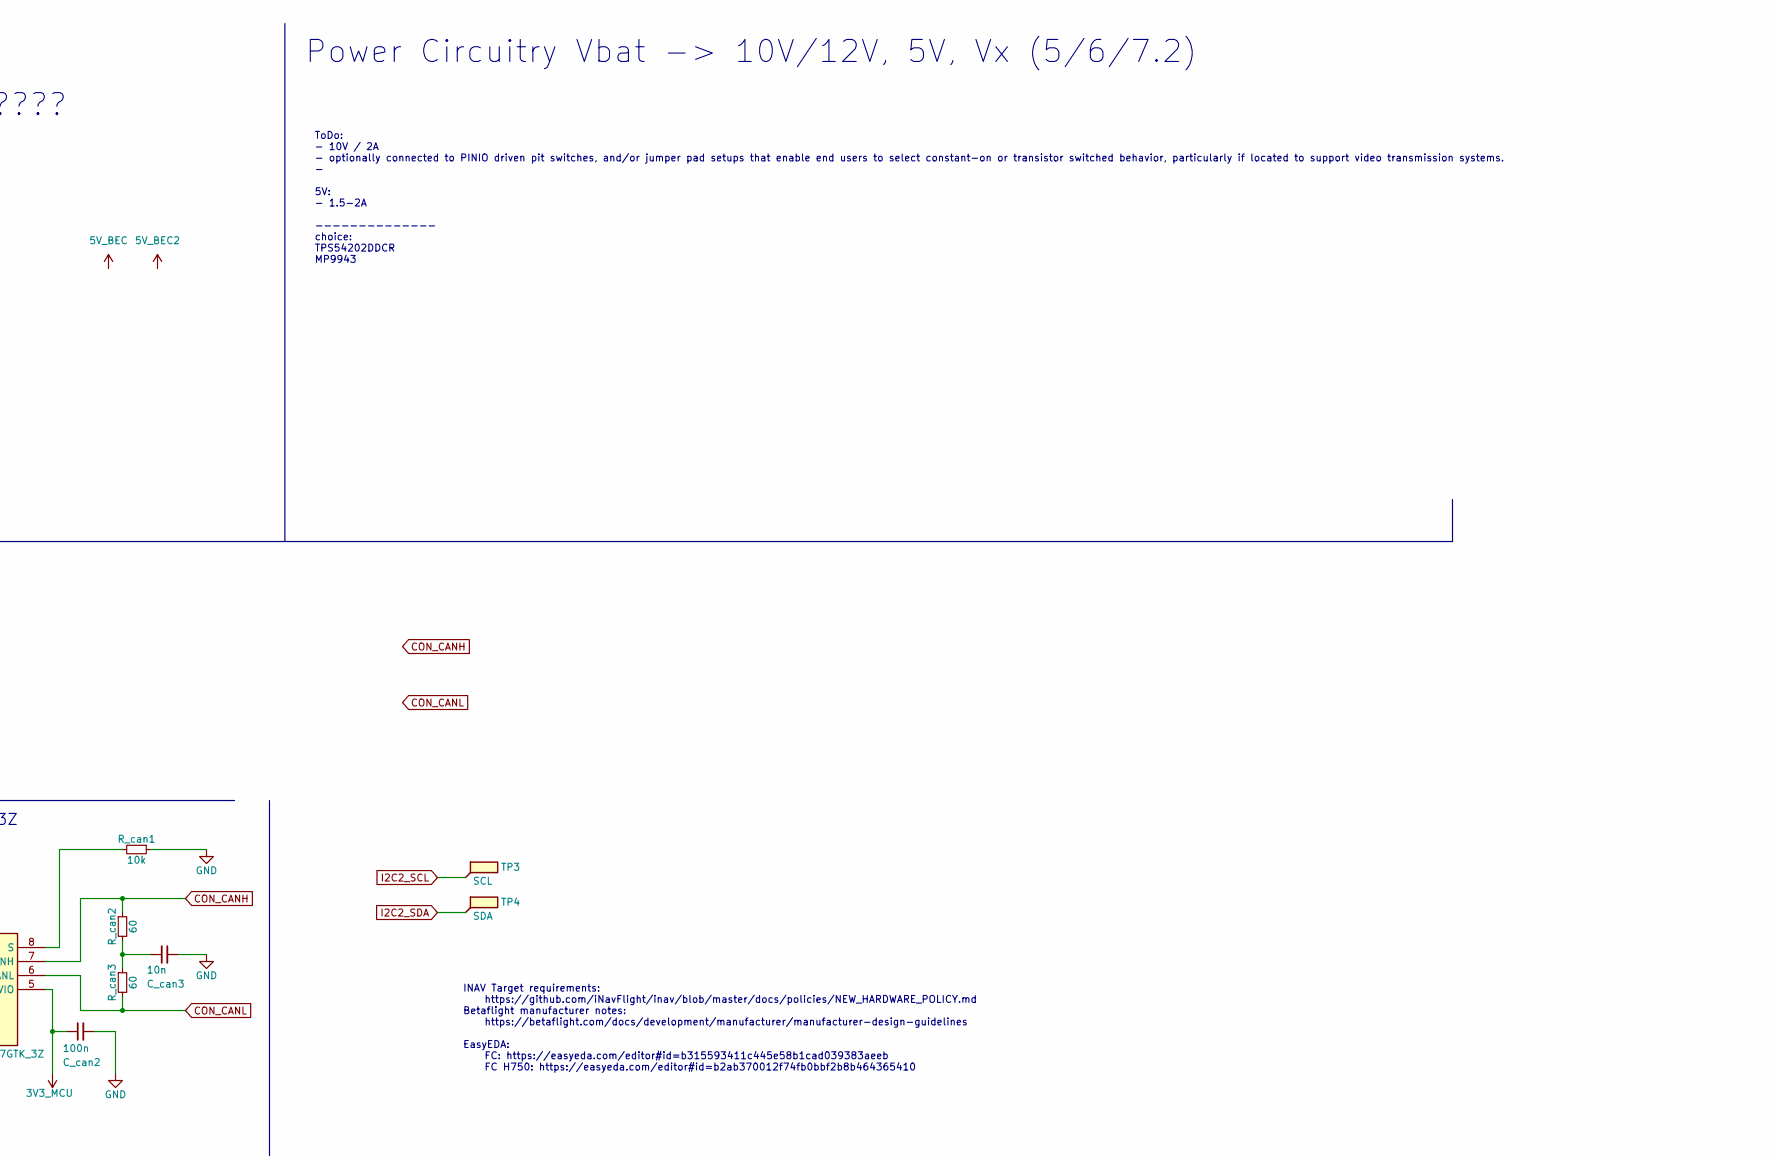
[picture p52: schematic MoGliFC.kicad_sch, part in row 1, column 2]

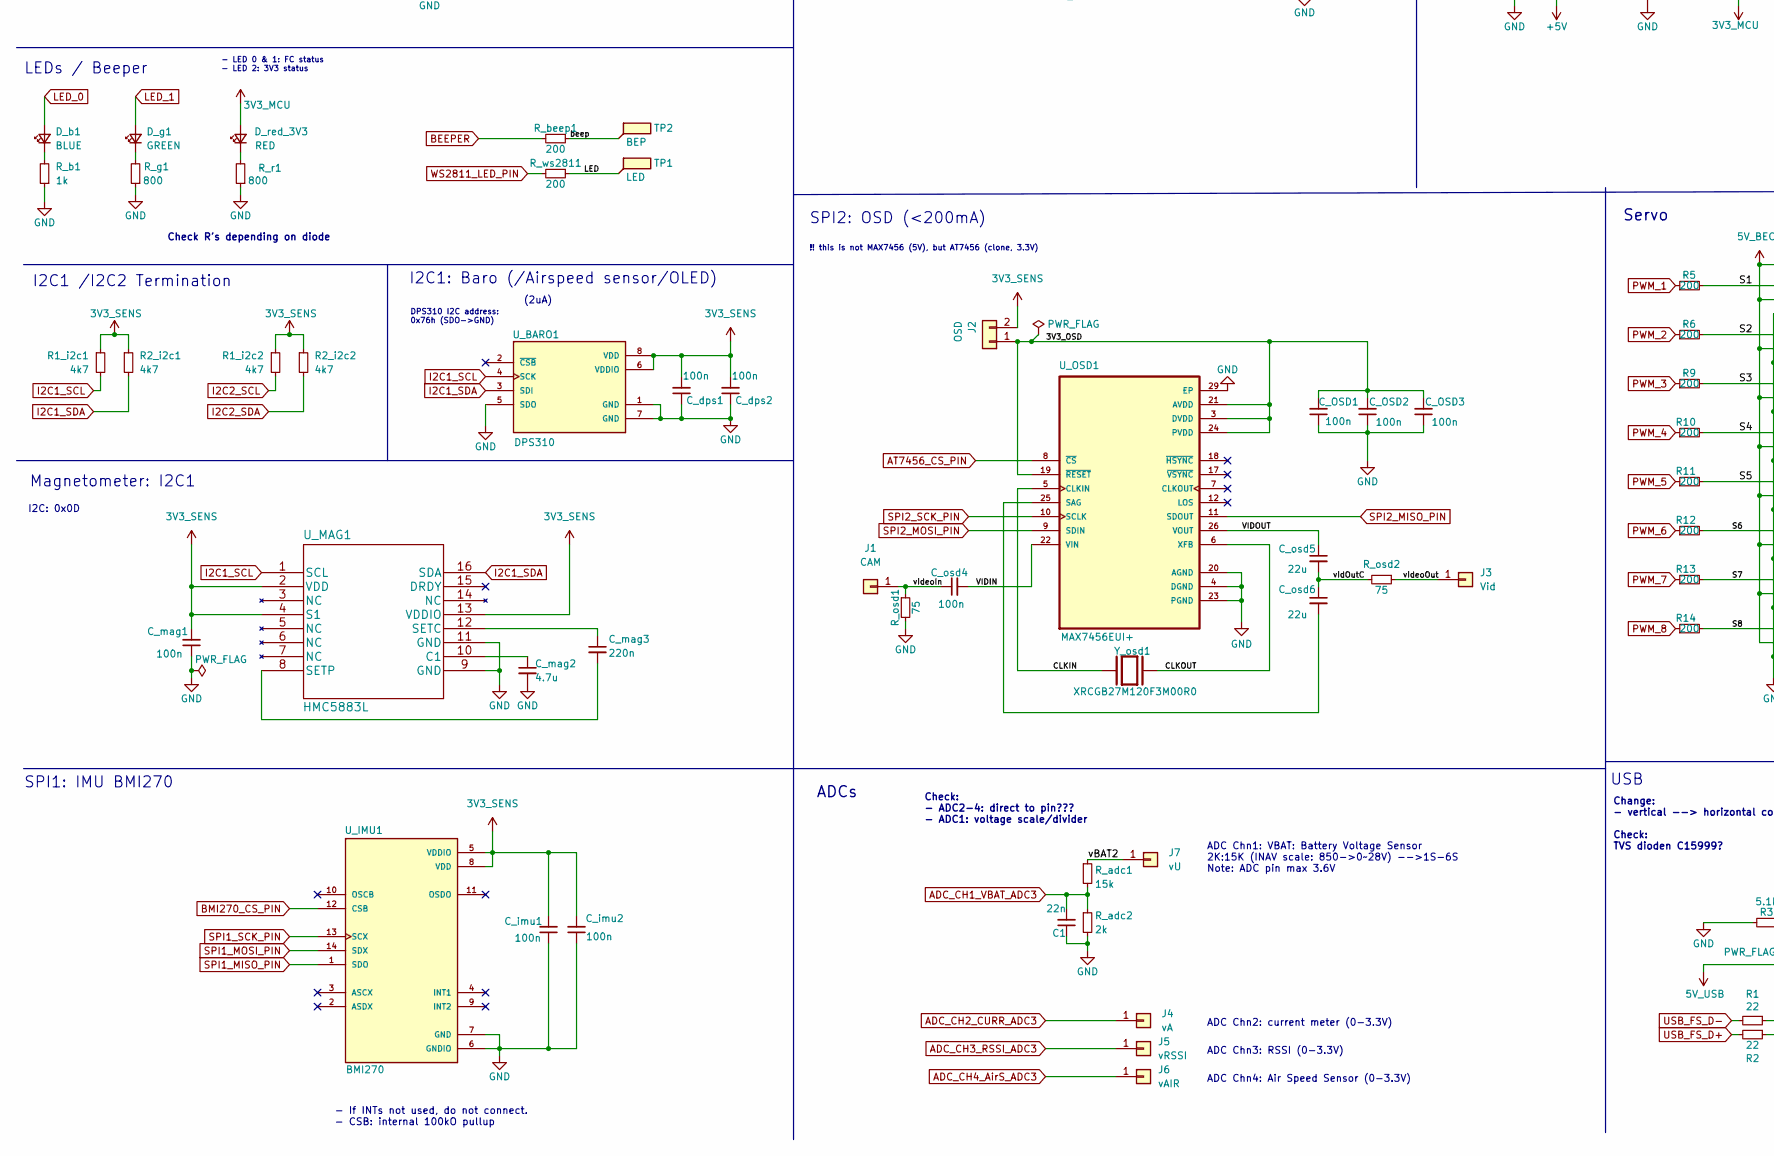
[picture p53: schematic MoGliFC.kicad_sch, part in row 2, column 1]

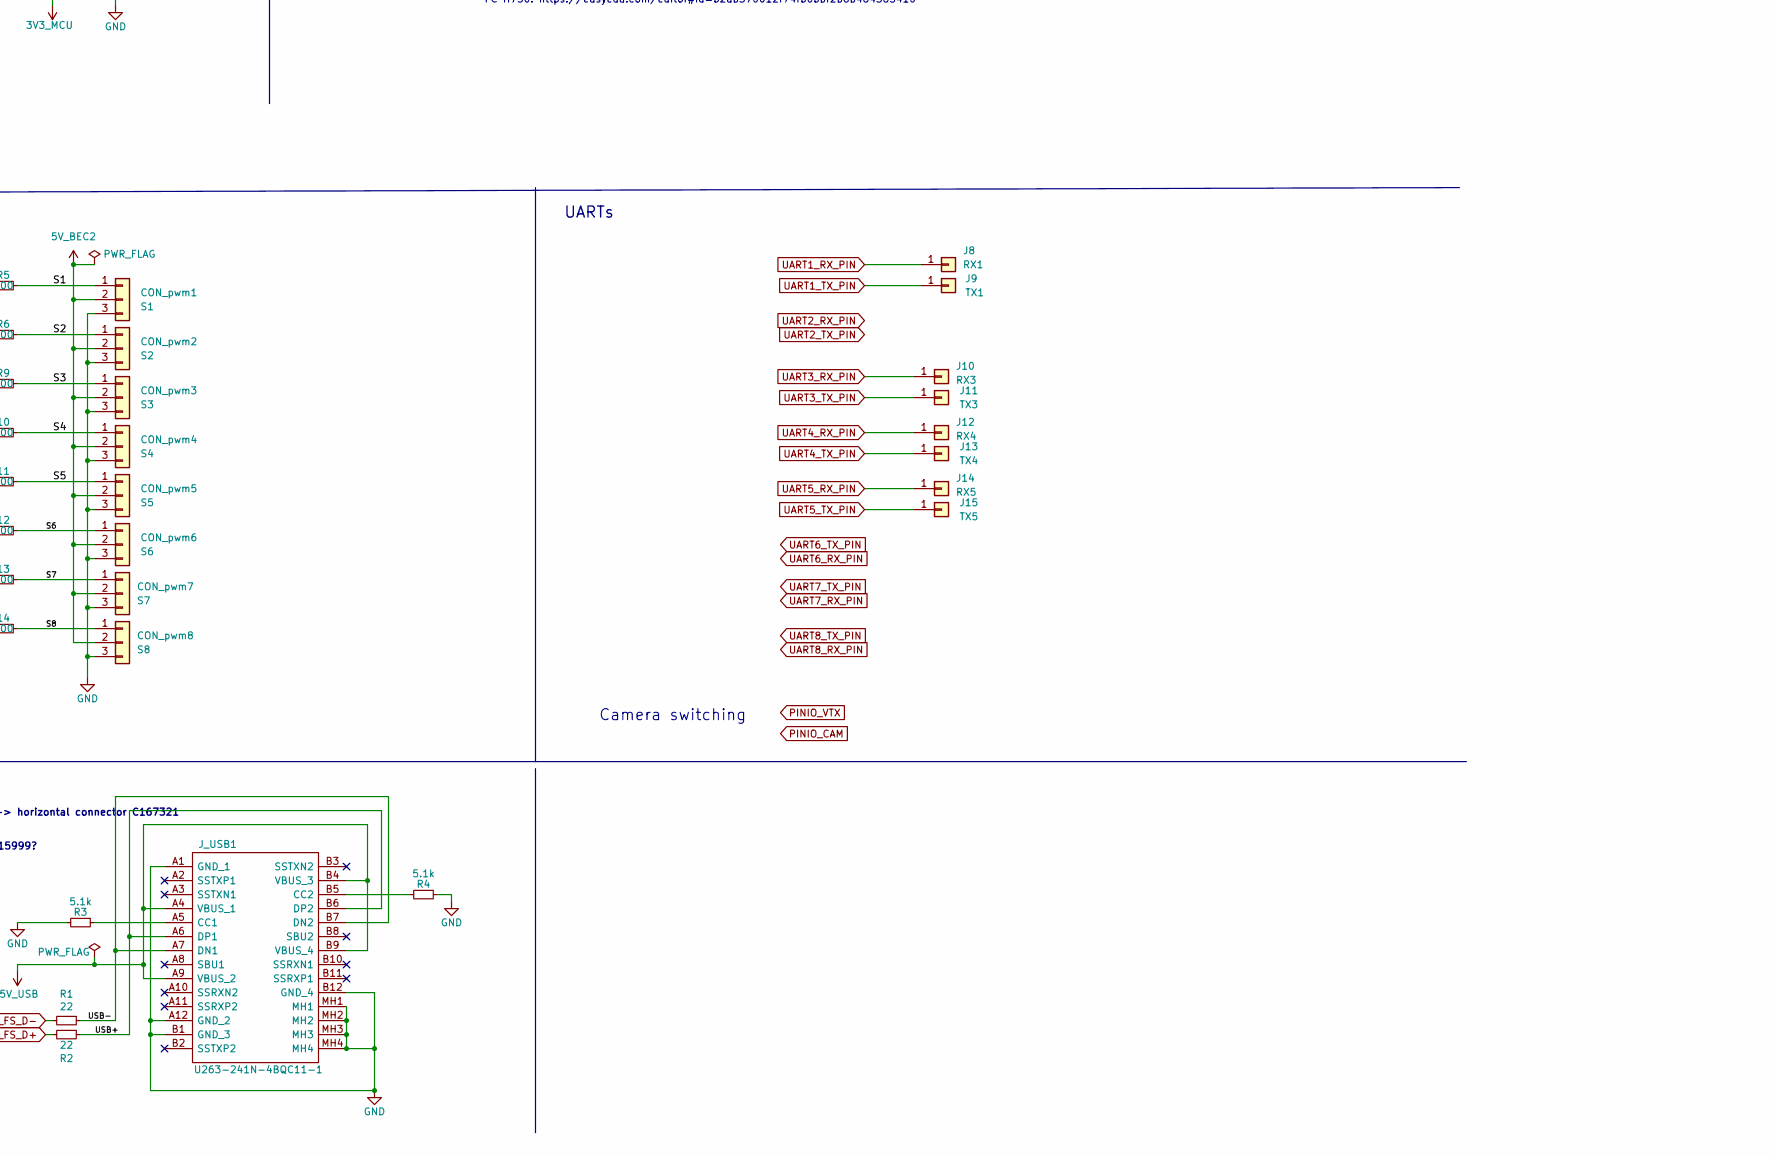
[picture p54: schematic MoGliFC.kicad_sch, part in row 2, column 2]

Parts:
C1: 22n; C_0402_1005Metric; LCSC Part # C1532
C1_LDO1, C1_LDO2: 10u; C_0805_2012Metric; LCSC Part # C15850
C2_LDO1, C2_LDO2: 20u; C_0805_2012Metric; LCSC Part # C15850
CON_pwm1: S1; PinHeader_1x03_P2.54mm_Vertical; LCSC Part # empty
CON_pwm2: S2; PinHeader_1x03_P2.54mm_Vertical; LCSC Part # empty
CON_pwm3: S3; PinHeader_1x03_P2.54mm_Vertical; LCSC Part # empty
CON_pwm4: S4; PinHeader_1x03_P2.54mm_Vertical; LCSC Part # empty
CON_pwm5: S5; PinHeader_1x03_P2.54mm_Vertical; LCSC Part # empty
CON_pwm6: S6; PinHeader_1x03_P2.54mm_Vertical; LCSC Part # empty
CON_pwm7: S7; PinHeader_1x03_P2.54mm_Vertical; LCSC Part # empty
CON_pwm8: S8; PinHeader_1x03_P2.54mm_Vertical; LCSC Part # empty
C_OSD1, C_OSD2, C_OSD3: 100n; C_0402_1005Metric; LCSC Part # C1525
C_RESET1: 100n; C_0402_1005Metric; LCSC Part # C1525
C_STM1: 4u7; C_0603_1608Metric; LCSC Part # C19666
C_STM2, C_STM3, C_STM4, C_STM5, C_STM6, C_STM7, C_STM8: 100n; C_0402_1005Metric; LCSC Part # C1525
C_can1, C_can2: 100n; C_0402_1005Metric; LCSC Part # C1525
C_can3: 10n; C_0402_1005Metric
C_dps1, C_dps2: 100n; C_0402_1005Metric; LCSC Part # C1525
C_flash1: 100n; C_0402_1005Metric; LCSC Part # C1525
C_imu1, C_imu2: 100n; C_0402_1005Metric; LCSC Part # C1525
C_mag1: 100n; C_0402_1005Metric; LCSC Part # C1525
C_mag2: 4.7u; C_0402_1005Metric; LCSC Part # C23733
C_mag3: 220n; C_0402_1005Metric; LCSC Part # C16772
C_osd4: 100n; C_0603_1608Metric; LCSC Part # C14663
C_osd5, C_osd6: 22u; C_0603_1608Metric; LCSC Part # C59461
C_vcap1, C_vcap2: 2u2; C_0603_1608Metric; LCSC Part # C23630
D1, D2: B5819W; D_SOD-123; LCSC Part # C8598
D_b1: BLUE; LED_0603_1608Metric; LCSC Part # C72041
D_g1: GREEN; LED_0603_1608Metric; LCSC Part # C72043
D_red_3V3: RED; LED_0603_1608Metric; LCSC Part # C2286
J1: CAM; FlightController_Pad_1.5mm_large; LCSC Part # empty
J2: OSD; PinHeader_1x02_P1.27mm_Vertical; LCSC Part # empty
J3: Vid; FlightController_Pad_1.5mm_large; LCSC Part # empty
J4: vA; PinHeader_1x01_P2.54mm_Vertical; LCSC Part # empty
J5: vRSSI; PinHeader_1x01_P2.54mm_Vertical; LCSC Part # empty
J6: vAIR; FlightController_Pad_1.5mm_large; LCSC Part # empty
J7: vU; PinHeader_1x01_P2.54mm_Vertical; LCSC Part # empty
J8: RX1; PinHeader_1x01_P2.54mm_Vertical; LCSC Part # empty
J9: TX1; PinHeader_1x01_P2.54mm_Vertical; LCSC Part # empty
J10: RX3; PinHeader_1x01_P2.54mm_Vertical; LCSC Part # empty
J11: TX3; PinHeader_1x01_P2.54mm_Vertical; LCSC Part # empty
J12: RX4; PinHeader_1x01_P2.54mm_Vertical; LCSC Part # empty
J13: TX4; PinHeader_1x01_P2.54mm_Vertical; LCSC Part # empty
J14: RX5; PinHeader_1x01_P2.54mm_Vertical; LCSC Part # empty
J15: TX5; PinHeader_1x01_P2.54mm_Vertical; LCSC Part # empty
J_USB1: U263-241N-4BQC11-1; U263241N4BQC111; Manufacturer_Part_Number U263-241N-4BQC11-1
R1, R2: 22; R_0402_1005Metric; LCSC Part # C25092
R1_i2c1, R1_i2c2, R2_i2c1, R2_i2c2: 4k7; R_0402_1005Metric; LCSC Part # C25900
R3, R4: 5.1k; R_0402_1005Metric_Pad0.72x0.64mm_HandSolder; LCSC Part # C25905
R5, R6, R9, R10, R11, R12, R13, R14: 200; R_0402_1005Metric; LCSC Part # C25087
R_J1: 10k; R_0402_1005Metric; LCSC Part # C25744
R_adc1: 15k; R_0402_1005Metric
R_adc2: 2k; R_0402_1005Metric
R_b1: 1k; R_0603_1608Metric_Pad0.98x0.95mm_HandSolder
R_beep1: 200; R_0603_1608Metric; LCSC Part # C8218
R_can1: 10k; R_0402_1005Metric; LCSC Part # C25744
R_can2, R_can3: 60; R_0402_1005Metric
R_flash1, R_flash2: 10k; R_0402_1005Metric; LCSC Part # C25744
R_g1: 800; R_0603_1608Metric_Pad0.98x0.95mm_HandSolder
R_osd1, R_osd2: 75; R_0402_1005Metric; LCSC Part # C25133
R_r1: 800; R_0603_1608Metric_Pad0.98x0.95mm_HandSolder
R_ws2811: 200; R_0603_1608Metric; LCSC Part # C8218
SW_boot1: SW_MEC_5G; SW_SPST_B3U-1000P-B_C145874; LCSC Part # C145874
TP1: LED; FlightController_Pad_1.5mm_small; JLCPCB BOM 0
TP2: BEP; PinHeader_1x01_P2.54mm_Vertical; JLCPCB BOM 0
TP3: SCL; PinHeader_1x01_P2.54mm_Vertical; JLCPCB BOM 0
TP4: SDA; PinHeader_1x01_P2.54mm_Vertical; JLCPCB BOM 0
U_BARO1: DPS310; XDCR_DPS310
U_IMU1: BMI270; XDCR_BMI270
U_LDO1, U_LDO2: LP5912-3.3DRVR; LP59123.3_SON65P200X200X80-7N; PARTREV D
U_MAG1: HMC5883L; LPCC16_HNW
U_MCU1: STM32H743VITx; LQFP-100_14x14mm_P0.5mm
U_OSD1: MAX7456EUI+; SOP65P637X110-28N
U_can1: TJA1057GTK_3Z; SON65P300X300X100-9N-D; Manufacturer_Part_Number TJA1057GTK/3Z; Mouser Part Number 771-TJA1057GTK/3Z
U_flash1: W25N01GVZEIG_TR; SON127P800X600X80-9N
Y_MCU1: CSTCE8M00G52-R0; OSC_CSTCE8M00G52-R0; PARTREV May 7, 2019
Y_osd1: XRCGB27M120F3M00R0; OSC_XRCGB27M120F3M00R0; PARTREV N/A

Connections:
3V3_MCU: C2_LDO1.1, C_STM1.1, C_STM2.1, C_STM3.1, C_STM4.1, C_STM5.1, C_STM6.1, C_STM7.1, C_STM8.1, C_can2.1, C_flash1.1, D_red_3V3.2 (A), R_flash1.1, R_flash2.1, SW_boot1.3 (B), SW_boot1.4 (B), U_LDO1.1 (OUT), U_MCU1.6 (VBAT), U_MCU1.11 (VDD), U_MCU1.20 (VREF+), U_MCU1.21 (VDDA), U_MCU1.27 (VDD), U_MCU1.50 (VDD), U_MCU1.75 (VDD), U_MCU1.100 (VDD), U_can1.5 (VIO), U_flash1.8 (VCC)
3V3_OSD: C_OSD1.2, C_OSD2.2, C_OSD3.2, J2.1, U_OSD1.3 (DVDD), U_OSD1.19 (~RESET), U_OSD1.21 (AVDD), U_OSD1.24 (PVDD)
3V3_SENS: C2_LDO2.1, C_dps1.2, C_dps2.2, C_imu1.2, C_imu2.2, C_mag1.2, J2.2, R1_i2c1.1, R1_i2c2.1, R2_i2c1.1, R2_i2c2.1, U_BARO1.6 (VDDIO), U_BARO1.8 (VDD), U_IMU1.5 (VDDIO), U_IMU1.8 (VDD), U_LDO2.1 (OUT), U_MAG1.2 (VDD), U_MAG1.4 (S1), U_MAG1.13 (VDDIO)
5V_BEC: D1.2 (A)
5V_BEC2: CON_pwm1.2, CON_pwm2.2, CON_pwm3.2, CON_pwm4.2, CON_pwm5.2, CON_pwm6.2, CON_pwm7.2, CON_pwm8.2
5V_USB: D2.2 (A), J_USB1.A4 (VBUS_1), J_USB1.A9 (VBUS_2), J_USB1.B4 (VBUS_3), J_USB1.B9 (VBUS_4)
+5V: C1_LDO1.2, C1_LDO2.2, C_can1.2, D1.1 (K), D2.1 (K), U_LDO1.4 (EN), U_LDO1.6 (IN), U_LDO2.4 (EN), U_LDO2.6 (IN), U_can1.3 (VCC)
ADC_CH1_VBAT_ADC3: C1.2, R_adc1.2, R_adc2.1, U_MCU1.16 (PC1)
ADC_CH2_CURR_ADC3: J4.1, U_MCU1.18 (PC3_C)
ADC_CH3_RSSI_ADC3: J5.1, U_MCU1.17 (PC2_C)
ADC_CH4_AirS_ADC3: J6.1, U_MCU1.15 (PC0)
AT7456_CS_PIN: U_MCU1.51 (PB12), U_OSD1.8 (~CS)
BEEPER: R_beep1.2, U_MCU1.2 (PE3)
BMI270_CS_PIN: U_IMU1.12 (CSB), U_MCU1.28 (PA4)
BOOT0: R_J1.1, SW_boot1.1 (A), SW_boot1.2 (A), U_MCU1.94 (BOOT0)
CLKIN: U_OSD1.5 (CLKIN), Y_osd1.1
CLKOUT: U_OSD1.6 (XFB), Y_osd1.3
CON_CANH: R_can2.1, U_can1.7 (CANH)
CON_CANL: R_can3.2, U_can1.6 (CANL)
FDCAN1_RX: U_MCU1.81 (PD0), U_can1.4 (RXD)
FDCAN1_TX: U_MCU1.82 (PD1), U_can1.1 (TXD)
GND: C1.1, C1_LDO1.1, C1_LDO2.1, C2_LDO1.2, C2_LDO2.2, CON_pwm1.3, CON_pwm2.3, CON_pwm3.3, CON_pwm4.3, CON_pwm5.3, CON_pwm6.3, CON_pwm7.3, CON_pwm8.3, C_OSD1.1, C_OSD2.1, C_OSD3.1, C_RESET1.2, C_STM1.2, C_STM2.2, C_STM3.2, C_STM4.2, C_STM5.2, C_STM6.2, C_STM7.2, C_STM8.2, C_can1.1, C_can2.2, C_can3.2, C_dps1.1, C_dps2.1, C_flash1.2, C_imu1.1, C_imu2.1, C_mag1.1, C_mag2.2, C_vcap1.2, C_vcap2.2, J_USB1.A1 (GND_1), J_USB1.A12 (GND_2), J_USB1.B1 (GND_3), J_USB1.B12 (GND_4), J_USB1.MH1, J_USB1.MH2, J_USB1.MH3, J_USB1.MH4, R3.2, R4.1, R_J1.2, R_adc2.2, R_b1.1, R_can1.1, R_g1.1, R_osd1.2, R_r1.1, U_BARO1.1 (GND), U_BARO1.5 (SDO), U_BARO1.7 (GND), U_IMU1.6 (GNDIO), U_IMU1.7 (GND), U_LDO1.5 (GND), U_LDO1.7 (EXP), U_LDO2.5 (GND), U_LDO2.7 (EXP), U_MAG1.9 (GND), U_MAG1.11 (GND), U_MCU1.10 (VSS), U_MCU1.19 (VSSA), U_MCU1.26 (VSS), U_MCU1.49 (VSS), U_MCU1.74 (VSS), U_MCU1.99 (VSS), U_OSD1.4 (DGND), U_OSD1.20 (AGND), U_OSD1.23 (PGND), U_OSD1.29 (EP), U_can1.2 (GND), U_can1.9 (EPAD), U_flash1.4 (GND), Y_MCU1.2
I2C1_SCL: R1_i2c1.2, U_BARO1.4 (SCK), U_MAG1.1 (SCL), U_MCU1.92 (PB6)
I2C1_SDA: R2_i2c1.2, U_BARO1.3 (SDI), U_MAG1.16 (SDA), U_MCU1.93 (PB7)
I2C2_SCL: R1_i2c2.2, TP3.1, U_MCU1.46 (PB10)
I2C2_SDA: R2_i2c2.2, TP4.1, U_MCU1.47 (PB11)
LED: R_ws2811.1, TP1.1
LED_0: D_b1.2 (A), U_MCU1.4 (PE5)
LED_1: D_g1.2 (A), U_MCU1.3 (PE4)
NRST: C_RESET1.1, U_MCU1.14 (NRST)
unnamed: C_can3.1, R_can2.2, R_can3.1
unnamed: C_mag2.1, U_MAG1.10 (C1)
unnamed: C_mag3.1, U_MAG1.12 (SETC)
unnamed: C_mag3.2, U_MAG1.8 (SETP)
unnamed: C_osd6.2, U_OSD1.25 (SAG)
unnamed: D_b1.1 (K), R_b1.2
unnamed: D_g1.1 (K), R_g1.2
unnamed: D_red_3V3.1 (K), R_r1.2
unnamed: J_USB1.A5 (CC1), R3.1
unnamed: J_USB1.B5 (CC2), R4.2
unnamed: R_can1.2, U_can1.8 (S)
unnamed: R_flash1.2, U_flash1.7 (/HOLD(IO3))
unnamed: R_flash2.2, U_flash1.3 (/WP(IO2))
unnamed: U_MCU1.12 (PH0), Y_MCU1.1
unnamed: U_MCU1.13 (PH1), Y_MCU1.3
PINIO_CAM: U_MCU1.58 (PD11)
PINIO_VTX: U_MCU1.57 (PD10)
PWM_1: R5.1, U_MCU1.22 (PA0)
PWM_2: R6.1, U_MCU1.23 (PA1)
PWM_3: R9.1, U_MCU1.24 (PA2)
PWM_4: R10.1, U_MCU1.25 (PA3)
PWM_5: R11.1, U_MCU1.34 (PB0)
PWM_6: R12.1, U_MCU1.35 (PB1)
PWM_7: R13.1, U_MCU1.65 (PC8)
PWM_8: R14.1, U_MCU1.66 (PC9)
S1: CON_pwm1.1, R5.2
S2: CON_pwm2.1, R6.2
S3: CON_pwm3.1, R9.2
S4: CON_pwm4.1, R10.2
S5: CON_pwm5.1, R11.2
S6: CON_pwm6.1, R12.2
S7: CON_pwm7.1, R13.2
S8: CON_pwm8.1, R14.2
SPI1_MISO_PIN: U_IMU1.1 (SDO), U_MCU1.30 (PA6)
SPI1_MOSI_PIN: U_IMU1.14 (SDX), U_MCU1.31 (PA7)
SPI1_SCK_PIN: U_IMU1.13 (SCX), U_MCU1.29 (PA5)
SPI2_MISO_PIN: U_MCU1.53 (PB14), U_OSD1.11 (SDOUT)
SPI2_MOSI_PIN: U_MCU1.54 (PB15), U_OSD1.9 (SDIN)
SPI2_SCK_PIN: U_MCU1.52 (PB13), U_OSD1.10 (SCLK)
SPI3_MISO_PIN: U_MCU1.79 (PC11), U_flash1.2 (DO(IO1))
SPI3_MOSI_PIN: U_MCU1.36 (PB2), U_flash1.5 (DI(IO0))
SPI3_NSS_PIN: U_MCU1.77 (PA15), U_flash1.1 (/CS)
SPI3_SCK_PIN: U_MCU1.78 (PC10), U_flash1.6 (CLK)
SWCLK: U_MCU1.76 (PA14)
SWDIO: U_MCU1.72 (PA13)
UART1_RX_PIN: J8.1, U_MCU1.69 (PA10)
UART1_TX_PIN: J9.1, U_MCU1.68 (PA9)
UART2_RX_PIN: U_MCU1.87 (PD6)
UART2_TX_PIN: U_MCU1.86 (PD5)
UART3_RX_PIN: J10.1, U_MCU1.56 (PD9)
UART3_TX_PIN: J11.1, U_MCU1.55 (PD8)
UART4_RX_PIN: J12.1, U_MCU1.95 (PB8)
UART4_TX_PIN: J13.1, U_MCU1.96 (PB9)
UART5_RX_PIN: J14.1, U_MCU1.83 (PD2)
UART5_TX_PIN: J15.1, U_MCU1.80 (PC12)
UART6_RX_PIN: U_MCU1.64 (PC7)
UART6_TX_PIN: U_MCU1.63 (PC6)
UART7_RX_PIN: U_MCU1.37 (PE7)
UART7_TX_PIN: U_MCU1.38 (PE8)
UART8_RX_PIN: U_MCU1.97 (PE0)
UART8_TX_PIN: U_MCU1.98 (PE1)
USB+: J_USB1.A6 (DP1), J_USB1.B6 (DP2), R2.1
USB-: J_USB1.A7 (DN1), J_USB1.B7 (DN2), R1.1
USB_FS_D+: R2.2, U_MCU1.71 (PA12)
USB_FS_D-: R1.2, U_MCU1.70 (PA11)
VIDIN: C_osd4.2, U_OSD1.22 (VIN)
VIDOUT: C_osd5.1, U_OSD1.26 (VOUT)
WS2811_LED_PIN: R_ws2811.2, U_MCU1.67 (PA8)
beep: R_beep1.1, TP2.1
vBAT2: J7.1, R_adc1.1
vcap1: C_vcap1.1, U_MCU1.48 (VCAP)
vcap2: C_vcap2.1, U_MCU1.73 (VCAP)
vidOutC: C_osd5.2, C_osd6.1, R_osd2.2
videoIn: C_osd4.1, J1.1, R_osd1.1
videoOut: J3.1, R_osd2.1

Notes on the sheet:
STM32H743VIT (max.620mA --> 400mA)
DPS310 I2C address: 0x76h (SDO->GND)
Note: VDDA filtering removed
Review/change: - check for non-5V tolerant (TT) pins usage --> finding: 35 (PWM 6), 37/38 (UART7) non FT pins: 17,18,28,29,31-33, 35, 37-39 - checked: 17/18 (ADC), 28/29/31 (SPI), 32/33 (NC), 39 (NC)
ESR<100mO
Decoupling STM32
Review : - Silent Mode config: S to header or switch for GND<->5V?
LEDs / Beeper
- Ref. schematic: CUAV https://github.com/cuav/hardware/tree/master/X7_Autopilot
ADC Chn3: RSSI (0-3.3V)
Check: - ADC2-4: direct to pin??? - ADC1: voltage scale/divider
Goal: - Peak to peak noise: <50uV - PSRR >70dB down as low as 1Hz
3.3V rail 1: 5V->3.3V LDO - MCU --> max.500mA
- LED 0 & 1: FC status - LED 2: 3V3 status
Matek MP9943 ????
3.3V rail 2: 5V->3.3V LDO - onboard max. 140mA(OSD) + ??? - offboard (GPS,...): <100mA --> max xxxmA
USB
SPI2: OSD (<200mA)
ToDo: - 10V / 2A - optionally connected to PINIO driven pit switches, and/or jumper pad setups that enable end users to select constant-on or transistor switched behavior, particularly if located to support video transmission systems. - 5V: - 1.5-2A -------------- choice: TPS54202DDCR MP9943
I2C1: Baro (/Airspeed sensor/OLED)
UARTs
Servo
ADC Chn4: Air Speed Sensor (0-3.3V)
ADC Chn1: VBAT: Battery Voltage Sensor 2K:15K (INAV scale: 850->0~28V) -->1S-6S Note: ADC pin max 3.6V
Debug: CAN-FD TJA1057GTK/3Z
SPI3: BlackBox 128MByte (xx mA)
Boot
Debug: SWD
Change: - vertical --> horizontal connector C167321 Check: TVS dioden C15999?
Check R's depending on diode
I2C: 0x0D
INAV Target requirements: https://github.com/iNavFlight/inav/blob/master/docs/policies/NEW_HARDWARE_POLICY.md Betaflight manufacturer notes: https://betaflight.com/docs/development/manufacturer/manufacturer-design-guidelines EasyEDA: FC: https://easyeda.com/editor#id=b315593411c445e58b1cad039383aee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
Power Circuitry Vbat -> 10V/12V, 5V, Vx (5/6/7.2)
Power Circuitry 5V -> 3.3V
- If INTs not used, do not connect. - CSB: internal 100kO pullup
ADC Chn2: current meter (0-3.3V)
!! this is not MAX7456 (5V), but AT7456 (clone, 3.3V)
Camera switching
REVIEW needed: Check again for correct SPI interface!
Magnetometer: I2C1
(2uA)
I2C1 /I2C2 Termination
ADCs
SPI1: IMU BMI270
