MomoRC-tech/MoGliFC-Flight-Controller/development/10_KiCAD FC/MoGliFC/expressLRS.kicad_sch

## KiCad design development/10_KiCAD FC/MoGliFC/expressLRS.kicad_sch (2024-08-12, an earlier design)

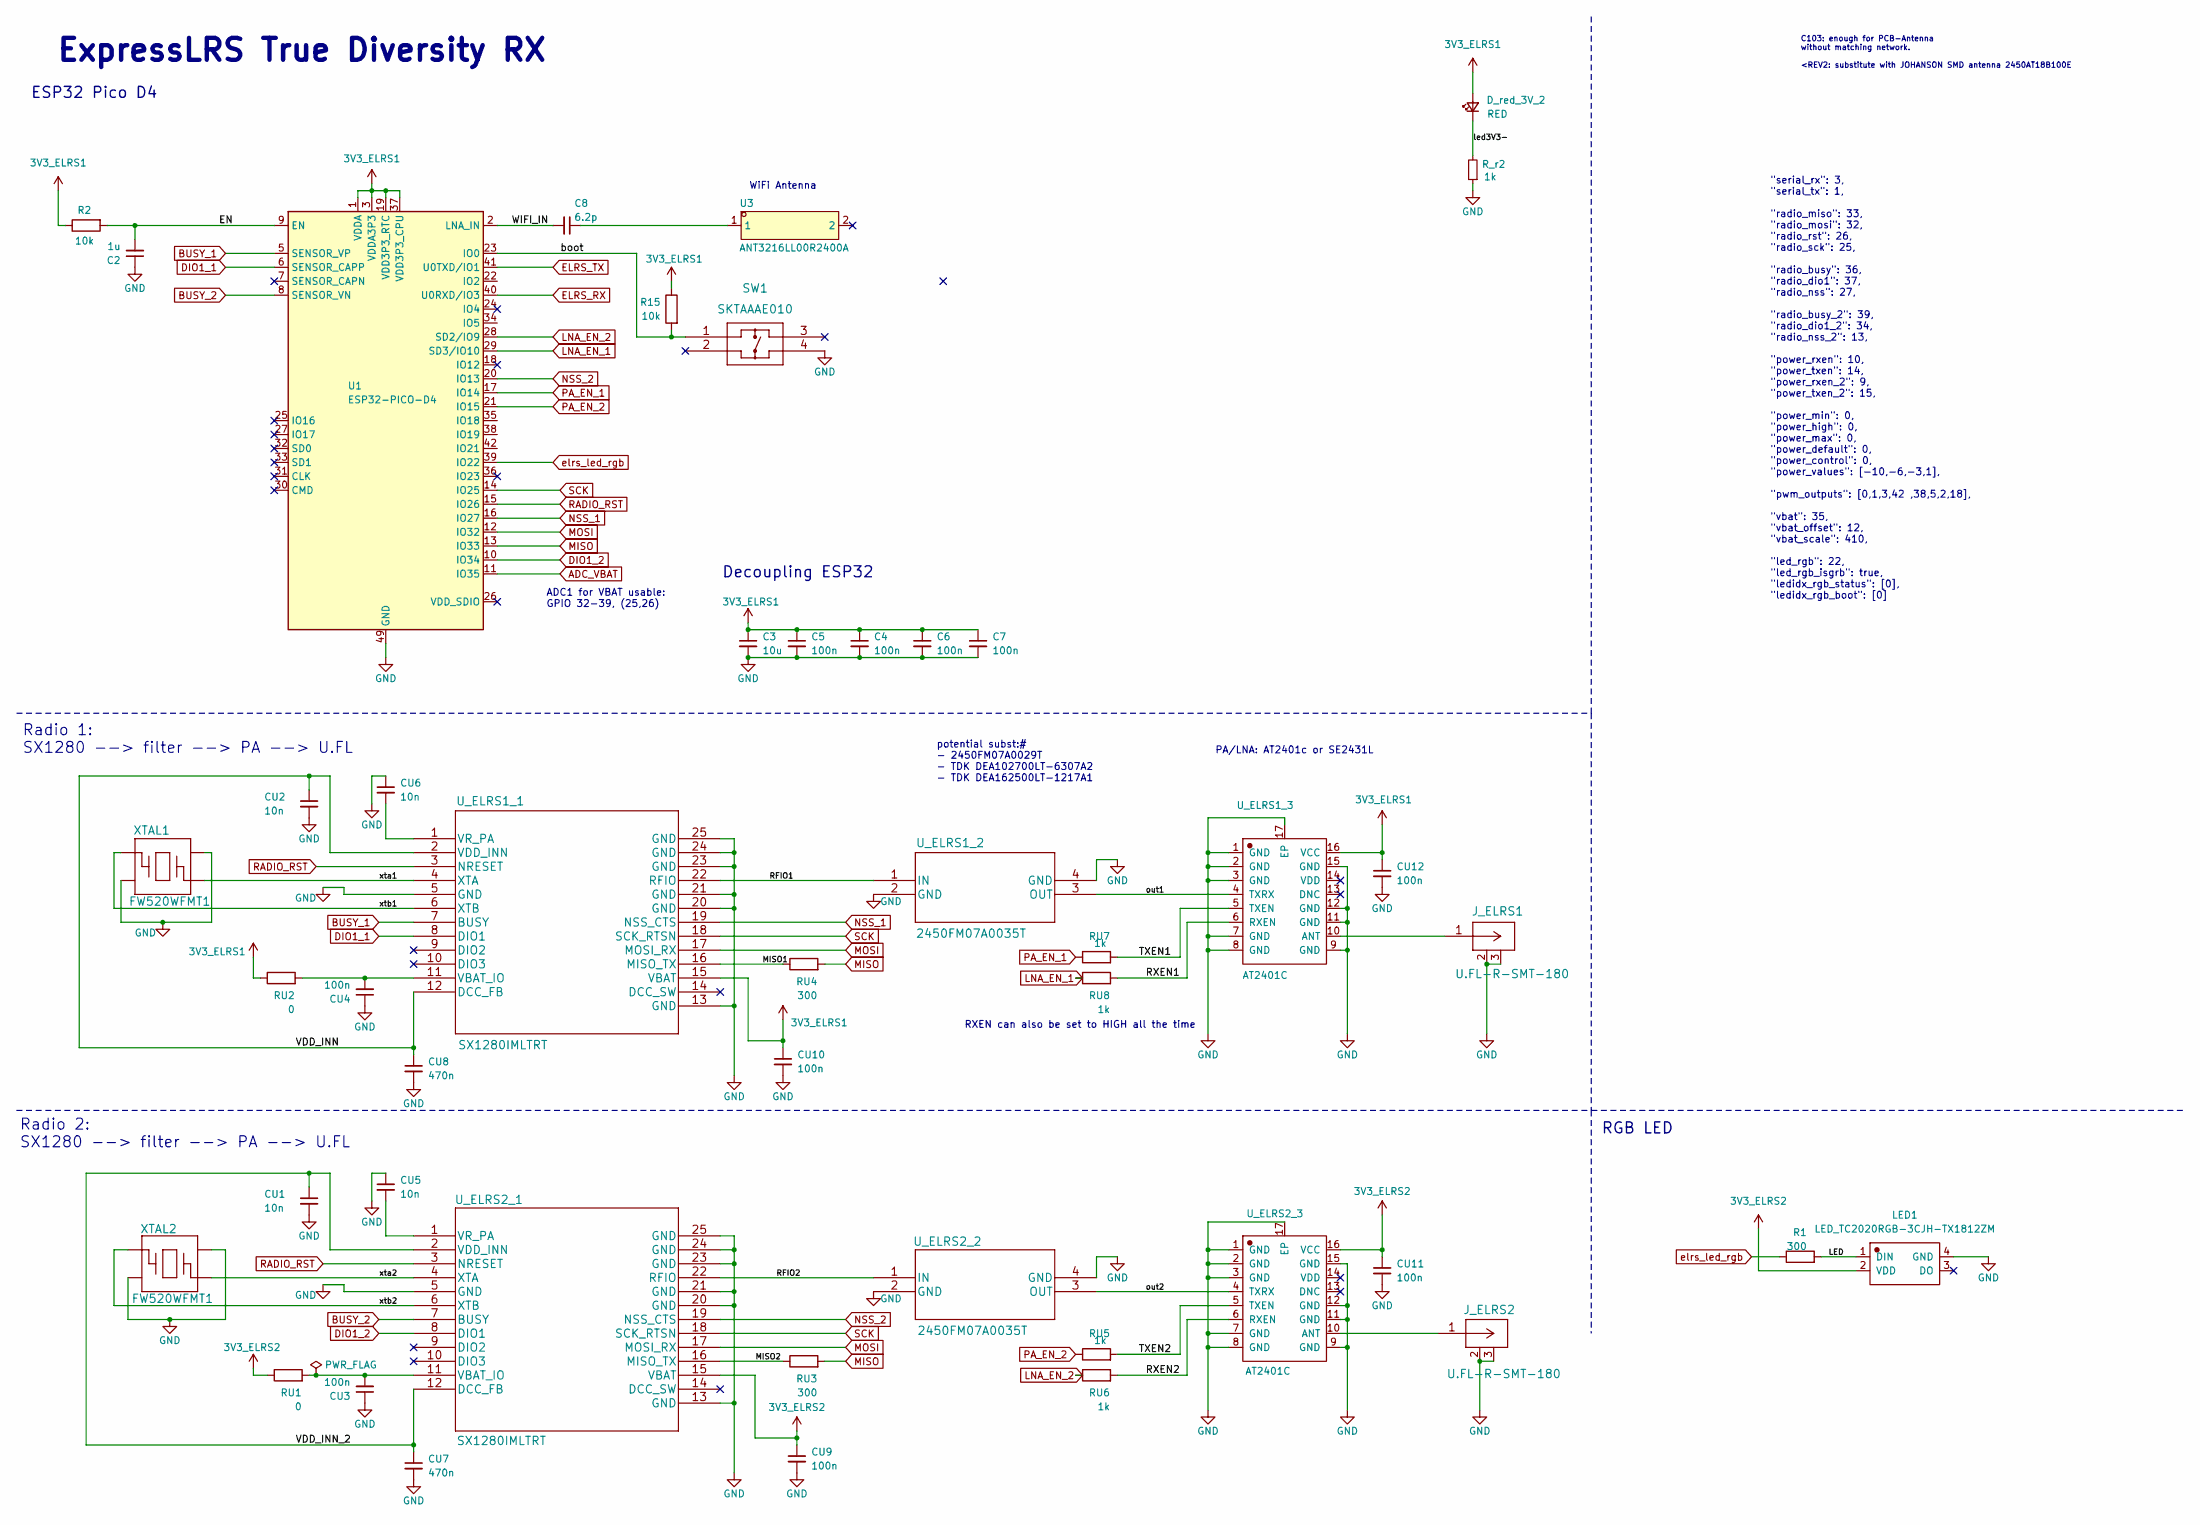
[picture p55: schematic expressLRS.kicad_sch]

Parts:
C2: 1u; C_0402_1005Metric; LCSC Part # C52923
C3: 10u; C_0603_1608Metric; LCSC Part # C96446
C4, C5, C6, C7: 100n; C_0402_1005Metric; LCSC Part # C1525
C8: 6.2p; C_0603_1608Metric; LCSC Part # C41744
CU1, CU2, CU5, CU6: 10n; C_0402_1005Metric; LCSC Part # C15195
CU3, CU4, CU9, CU10, CU11, CU12: 100n; C_0402_1005Metric; LCSC Part # C1525
CU7, CU8: 470n; C_0402_1005Metric; LCSC Part # C47339
D_red_3V_2: RED; LED_0603_1608Metric
J_ELRS1, J_ELRS2: U.FL-R-SMT-180; CONN1_U.FL-R-SMT-180_HIR; LCSC Part # C88374
LED1: LED_TC2020RGB-3CJH-TX1812ZM; LED-SMD_4P-L2.1-W2.1-TL_TC2020RGB
R1: 300; R_0603_1608Metric; JLCPCB BOM xx
R2, R15: 10k; R_0402_1005Metric; JLCPCB BOM xx
RU1, RU2: 0; R_0402_1005Metric; LCSC Part # C17168
RU3, RU4: 300; R_0402_1005Metric; JLCPCB BOM xx
RU5, RU6, RU7, RU8: 1k; R_0402_1005Metric; JLCPCB BOM xx
R_r2: 1k; R_0603_1608Metric_Pad0.98x0.95mm_HandSolder
SW1: SKTAAAE010; LCSC Part # C358616
U1: ESP32-PICO-D4; QFN-48-1EP_7x7mm_P0.5mm_EP5.3x5.3mm; JLCPCB BOM xx
U3: ANT3216LL00R2400A; ANT-SMD_L3.2-W1.6; LCSC Part C293767
U_ELRS1_1, U_ELRS2_1: SX1280IMLTRT; JLCPCB BOM --
U_ELRS1_2, U_ELRS2_2: 2450FM07A0035T; elrs filter 2450FM07A0035T; JLCPCB BOM --
U_ELRS1_3, U_ELRS2_3: AT2401C; AT2401C_QFN-16_L3.0-W3.0-P0.50-BL-EP1.7; JLCPCB BOM xx
XTAL1, XTAL2: FW520WFMT1; JLCPCB BOM --

Connections:
3V3_ELRS1: C3.1, C4.1, C5.1, C6.1, C7.1, CU10.1, CU12.1, D_red_3V_2.2 (A), R2.1, R15.1, RU2.1, U1.1 (VDDA), U1.3 (VDDA3P3), U1.4 (VDDA3P3), U1.19 (VDD3P3_RTC), U1.37 (VDD3P3_CPU), U1.43 (VDDA), U1.46 (VDDA), U_ELRS1_1.15 (VBAT), U_ELRS1_3.16 (VCC)
3V3_ELRS2: CU9.1, CU11.1, LED1.2 (VDD), RU1.1, U_ELRS2_1.15 (VBAT), U_ELRS2_3.16 (VCC)
ADC_VBAT: U1.11 (IO35)
BUSY_1: U1.5 (SENSOR_VP), U_ELRS1_1.7 (BUSY)
BUSY_2: U1.8 (SENSOR_VN), U_ELRS2_1.7 (BUSY)
DIO1_1: U1.6 (SENSOR_CAPP), U_ELRS1_1.8 (DIO1)
DIO1_2: U1.10 (IO34), U_ELRS2_1.8 (DIO1)
ELRS_RX: U1.40 (U0RXD/IO3)
ELRS_TX: U1.41 (U0TXD/IO1)
EN: C2.2, R2.2, U1.9 (EN)
GND: C2.1, C3.2, C4.2, C5.2, C6.2, C7.2, CU1.2, CU2.2, CU3.1, CU4.1, CU5.1, CU6.1, CU7.2, CU8.2, CU9.2, CU10.2, CU11.2, CU12.2, J_ELRS1.2 (GND), J_ELRS1.3 (GND), J_ELRS2.2 (GND), J_ELRS2.3 (GND), LED1.4 (GND), R_r2.1, SW1.4, U1.49 (GND), U_ELRS1_1.5 (GND), U_ELRS1_1.13 (GND), U_ELRS1_1.20 (GND), U_ELRS1_1.21 (GND), U_ELRS1_1.23 (GND), U_ELRS1_1.24 (GND), U_ELRS1_1.25 (GND), U_ELRS1_2.2 (GND), U_ELRS1_2.4 (GND), U_ELRS1_3.1 (GND), U_ELRS1_3.2 (GND), U_ELRS1_3.3 (GND), U_ELRS1_3.7 (GND), U_ELRS1_3.8 (GND), U_ELRS1_3.9 (GND), U_ELRS1_3.11 (GND), U_ELRS1_3.12 (GND), U_ELRS1_3.15 (GND), U_ELRS1_3.17 (EP), U_ELRS2_1.5 (GND), U_ELRS2_1.13 (GND), U_ELRS2_1.20 (GND), U_ELRS2_1.21 (GND), U_ELRS2_1.23 (GND), U_ELRS2_1.24 (GND), U_ELRS2_1.25 (GND), U_ELRS2_2.2 (GND), U_ELRS2_2.4 (GND), U_ELRS2_3.1 (GND), U_ELRS2_3.2 (GND), U_ELRS2_3.3 (GND), U_ELRS2_3.7 (GND), U_ELRS2_3.8 (GND), U_ELRS2_3.9 (GND), U_ELRS2_3.11 (GND), U_ELRS2_3.12 (GND), U_ELRS2_3.15 (GND), U_ELRS2_3.17 (EP), XTAL1.2, XTAL1.4, XTAL2.2, XTAL2.4
LED: LED1.1 (DIN), R1.2
LNA_EN_1: RU8.1, U1.29 (SD3/IO10)
LNA_EN_2: RU6.1, U1.28 (SD2/IO9)
MISO: RU3.2, RU4.2, U1.13 (IO33)
MISO1: RU4.1, U_ELRS1_1.16 (MISO_TX)
MISO2: RU3.1, U_ELRS2_1.16 (MISO_TX)
MOSI: U1.12 (IO32), U_ELRS1_1.17 (MOSI_RX), U_ELRS2_1.17 (MOSI_RX)
NSS_1: U1.16 (IO27), U_ELRS1_1.19 (NSS_CTS)
NSS_2: U1.20 (IO13), U_ELRS2_1.19 (NSS_CTS)
unnamed: C8.1, U3.1
unnamed: CU3.2, RU1.2, U_ELRS2_1.11 (VBAT_IO)
unnamed: CU4.2, RU2.2, U_ELRS1_1.11 (VBAT_IO)
unnamed: CU5.2, U_ELRS2_1.1 (VR_PA)
unnamed: CU6.2, U_ELRS1_1.1 (VR_PA)
unnamed: J_ELRS1.1, U_ELRS1_3.10 (ANT)
unnamed: J_ELRS2.1, U_ELRS2_3.10 (ANT)
PA_EN_1: RU7.1, U1.17 (IO14)
PA_EN_2: RU5.1, U1.21 (IO15)
RADIO_RST: U1.15 (IO26), U_ELRS1_1.3 (NRESET), U_ELRS2_1.3 (NRESET)
RFIO1: U_ELRS1_1.22 (RFIO), U_ELRS1_2.1 (IN)
RFIO2: U_ELRS2_1.22 (RFIO), U_ELRS2_2.1 (IN)
RXEN1: RU8.2, U_ELRS1_3.6 (RXEN)
RXEN2: RU6.2, U_ELRS2_3.6 (RXEN)
SCK: U1.14 (IO25), U_ELRS1_1.18 (SCK_RTSN), U_ELRS2_1.18 (SCK_RTSN)
TXEN1: RU7.2, U_ELRS1_3.5 (TXEN)
TXEN2: RU5.2, U_ELRS2_3.5 (TXEN)
VDD_INN: CU2.1, CU8.1, U_ELRS1_1.2 (VDD_INN), U_ELRS1_1.12 (DCC_FB)
VDD_INN_2: CU1.1, CU7.1, U_ELRS2_1.2 (VDD_INN), U_ELRS2_1.12 (DCC_FB)
WIFI_IN: C8.2, U1.2 (LNA_IN)
boot: R15.2, SW1.1, U1.23 (IO0)
elrs_led_rgb: R1.1, U1.39 (IO22)
led3V3-: D_red_3V_2.1 (K), R_r2.2
out1: U_ELRS1_2.3 (OUT), U_ELRS1_3.4 (TXRX)
out2: U_ELRS2_2.3 (OUT), U_ELRS2_3.4 (TXRX)
xta1: U_ELRS1_1.4 (XTA), XTAL1.3
xta2: U_ELRS2_1.4 (XTA), XTAL2.3
xtb1: U_ELRS1_1.6 (XTB), XTAL1.1
xtb2: U_ELRS2_1.6 (XTB), XTAL2.1

Notes on the sheet:
ESP32 Pico D4
PA/LNA: AT2401c or SE2431L
potential subst:# - 2450FM07A0029T - TDK DEA102700LT-6307A2 - TDK DEA162500LT-1217A1
WiFi Antenna
ADC1 for VBAT usable: GPIO 32-39, (25,26)
Radio 2: SX1280 --> filter --> PA --> U.FL
"serial_rx": 3, "serial_tx": 1, "radio_miso": 33, "radio_mosi": 32, "radio_rst": 26, "radio_sck": 25, "radio_busy": 36, "radio_dio1": 37, "radio_nss": 27, "radio_busy_2": 39, "radio_dio1_2": 34, "radio_nss_2": 13, "power_rxen": 10, "power_txen": 14, "power_rxen_2": 9, "power_txen_2": 15, "power_min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
C103: enough for PCB-Antenna without matching network. <REV2: substitute with JOHANSON SMD antenna 2450AT18B100E
RXEN can also be set to HIGH all the time
Decoupling ESP32
ExpressLRS True Diversity RX
Radio 1: SX1280 --> filter --> PA --> U.FL
RGB LED
