MomoRC-tech/MoGliFC-Flight-Controller/development/10_KiCAD FC/MoGliFC/untitled.kicad_sch

## KiCad design development/10_KiCAD FC/MoGliFC/untitled.kicad_sch (2024-08-09, an earlier design)

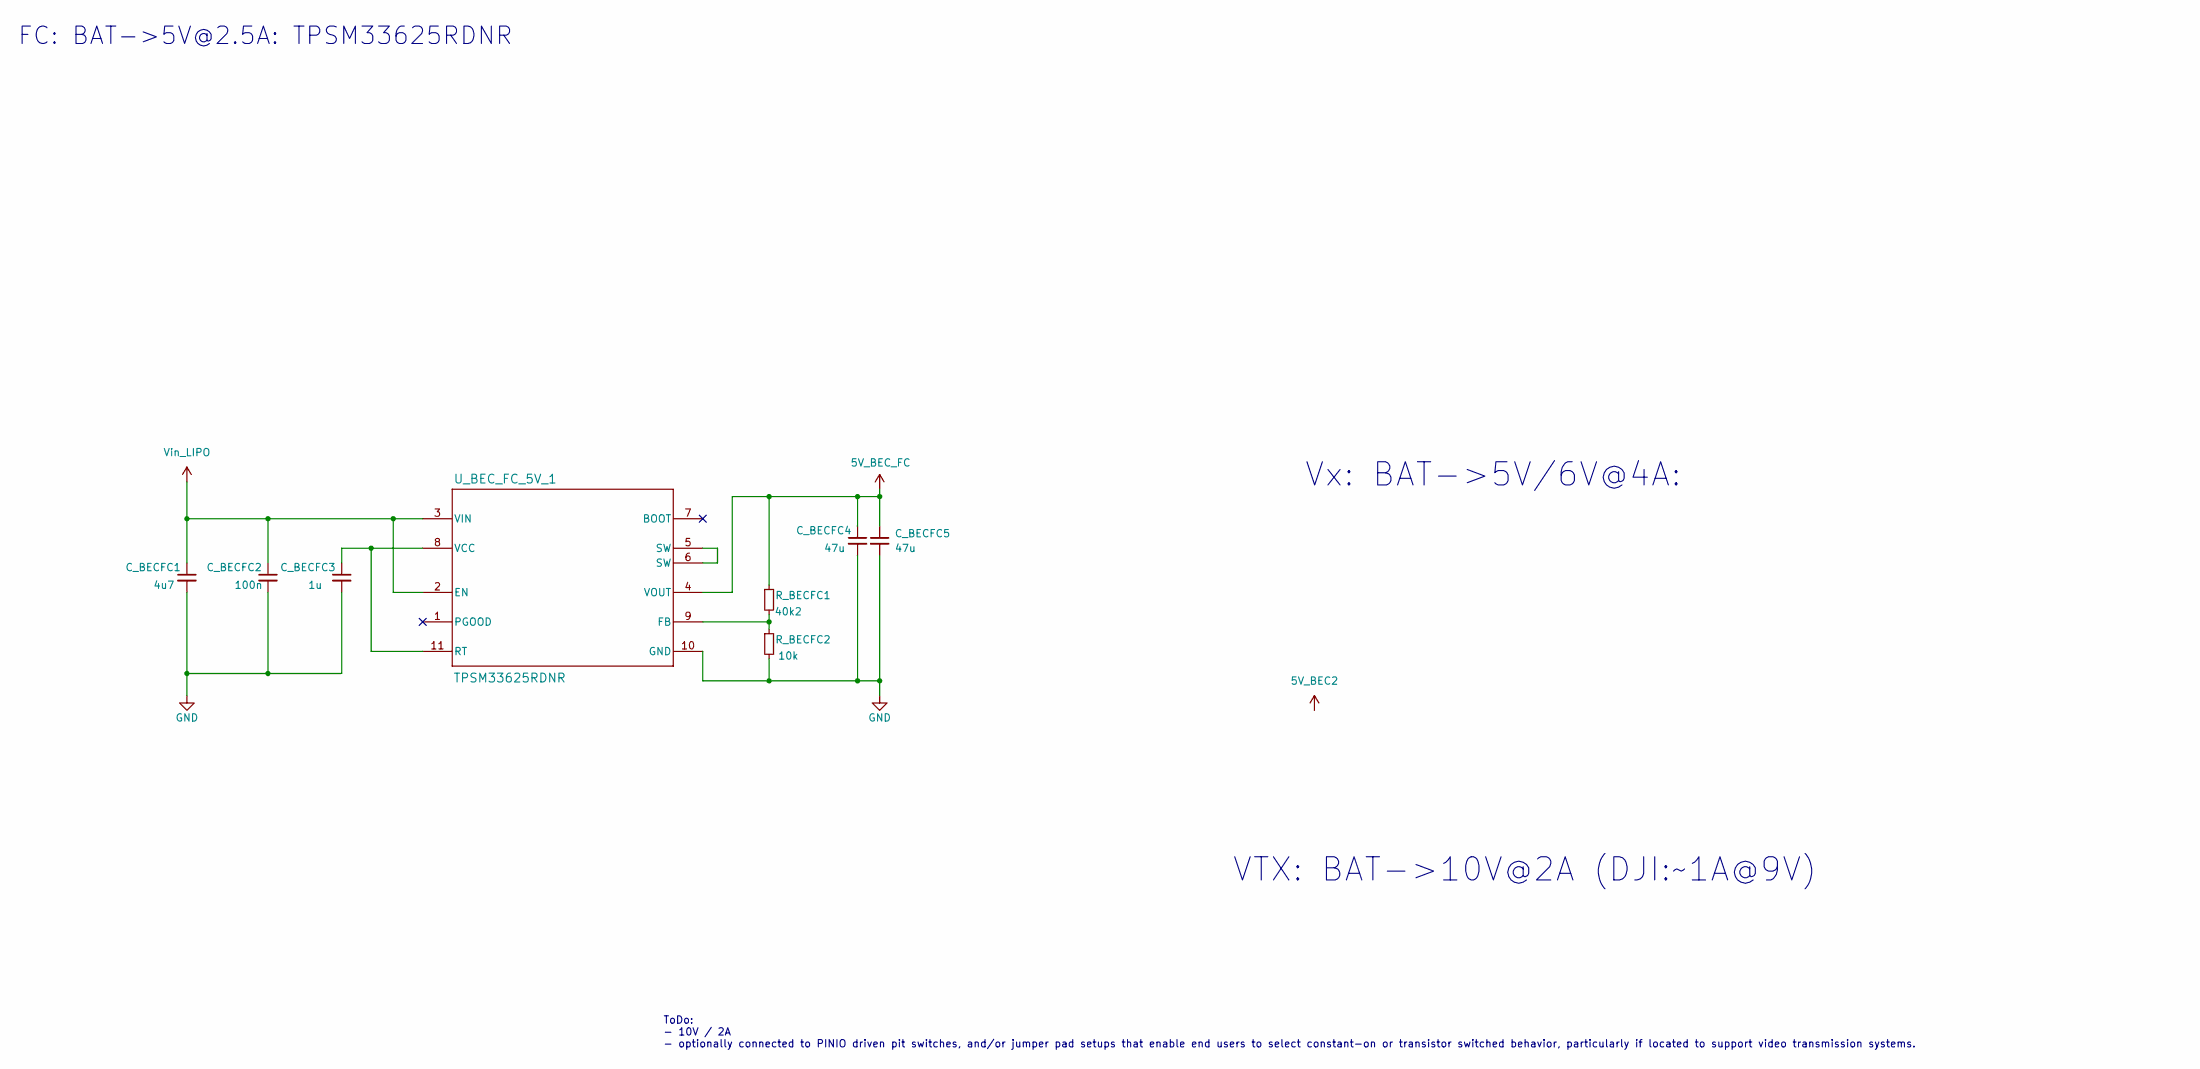
[picture p56: schematic untitled.kicad_sch]

Parts:
C_BECFC1: 4u7; C_1206_3216Metric
C_BECFC2: 100n; C_1206_3216Metric
C_BECFC3: 1u; C_1206_3216Metric
C_BECFC4, C_BECFC5: 47u; C_1206_3216Metric
R_BECFC1: 40k2; R_0402_1005Metric; LCSC Part # C25133
R_BECFC2: 10k; R_0402_1005Metric; LCSC Part # C25133
U_BEC_FC_5V_1: TPSM33625RDNR; RDN0011A-MFG

Connections:
5V_BEC_FC: C_BECFC4.1, C_BECFC5.1, R_BECFC1.1, U_BEC_FC_5V_1.4 (VOUT)
GND: C_BECFC1.2, C_BECFC2.2, C_BECFC3.2, C_BECFC4.2, C_BECFC5.2, R_BECFC2.2, U_BEC_FC_5V_1.10 (GND)
unnamed: C_BECFC3.1, U_BEC_FC_5V_1.8 (VCC), U_BEC_FC_5V_1.11 (RT)
unnamed: R_BECFC1.2, R_BECFC2.1, U_BEC_FC_5V_1.9 (FB)
unnamed: U_BEC_FC_5V_1.5 (SW), U_BEC_FC_5V_1.6 (SW)
Vin_LIPO: C_BECFC1.1, C_BECFC2.1, U_BEC_FC_5V_1.2 (EN), U_BEC_FC_5V_1.3 (VIN)

Notes on the sheet:
Vx: BAT->5V/6V@4A:
VTX: BAT->10V@2A (DJI:~1A@9V)
ToDo: - 10V / 2A - optionally connected to PINIO driven pit switches, and/or jumper pad setups that enable end users to select constant-on or transistor switched behavior, particularly if located to support video transmission systems.
FC: BAT->5V@2.5A: TPSM33625RDNR
