MomoRC-tech/MoGliFC-Flight-Controller/development/03_STM32 CubeMX project/03_STM32 CubeMX project.ioc

Mcu.UserName=STM32H743VIHx
PA0.Signal=GPIO_Input
PA1.Signal=GPIO_Input
PA10.Signal=USART1_RX
PA11.Signal=USB_OTG_FS_DM
PA12.Signal=USB_OTG_FS_DP
PA2.Signal=GPIO_Input
PA3.Signal=GPIO_Input
PA4.Signal=SPI1_NSS
PA5.Signal=SPI1_SCK
PA6.Signal=SPI1_MISO
PA7.Signal=SPI1_MOSI
PA8.Signal=GPIO_Input
PA9.Signal=USART1_TX
PB0.Signal=GPIO_Input
PB1.Signal=GPIO_Input
PB10.Signal=I2C2_SCL
PB11.Signal=I2C2_SDA
PB12.Signal=SPI2_NSS
PB13.Signal=SPI2_SCK
PB14.Signal=SPI2_MISO
PB15.Signal=SPI2_MOSI
PB5.Signal=SPI3_MOSI
PB6.Signal=I2C1_SCL
PB7.Signal=I2C1_SDA
PB8.Signal=UART4_RX
PB9.Signal=UART4_TX
PC0.Signal=ADCx_INP10
PC1.Signal=ADCx_INP11
PC10.Signal=SPI3_SCK
PC11.Signal=SPI3_MISO
PC12.Signal=UART5_TX
PC2_C.Signal=ADC3_INP0
PC3_C.Signal=ADC3_INP1
PC6.Signal=USART6_TX
PC7.Signal=USART6_RX
PC8.Signal=GPIO_Output
PC9.Signal=GPIO_Output
PD0.Signal=FDCAN1_RX
PD1.Signal=FDCAN1_TX
PD10.Signal=GPIO_Output
PD11.Signal=GPIO_Output
PD2.Signal=UART5_RX
PD5.Signal=USART2_TX
PD6.Signal=USART2_RX
PD8.Signal=USART3_TX
PD9.Signal=USART3_RX
PE0.Signal=UART8_RX
PE1.Signal=UART8_TX
PE3.Signal=GPIO_Output
PE4.Signal=GPIO_Output
PE5.Signal=GPIO_Output
PE7.Signal=UART7_RX
PE8.Signal=UART7_TX
