MomoRC-tech/MoGliFC-Flight-Controller/(commit log)

2024-07-17 PCB_concept.drawio aktualisiert
2024-07-17 PCB_concept.svg aktualisiert
2024-07-17 Delete documentation/images/PCB_concept.drawio
    --> svg in markdown doc is now editable online, see link at bottom of picture
2024-07-31 update datasheets and docu
    [Requirements.xlsx]
2024-08-04 schematic update
    [EDI2CAP.CFG, MoGliFC.kicad_sch, Requirements.xlsx, TFBGA100.step, U263-241N-4BQC11-1.stp, chips.prt, u263241n4bqc111.psm, untitled.kicad_sch]
2024-08-08 update all
    [MoGliFC.kicad_sch, SMA_L4.4-W2.6-LS5.0-RD.step, defines_INAV_H7_targets.xlsx, untitled.kicad_sch]
2024-08-09 schematic update ELRS
    [AT2401C_QFN-16_L3.0-W3.0-H0.9-P0.50.step, ESP32-PICO-D4_EXP.step, FILTER-SMD_0402-4P-L1.0-W0.5-L.step, IPEX U.FL-R-SMT-IPEX U.step, MoGliFC.kicad_sch, SX1280IMLTRT_QFN24_4X4_SEM.step, expressLRS.kicad_sch, untitled.kicad_sch]
